adxb-pxthxn/pizza-oven/design/stream-1/README.md

# Stream 1

Long-vault prototypes after Morning and Moondancer. Gas, 15 inch pizza, no cordierite. The chamber is a rolled half-barrel, not a hemisphere. A stainless sky plate slides under the crown: in for pizza and bread, out for a broil. The floor is a free 6 mm normalised mild-steel plate. Jarrah and gidgee are the handles, the peel rest, the door pull, and the ferrules. The body is a 304 liner, ceramic-fibre blanket, an 8 mm air gap, and an aluminium skin.

Cool-down is the open door, sky plate lifted out, steel from its pizza equilibrium down to 60°C. The Tread figure is a 2.8 kg cordierite deck from 400°C through a lower mouth. Heat-up is a 6 kW burner with 35% of the fuel staying in the metal and the hot third of the blanket.

| | Tread | Morning | Moondancer | Stormcloud | Tyraxes | Arrax | Vermithor |
|---|---|---|---|---|---|---|---|
| Ready mass | 13.5 kg | 19.2 kg | 15.8 kg | 34.2 kg | 34.1 kg | 35.4 kg | **38.0 kg** |
| Plan | — | Ø572 × ~260 tall | Ø547 × ~250 tall | 973 × 670 × 410 | 928 × 714 × 410 | 990 × 714 × 410 | **1090 × 714 × 435** |
| Floor | stone | cordierite Ø420 × 15 | cordierite Ø420 × 15 | 450 × 500 × 6 | same plate | 480 × 500 × 6 | **same, 4 mm stops** |
| Mouth | low | 420 × 95 | 420 × 95 | arch shut | arch open | open, 90 mm sill | **open, grate in the arch** |
| Crown | — | apex 165 | apex 165 | r 250, L 680 | L 680 | L 680 | **L 780** |
| Skin | hot | 50°C wood | 55°C aluminium | 55.1°C | 55.1°C | 55.1°C | **55.1°C** |
| Underside | — | 60°C | 60°C | 55°C | 54°C | 54°C | **45°C pizza, 56°C bay** |
| Pizza floor | — | stone ~430°C | stone ~430°C | 309°C, gas 370°C | 301°C, gas 360°C | 301°C | **305°C, gas 360°C** |
| Scorch time | — | — | — | 122 s | 130 s | 130 s | **126 s** |
| Broil | — | — | — | 10.6 kW/m² | 10.6 kW/m² | 10.6 kW/m² | **10.6 kW/m², 240 mm bay** |
| Bread floor | — | — | — | 240°C shut | 240°C shut | 240°C shut | **216°C at gas 230°C** |
| Camber | — | — | — | 0.003 mm | 0.003 mm | 0.003 mm | **0.003 mm** |
| Open cool-down | benchmark | — | — | 42 min, 0.67× | 42 min, 0.66× | 42 min, 0.66× | **42 min, 0.67× Tread** |
| Heat-up | — | — | — | 23 min open | 22 / 14 min | 23 / 15 min | **24 min open, 15 min shut** |
| Carry | one person | tub | tub | two people | two people | two people | **two people, side handles** |
| Broil bay | — | — | — | — | — | plate covers the deck | **240 mm, plate slid back** |

Stormcloud is over the old 20 kg cap because the steel deck is 10.6 kg and the blanket is 75 mm on the arch. The cap was for a cordierite dome. A 6 mm plate is the thin end of the warp limit. The extra mass is the pizza steel and the fibre, not a timber costume.

Tyraxes is the pizza pose of that barrel. The door is parked on the port cheek, 3 mm clear of the skin, so the front view is the mouth. The burner cowl is 48 mm deep instead of 80 mm. Gas at 360°C holds the floor at 301°C, which gives 130 s before the face reaches 230°C. Door-shut heat-up is 14 min.

Arrax widens the plate to 480 mm inside the 500 mm barrel. The side gap is 10 mm against 1.95 mm of growth. Four stainless stops sit 4 mm off the plate, below the deck, so a launch cannot walk the plate onto the sill. The sill is 400 × 90 × 1.2 mm, 1 mm under the deck, 127 mm clear of the cold plate. Turning clearance is 49 mm each side of a 15 inch pizza. The extra kilogram is the wider plate.

Vermax lengthens the barrel to 780 mm so the same plate can slide back and leave a 240 mm bay. Five 4 mm rods sit in that bay, 20 mm below the mouth crown, so the front view shows the grate. Pizza numbers are with the plate slid forward. A 10 kW/m² crown on the bare bay still cambers a 6 mm plate by about 0.02 mm. The extra mass is shell, not deck. Cool-down stays 0.66× the Tread. Shut heat-up is 15 min.

Tessarion is that barrel with the plate forward and the door shut. The door bottom is at 63.4 mm and the sill top is at 60.4 mm, so the shop gap is 3 mm. Ready mass is 37.3 kg, the same as Vermax, because the rails run the full slide in both poses and the grate stays in the bay. The plate clears the rods when it slides forward. The earlier 214°C bread figure treated the mouth as open. Shut, gas at 260°C holds the floor at 240°C.

Sunfyre is the bread gas, 230°C, on this barrel.

Seasmoke is that oven with the handle load taken off the skin. A 2 mm stainless strap on each cheek, 0.4 mm clear of the aluminium, runs from the base wall up past the grip. The posts land on the strap. A 20 mm module is scribed on the sill and not on the cooking steel. A 160 × 120 mm steel tray sits in the broil bay, 44 mm under the grate. Parked, it sits outside the port skin, ahead of the grip. Timber battens on the skin were rejected: the skin is 55°C, and the wood stays on the grips. Ready mass is 38.9 kg. The heat figures are Vermithor's.

Sheepstealer is that oven with the skin cut flat. The barrel blank is the mid-thickness arc, 1050 mm, with 12 mm spring-line tabs and 4.2 mm rivets on a 40 mm pitch. The ends are half-rings, 2 mm clear of the liner, 8 mm clear of the fibre, so the blanket is covered and the liner is not bridged to the skin. Earlier masses counted a solid aluminium end the shop never cut; this one is 38.5 kg. A 4 mm K-type gland sits beside the arch, 0.4 mm clear of the liner and 5 mm clear of the fibre. The line under the base reads "be vigilant. don't die." A kick-stand was refused: a tilt walks the free plate onto the stops. One hinge cannot be the grip, the peel ledge, and the door.

Silverwing is that oven with a door that hinges. The arch stays mouth-sized. Two 2 mm straps reach a 8 mm pin at the port front corner, outboard of the skin, so a wing is not doing the reaching. Parked, the door lies along the port side, 31 mm clear of the skin. Shut, the same solid covers the arch and sits 3 mm above the sill and 103 mm clear of the skin. The post is welded to the base. The pin is a clearance fit. Ready mass is 38.7 kg. The heat figures are unchanged.

Grey Ghost is that hinge with a land. Silverwing's post bit the base wall by 90 mm³, a tack in 1 mm sheet. The post now comes down to the floor and laps 40 × 25 mm inside the front corner. The weld is 2173 mm³. The door numbers are unchanged. Ready mass is 38.7 kg.

Caraxes is that oven with a grip the hand can hook. An 11 mm hollow runs the middle 120 mm of each jarrah bar, where the fingers take the load. The top stays full, with a 3 mm arris so the corner does not dig, and the thumb stays off the skin. The end 8 mm is still a rectangle, so the gidgee ferrules press. Ready mass is 38.7 kg. The build now fails if a shell is open, a part is left invalid, or the steel bbox is not 480 × 500 × 6 mm. The shop sheet is `design/stream-1/caraxes/BUILD.md`.

Vermithor is the same heat without the straps or the tray. The floor blanket is 75 mm everywhere, because a step would tilt the plate. A bare broil bay under a 500°C crown runs near 436°C, and 50 mm of fibre let the underside there reach about 70°C. At 75 mm that underside is 56°C. Pizza floor is 305°C, scorch 126 s, pizza underside 45°C. Ready mass is 38.0 kg. Open cool-down is 0.67× the Tread from the pizza floor, and 0.77× even if the whole plate started at bay temperature. Bread gas 230°C, door shut, holds 216°C. Overall 1090 × 714 × 435 mm. Two people, high side handles.

Blanket is 25 mm ceramic fibre (3 on the arch, 2 under the floor). Skin is 1.0 mm aluminium. Air gap is 8 mm so it stays laminar. The plate is AS/NZS 3678-250, normalised, seasoned, not fastened. Stormcloud keeps 25 mm beside the liner. Arrax keeps 10 mm, with stops at 4 mm. Growth at 320°C is 2.0 mm. No zinc. No paint. No cordierite.

Files: `cad/freecad/stream_physics.py`, `cad/freecad/stream_optimize.py`, `optimizer.json`, `thermal-fea.json`.
