adxb-pxthxn/pizza-oven/design/stream-2/README.md

# Stream 2 — modular

Morning and Moondancer stay the round, short baselines. This stream is a stack in the spirit of a Hot Ash cooker: a fire pit, a floating steel hearth, a brow, and a tunnel. Gas only. The bought burner, valve, regulator, and hose are the same parts as the other ovens. No cordierite, no casting, no cut stone.

The floor is a 4 mm mild plate on three microporous pads. It is not bolted. In-plane growth is 1.7 mm and the side gap is 12 mm, so the plate cannot go into compression. Through-thickness bow at a 300°C soak is 0.002 mm. Self-weight sag on the long span is 0.27 mm. A 300°C steel face meets dough at 275°C. Cordierite at 450°C meets it at 289°C. The deck is run at 300°C on purpose.

The flame rises in the rear gutter, washes the soffit, and leaves by a front flue. The mouth is 0.63 of the front crown. At 550°C and a view factor of 0.65 the radiant flux is 13.8 kW/m². On Vhagar that surface is the plate over the steak, carried on 8 mm rods. The rack is 50 mm under it and travels with the plate. Bread uses the door, the damper, and a rope in the door gap. Wood is jarrah grips and feet, and a gidgee peel rest in front of the sill. The firebox walls are bare and run near 390°C. The handles stand off them. A mild plate rides under the rear overhang and stands on the rim when the hood is off. Jarrah panels stand off the brow. The door has 24 mm of air and a jarrah grip, so the face you hold is 54°C and the grip is 23°C. Dreamfyre hangs that door on a port pintle. Cannibal ties the inner plate to the skin, so the pintle carries the whole door. Quicksilver sets the hinge arms outside the door and welds the lower arm to the pit. Urrax stands the hood grip on a mild pad, so the aluminium is not the lift. Terrax does the same for the brow grip and the door grip. Slide the broiler plate aft for the pizza.

Masses are the analytical solid plus the 1.85 kg burner in the pit. Skin and underside are the CalculiX result, which matched the resistance sum. Costs are ESTIMATE, AUD, Adelaide, October 2026, bottle excluded.

Vermax was a tall empty box over a low soffit. Arrax cut the crown to the soffit. Shrykos folded that step. Morghul splits the fold. Seasmoke seats the brow and lifts the grate. Caraxes raises the roof over the pizza. Meleys puts a bail on the sill. Syrax shuts the damper. Sheepstealer puts a rope in the door gap. Vermithor slides the plate forward over the steak. Silverwing keeps that slide and changes the flats for rods. Vhagar stores a wind-back on the pit. Balerion stands jarrah off the brow. Meraxes puts air in the door and a grip on it. Dreamfyre hangs the door on a pintle. Cannibal ties the inner plate to that skin. Quicksilver sets the arms outside the door. Urrax stands the hood grip on a mild pad. Terrax does the same on the brow and on the door.

| | Tread | Morning | Moondancer | Vermax | Arrax | Shrykos | Morghul | Seasmoke | Caraxes | Meleys | Syrax | Sheepstealer | Vermithor | Silverwing | Vhagar | Balerion | Meraxes | Dreamfyre | Cannibal | Quicksilver | Urrax | Terrax |
|---|---|---|---|---|---|---|---|---|---|---|---|---|---|---|---|---|---|---|---|---|---|---|
| Ready mass | 13.5 kg | 19.2 kg | 15.8 kg | 36.1 kg | 32.2 kg | 30.6 kg | 30.6 kg | 31.0 kg | 32.4 kg | 32.5 kg | 32.6 kg | 32.6 kg | 33.8 kg | 33.0 kg | 33.4 kg | 33.5 kg | 33.6 kg | 34.0 kg | 34.0 kg | 34.0 kg | 34.0 kg | **34.1 kg** |
| Heaviest piece | the oven | the oven | the oven | hood 15.9 | hood 12.8 | hood 11.2 | pit 10.4 | pit 10.5 | pit 10.5 | pit 10.5 | pit 10.5 | pit 10.5 | pit 10.5 | pit 10.5 | pit 10.8 | pit 10.8 | pit 10.8 | pit 10.8 | pit 10.8 kg | pit 11.0 kg | pit 11.0 kg | **pit 11.0 kg** |
| Floor | small steel or stone | cordierite | cordierite | floating 4 mm mild | same plate | same plate | same plate | same plate | same plate | same plate | same plate | same plate | same plate | same plate | same plate | same plate | same plate | same plate | same plate | same plate | same plate | **same plate** |
| Mouth | low | 420 × 95 | 420 × 95 | 424 × 161 | 424 × 185 | 424 × 185 | 424 × 185 | 424 × 185 | 424 × 185 | 424 × 185 | 424 × 185 | 424 × 185 | 424 × 185 | 424 × 185 | 424 × 185 | 424 × 185 | 424 × 185 | 424 × 185 | 424 × 185 | 424 × 185 | 424 × 185 | **424 × 185** |
| Envelope | portable dome | Ø572 × ~250 | Ø547 × ~250 | 655 × 824 × 572 | square step | 45° cowl | split fold | shelf at the fold | 150 mm roof | bail on the sill | damper shut | rope in the gap | plate over the steak | 8 mm rods | wind-back stored | jarrah on the brow | grip on the door | pintle on the door | spacers in the door | arms clear the door | pad under the grip | **pad on the brow** |
| Outer skin | hot | 50°C wood | 55°C aluminium | 54.1°C | 55.0°C | 55.0°C | 55.0°C | 55.0°C | 55.0°C | 55.0°C | 55.0°C | 55.0°C | 55.0°C | 55.0°C | 55.0°C | 55.0°C | 55.0°C | 55.0°C | 55.0°C | 55.0°C | 55.0°C | **55.0°C** |
| Heat-up to a 300°C deck | — | — | — | 13 min | 10 min | 10 min | 10 min | 10 min | 11 min | 11 min | 11 min | 11 min | 11 min | 11 min | 11 min | 11 min | 11 min | 11 min | 11 min | 11 min | 11 min | **11 min** |
| Door shut, 240°C to 180°C | — | — | — | 63 min | 59 min | 60 min | 60 min | 60 min | 61 min | 61 min | 61 min | 61 min | 61 min | 61 min | 61 min | 61 min | 61 min | 61 min | 61 min | 61 min | 61 min | **61 min** |
| Door open, deck to 60°C | — | — | — | 27 min | 27 min | 27 min | 27 min | 27 min | 27 min | 27 min | 27 min | 27 min | 27 min | 27 min | 27 min | 27 min | 27 min | 27 min | 27 min | 27 min | 27 min | **27 min** |
| Fire pit | no | no | no | hood off | grate in the pit | grate in the pit | grate in the pit | grill and a deep fire | same pit | hearth lifts by wood | same pit | same pit | same pit | same pit | wind-back on the rim | same pit | same pit | same pit | same pit | same pit | same pit | **same pit** |

Terrax: pit 11.0 kg, hearth 9.1 kg, brow 5.8 kg, tunnel 8.3 kg. The brow grip, the tunnel grip, and the door grip each stand on a 1.5 mm mild pad. Posts sit 7.5 mm inside the edge and 1.5 mm clear of the skin. Quicksilver's pintle stays. The door face is 53.7°C and the grip is 23°C. Panels 21°C. Jarrah stays 3.4 mm off hot steel. The wind-back stays stored at Y 684. The broiler plate is still at Z 100 over Y 180 to 350, on 8 mm rods. The flux is still 13.8 kW/m². Length 871 mm. Pack cool-down is the deck, 27 min with the door open. SLSQP with the roof held reaches 33.3 kg at the 148 mm bound. The shop stack keeps 150 mm and 22 mm board. The door grip pulls the door. It is not a lift.

CalculiX on Terrax: slab 62.11°C against 62.11°C. Hood wall 54.95°C against 54.95°C. Underside 51.06°C against 51.11°C.

Shop: flat 4 mm plate, welded 0.6–1.0 mm mild flats, 0.6 mm aluminium flats. The sheet module is 20 mm for the pads, the wind-back, and a 100 mm rivet pitch. The mouth and the deck stay off it. University TIG. Makerspace lathe for the grips, ferrules, and feet. The CO2 lasers cut templates, not metal. The sequence is `design/stream-2/terrax/BUILD.md`.
