adxb-pxthxn/pizza-oven/design/stream-1/prompts/arrax.md

Arrax is the next long-vault oven after Tyraxes. Do not use tools. Reply in plain text.

The barrel is unchanged: internal radius 250 mm, so the cavity is 500 mm wide at the deck. The pizza is 381 mm. Tyraxes uses a 450 mm steel, which leaves 34.5 mm each side of the pizza.

Arrax widens the free plate to 480 mm. Side gap to the liner is (500 - 480) / 2 = 10 mm. In-plane growth at 320 C along 480 mm is about 1.9 mm. The plate stays free on the same six buttons.

A launch sill is added, stainless, 400 mm wide, 90 mm deep, 1.2 mm thick. It sits entirely forward of the front skin: 2 mm clear of y_front, top face 1 mm below the deck, so a peel slides up onto the floating plate and the plate can still grow. The jarrah peel rest stays lower, on the front wall, and must not touch the sill.

Confirm the 10 mm gap against the growth, and whether the sill can touch the plate. No file writes.
