adxb-pxthxn/pizza-oven/design/stream-1/prompts/caraxes.md

Caraxes is the next long-vault oven after Grey Ghost. Same heat, same door, same flat skin. Do not use tools. Reply in plain text.

The carry grips are jarrah bars, 140 by 28 by 36 mm, with an 8 mm groove along the lower edge. The oven is 38.7 kg, two people. A grip should give the thumb a land, the forefinger a hollow, and the palm some bulk. The end 8 mm of each bar stays a full rectangle so the gidgee ferrules still press on. In the middle 100 mm, an 11 mm radius hollow runs along the lower inner corner, and an 8 by 4 mm step is cut on the top inner edge for the thumb. The wood stays on the 20 mm standoff. It does not move onto the skin.

Is that a grip that earns the cut, or is the step carving for its own sake? A few sentences. No file writes.
