adxb-pxthxn/pizza-oven/design/stream-1/prompts/seasmoke.md

Seasmoke is the next long-vault oven after Vermithor. Do not use tools. Reply in plain text.

Three changes, and one refusal. The skin stays bare aluminium. Timber battens on that skin were considered and rejected: the skin is about 55 C, and wood stays on the grips, the ferrules, the peel rest, and the door pull.

The module is 20 mm, from a sheet grid that divides the 480 mm floor. It is scribed on the launch sill only, 0.3 mm deep. It is not cut into the cooking steel.

Each cheek gets a 2 mm stainless strap on the outside of the skin, 0.4 mm clear of it, from the spring line up past the grip, with a tab down the base wall. The handle posts land on the strap. They do not land on the 1 mm skin, and they do not bridge the insulation to the hot liner.

A stainless tray, 160 by 120 mm, sits in the broil bay 90 mm above the deck, under the grate rods. It is steel, not cast iron. There is no wood on it. Parked, the same tray would sit outside the port skin, ahead of the grip.

Is the strap the right place for the handle load, and is the tray in the bay a real heat tool rather than a symbol? A few sentences. No file writes.
