adxb-pxthxn/pizza-oven/design/stream-1/prompts/sheepstealer-answer.md

The refusals are right. Tilting a floating 6 mm floor on greased domed buttons dumps its in-plane load into the stops, creating a thermal short and a bind risk when hot, while a four-bar linkage on the cheek just to hit three incompatible coordinates and save 110 grams of jarrah trades reliable passive parts for a binding mechanism in a grease-and-heat zone.

The developed 1.0 mm skin flat and the mouth-frame gland are the exact parts worth making. Cutting the mouth, burner slot, and 4.2 mm rivet pitch in the flat on the mid-thickness arc eliminates post-form trimming and guarantees repeatable assembly, while putting the 4 mm K-type gland in the rigid stainless mouth frame gives an honest, repeatable reading without tearing up the ceramic fibre blanket or resorting to a fake dial. Scribing the deadpan line 0.3 mm into the underside of the base plate keeps the cooking face clean and delivers the hidden note for free in the same laser setup.
