adxb-pxthxn/pizza-oven/design/stream-1/prompts/tessarion.md

Tessarion is the bread pose of the 780 mm barrel. Do not use tools. Reply in plain text.

The launch sill is 1.2 mm thick and its top is 1 mm below the deck. It runs from 92 mm in front of the front skin to 2 mm in front of that skin. The shut door is 13.6 mm thick and sits 2 mm off the front skin, so its Y range overlaps the inner end of the sill.

If the door keeps an 18 mm border below the deck, it cuts the sill. Tessarion starts the door 0.6 mm above the deck instead, so the arch still covers the mouth and the door stays clear of the sill. The sky plate is forward, over the deck. There is no grate in this pose.

Confirm that a door bottom 0.6 mm above the deck clears a sill whose top is 1 mm below the deck. No file writes.
