adxb-pxthxn/pizza-oven/design/stream-1/prompts/tyraxes.md

Tyraxes is the next long-vault pizza oven after Stormcloud. Do not use tools. Reply in plain text.

The chamber stays a rolled half-barrel, internal radius 250 mm, length 680 mm, mouth a half-ellipse 430 mm wide by 158 mm high. Outer skin radius is 334.8 mm. The port grip occupies about x -299 to -254, y 270 to 410, z 288 to 333.

Stormcloud's door is shut on the mouth, so the front view hides the opening. Tyraxes parks that same arched door on the port cheek for the pizza pose:

- Face in the YZ plane, thickness along X, about 13.6 mm (two 0.8 mm skins and 12 mm fibre).
- Entire door at x more negative than -(skin radius + 3 mm), so it misses the skin, the base, and the grip.
- Arch span along Y equals the door width (mouth 430 plus 36 mm of border), starting just behind the front skin.
- Pull on the outer face, 12 mm clear of the door.
- Do not swing the shut door 90 degrees about the front jamb. That sweep cuts the shell.

The burner cowl depth drops from 80 mm to 48 mm. Pizza gas is 360 C. Confirm whether this placement leaves the mouth uncovered in a front view, and give the door x and y extents in millimetres. No file writes.
