adxb-pxthxn/pizza-oven/design/stream-1/prompts/vermax.md

Vermax is the broil pose of the long-vault oven. Do not use tools. Reply in plain text.

The barrel is lengthened from 680 mm to 780 mm. Internal radius stays 250 mm. The sky plate is 480 mm long. In this pose it sits at the rear: its back edge is 20 mm clear of the rear liner, so its front edge is at y = 280 mm. The steel deck starts at y = 40 mm. The open bay in front of the plate is 240 mm long.

Five stainless rods, 4 mm diameter, sit in that bay at 20 mm below the top of the mouth. The mouth rises 158 mm above the deck, so the rods are inside the front opening. They stop 12 mm short of the sky plate.

Confirm the bay length and that the rods are visible through the mouth. Say if 240 mm is enough for a single steak under the crown while the rest of the deck stays under the plate. No file writes.
