adxb-pxthxn/pizza-oven/design/stream-1/prompts/vermithor.md

Vermithor is the long-vault oven with a thicker floor blanket. Do not use tools. Reply in plain text.

A bare broil bay under a 500 C crown equilibrates near 436 C. With 50 mm of ceramic fibre under the steel, the underside there is about 70 C, over the 60 C touch limit. The plate has to stay flat, so the blanket cannot be thicker only under the bay or the buttons would tilt the steel.

75 mm under the whole floor brings that underside to about 56 C. Pizza mode then holds the shielded floor at 305 C, scorch time 126 s, underside 45 C. Added mass is about 0.8 kg. The plate is still free, still 6 mm, camber still under 0.01 mm.

Is a uniform 75 mm blanket the right fix, given the plate cannot sit on a step? A few sentences. No file writes.
