adxb-pxthxn/pizza-oven/design/stream-2/balerion/argon-panel.md

Argon checked the panels. Each jarrah plate sits 8 mm off the brow skin. The washer butts the wood and the post butts the skin. Those faces are the joints. No press, no correction.
