adxb-pxthxn/pizza-oven/design/stream-2/dreamfyre/argon-hinge.md

Argon checked the pintle. Radial gap 0.6 mm. The barrel sits 0.4 mm above the arm and 0.8 mm under the head. The straps meet the barrels on the tangent and do not enter the wall. The leaves share a face with the port skin. The high leaf stays 8 mm clear of the jarrah panel. The door can turn until the skin meets the arm, about 127°. FreeCAD common volume on every other pair is zero.
