adxb-pxthxn/pizza-oven/design/stream-2/meraxes/argon-door.md

Argon checked the door. The grip clears the bail by about 76 mm in Z. The 24 mm air gap is empty. The posts butt the outer skin. FreeCAD common volume on every other pair is zero. The ferrule press is the one overlap.
