adxb-pxthxn/pizza-oven/design/stream-2/quicksilver/argon-swing.md

Argon checked the swing pintle. The low arm shares a face with the pit wall at y=-1 and ends 35.5 mm under the door. The high leaf shares the skin's outer face at x=-270 and starts 1.0 mm above the door. It meets the high barrel on the tangent only. Pin radial clearance is 0.6 mm in all three bores. The collar is 0.4 mm under the lower barrel. The pin ends 0.4 mm inside the top barrel. The leaf clears the jarrah panel by 14.7 mm. No pair shares volume.
