adxb-pxthxn/pizza-oven/design/tailgate/prompts/03-20kg.md

You are the design engineer closing a weight budget on an existing oven. The coordinator will build the CAD from your locked numbers and will reject a total that does not add up. Show every mass as volume times density. Show every temperature with the resistance sum below. Prices are ESTIMATE, AUD, Adelaide, October 2026. Do not invent a workshop machine. Do not design a burner jet, orifice, or injector. No galvanised or zinc-plated part in the hot gas path. No household fibreglass. No GRP near the heat.

## Task

Rework the Angas 430 into two variants. No new oven. Keep the Angas layout: circular dome, the same mouth, the burner in a crescent beside the stone, the crown lifting off a cinch band above the arch so the lintel is not split, the stone removed by lifting the crown (it does not pass the mouth).

Hard target: 20.0 kg maximum each, stone included. The benchmark is the Gozney Tread at 13.5 kg. Tread is a 12 inch single-layer oven, external about 418 × 484 × 320 mm, 12 mm cordierite, one fibre layer, SPCC pressings, shell runs hot, nameplate 3.7 kW. This oven still cooks a 15 inch pizza and keeps a safe outer surface. You will be heavier than 13.5 kg. Say which kilograms buy the larger floor and the cool skin.

Variant A, Wood. An Angas-based wood body with metal accents, brass and jarrah where the hand and the eye expect them. Sized so Makerspace Adelaide can make the wood. Variant B, Optimal. The best Angas-based design under 20 kg, with no aesthetic constraint. B may drop brass and jarrah if a lighter joint and a lighter grip win. B does not become a box, a clamshell pressing, or a castable dome.

Both variants, handles: Tread-style. High on the sides, sitting on the upper edge radius of the dome near the top, for a two-handed carry out of the ute. Not the old low bars that stuck the span out to 1165 mm. Cool enough to grab with a bare hand. Their mass is inside the 20 kg.

Future upgrades, design the interface, do not build the accessory and do not add its mass: a top rack, and a Tread-style stand. Leave bosses, slots, or a bolt pattern on the crown and on the base. Count the mass of those small features. The old 750 mm tripod tubes are not in this model.

## Cooking geometry you keep unless a millimetre is required to close the mass

These are the modelled Angas 430 numbers. Change one only if you show the pizza still turns and the mouth still matches the dome.

- Floor was Ø430 × 20 mm cordierite, density 2100 kg/m³. A 381 mm pizza needs turning clearance. 420 mm is the floor of the requirement. 20 mm is the portable soak. 12 mm dumps its heat mid-pizza. If you thin or shrink the stone, name the cooking cost.
- Chamber inside diameter 470 mm. Stone shifted to one side so a crescent remains for the bought burner.
- Mouth 420 mm wide × 95 mm high. Apex 165 mm above the stone (cylindrical skirt 120 mm, dome rise 45 mm). Mouth/apex = 0.576.
- Skirt stays taller than the mouth so the cinch is a complete ring above the arch.
- Bought certified burner. Allowance, not a solid you invent. The baseline allowance is 1.85 kg. You may use a lower allowance only if you name the class of bought assembly (burner bar, thermocouple, flame-failure valve, no jet) and a mass you can defend. Do not drop it to zero.
- Gas only. Wood fire stays out.
- Plan wider than about 480 mm does not sit on the lowered tailgate (517 mm deep). Do not fire it there: 0.3 m clearance to the ute is not available. Short feet for a camp table. Body height under 460 mm. Width between the Shark wheel arches is 1224 mm.

## Baseline you are cutting, ready mass 37.56 kg

Modelled envelope Ø674.8 mm, body height 340.1 mm. Handles were Ø32 × 220 mm jarrah at 40 mm above the hearth, stood off 35 mm. That placement is replaced.

Wall: 1.2 mm 304 liner, 75 mm AES, 25 mm calcium silicate, 1.2 mm 304 skin.
Crown: 1.2 mm 304, 100 mm AES, 1.2 mm 304.
Floor stack: 1.5 mm base pan, 25 mm AES, 25 mm calcium silicate, 1.2 mm stone pan, 20 mm stone.
Brass cinch 35 × 3 mm. Three jarrah stub feet 65 mm tall.

Mass from solid volumes: steel 18.3 kg (the Ø675 × 1.5 mm base pan alone is about 4.2 kg), AES 6.33 kg, calcium silicate 2.34 kg, cordierite 6.10 kg, brass 2.11 kg, jarrah 0.53 kg, burner allowance 1.85 kg. Sum 37.56 kg.

Skin, same 1D method as below: wall 52.8°C, crown 54.5°C.

## Thermal method

500°C gas, 20°C air, h_in = 25 W/m²K, h_ext = 10 W/m²K.
R = 1/h_in + sum(thickness_m / k) + 1/h_ext
flux = (500 − 20) / R
T_outer = 20 + flux / h_ext
The temperature at an interface is 20 + flux × (sum of resistances from that interface out to ambient).

k: 304 stainless 16; AES blanket 0.08 at density 128 kg/m³; calcium silicate board 0.065 at 250 kg/m³; hardwood 0.16.
A microporous board, if you use one, is a real class: k about 0.022 to 0.030 W/mK and density about 200 to 300 kg/m³. State the pair you use and keep it consistent. An aerogel blanket class is k about 0.020 and density about 180 kg/m³, and it is the expensive line. Do not invent a k below 0.018.
Aluminium, if the outer skin is aluminium, density 2700 kg/m³, and it is not the food-side liner. The liner that sees the flame stays 304. Outer aluminium is only legitimate where the skin temperature you calculate stays far below the point the alloy softens.

Limits: wood inner face at or under 80°C. A bare metal surface a person might lean on at or under 60°C. Handles a bare hand can close on, cooler than the shell. Compute the grip, do not call a stainless bar on a stainless dome cool because the shell is 55°C.

## Where the kilograms are allowed to come out

Thinner gauges, a thinner or smaller stone, lighter insulation, trimmed handles and feet, a shorter cinch section, bosses instead of long legs. Keep a 15 inch pizza and the surface limits above. The 20.0 kg total includes the stone, the burner allowance, the handles, the feet that stay on the oven, and the rack and stand interfaces. It excludes the rack and the stand.

## Makerspace Adelaide, the only machines you may name

- Thunder Nova35 CO2 laser, 900 × 600 mm, and Trotec Q500, 1300 × 900 mm. Wood, acrylic, card. Not a stainless cutter.
- WorkBee CNC router. Wood and plastics, not a metal mill. Bed size unpublished.
- Wood shop: table saw, drop saw, thicknesser, scroll saw, workbenches. No published lathe swings a 600 mm drum. Do not design a bowl-turned body.
- Metal shop: cold cut saw, a welder of unnamed process, a lathe that will take rings, bushes, handles, ferrules, and a badge, not a 500 mm hoop, a mill, hand tools. No press brake, fibre laser, waterjet, English wheel, or spinning lathe is published.
- University workshop, process unnamed beyond this: TIG of stainless, and rolling or braking thin 304. Say "university workshop" next to any part that needs that. Makerspace does the wood, the board trimming, the MDF bucks, the brass and the handle turning.

Variant A wood body: coopered or segmented on the table saw and thicknesser, trued on the WorkBee or by hand. It should read as a turned round body. A lathe pass is for handles, ferrules, and small rings. Species that make sense in Adelaide: blackwood about 640 kg/m³, jarrah about 820. Design for rain, for movement across the diameter, and for a film finish. End grain and the wood-to-metal joint are the design. A sealed air gap between a hot metal skin and wood is a radiation problem, not insulation. Do not rely on vent slots.

## What to return

1. Variant A, first pass. Dimensioned stack, then a part table: name, geometry, volume cm³, density, kg. Sum the column in view of the reader.
2. Variant B, first pass. Same.
3. Self-critique of A only. Three failures in the first pass (arithmetic, a temperature over the limit, pizza clearance, handle heat, a machine the shop does not have, or a crown that no longer lifts). Then the revised locked design.
4. Self-critique of B only. Same shape.
5. Locked parameter block for A and for B. Plain numbers. Every thickness, diameter, height, handle position (height above the hearth, radial standoff, grip length and diameter, material, thermal break), boss thread and pitch circle for the rack, bolt pattern for the stand, and the kg of each solid. Ready mass on its own line, and it is ≤ 20.0.
6. Comparison table with four rows of content: ready mass kg, cost AUD estimate, outer skin temperature °C, build difficulty. Columns: Tread (benchmark, mass 13.5, the rest "not this oven"), Angas 430 baseline, Variant A, Variant B.
7. Two short paragraphs: where the kilograms came out of A, and where they came out of B, relative to 37.56 kg.

If a revised total is over 20.0 kg, it is not locked. Cut again inside the same critique until it closes, and say what you gave up.
