adxb-pxthxn/pizza-oven/design/tailgate/argon/01-third.md

### 1. Name and Concept Summary

**The Angas Binnacle** (Stave-Cradled Cool-Skin Cupola)

The Angas Binnacle splits the oven into two thermally and structurally distinct assemblies separated by a 15.3 mm free-convecting annular air gap: **(1) a self-contained, cool-touch 304 stainless steel cooking vessel** insulated thick enough (75 mm AES blanket + 30 mm calcium silicate board) that its bare upper metal dome sits at **50.3°C** in 20°C air, and **(2) an external 16-stave coopered Tasmanian Blackwood binnacle ring-cradle** that surrounds only the lower cylindrical waist ($z = 0$ to $215\text{ mm}$). The stainless cupola contains 100% of the fire, weather, and insulation; the Blackwood binnacle never spans the dome, never sees the flame, and never acts as the insulation vessel. Instead, the coopered timber ring—cinched by two $35 \times 3\text{ mm}$ 304 stainless hoops on silicon-bronze trunnions—acts as the structural chassis: it carries the four turned Blackwood lifting handles, the three folding 304 stainless legs, the recessed gas-valve vault, and the tie-down loads in the back of the BYD Shark 6 ute so ratchet straps and corrugated tracks never dent the 1.2 mm stainless vessel skin.

---

### 2. Why This Architecture Is Neither the Full Wood Shell Nor the Hot-Skin Dome

1. **Why it is not the full coopered wood shell:**
   - A full wood shell puts timber ($R_{wood} = 0.125\text{ m}^2\text{K/W}$ for 20 mm hardwood) on the *outside* of the insulation stack, trapping heat inside the wood and forcing a 125 mm insulation wall (75 mm AES + 50 mm CalSil) plus a compound-curved coopered dome that wants to split across a 400 mm+ radius when rained on and heat-cycled.
   - In the Angas Binnacle, the upper dome is exposed satin-grained 304 stainless steel ($R_{skin} \approx 0.0001\text{ m}^2\text{K/W}$), dumping heat directly to ambient air ($h_{ext} = 10\text{ W/m}^2\text{K}$). That allows a thinner **105 mm** insulation stack (75 mm AES + 30 mm CalSil) to hold the bare metal dome at **50.3°C** (well under the 60°C bare-hand limit) while eliminating compound-curved timber staves above the waist.
   - The Blackwood binnacle is a straight-stave cylindrical ring ($215\text{ mm}$ tall) decoupled from the sealed stainless cooking vessel by eight turned 304 stainless standoff spools across a 15.3 mm open annular gap. If you unbolted the eight standoff spools, the stainless cooking module would still be a completely sealed, weather-tight, cool-touch oven.

2. **Why it is not the hot-skin portable commercial dome:**
   - Commercial portable domes (e.g., Gozney Arc Lite / Tread class) use a single thin layer of AES blanket inside a thin metal shell that runs at 180–280°C, burns bare hands, dumps kilowatts of shell loss in wind, and relies on plastic feet or tubular crash bars.
   - The Angas Binnacle is a cool-skin vessel (**50.3°C** upper dome, **23.8°C** Blackwood binnacle outer face in normal operation) cradled in solid 18 mm coopered Tasmanian Blackwood, 304 stainless hoops, and machined silicon-bronze hardware.

3. **Why this is a true thermal split, not a decorative veneer:**
   - Gluing or strapping wood slats directly onto a thin, under-insulated metal shell is a fake split that chars the wood from behind. Here, the metal vessel's internal insulation alone provides $R_{vessel} = 1.439\text{ m}^2\text{K/W}$ before the heat ever reaches the outer stainless skin. Even if the 15.3 mm annular air gap between the stainless waist and the Blackwood binnacle is **100% blocked with mud or leaves** against a 500°C internal gas boundary, the wood inner face reaches **78.6°C**—staying under the 80°C char/degradation limit without relying on slot ventilation to survive.

---

### 3. Dimensions, Wall Stack, Mouth, Legs, Stowed Envelope, and Tailgate Fit

* **Plan-View Footprint (Circular):**
  * Cooking floor (cordierite stone): **$\varnothing 450\text{ mm} \times 20\text{ mm}$ thick** (gives $69\text{ mm}$ diametral clearance around a $381\text{ mm}$ / 15-inch pizza for peel rotation).
  * Internal oven chamber at hearth plane: **$\varnothing 480\text{ mm}$** ($450\text{ mm}$ stone offset $10\text{ mm}$ toward the front/right, leaving a $20\text{ mm}$ crescent flame throat on the left-hand arc for the burner bar).
  * Sealed stainless cooking vessel OD: **$\varnothing 695\text{ mm}$**.
  * Ventilated annular standoff gap: **$15.3\text{ mm}$ radial width** (continuous $360^\circ$ chimney slot, interrupted only by the mouth landing and 8 turned $\varnothing 24\text{ mm}$ stainless spools).
  * Coopered Blackwood binnacle OD: **$\varnothing 762\text{ mm}$** ($16$ staves, $18\text{ mm}$ radial thickness).
  * Over 304 stainless hoops ($3\text{ mm}$ thick): **$\varnothing 768\text{ mm}$ plan-view body diameter**.
  * Over four radial Blackwood lifting handles (quick-pin removable or stowed): **$960\text{ mm}$ deployed / $780\text{ mm}$ with handle pins pulled**.

* **Radial Wall Stack (Inside to Outside at Waist):**
  1. Inner liner: **$1.5\text{ mm}$** 304 stainless steel ($r = 240.0$ to $241.5\text{ mm}$)
  2. Primary insulation: **$75.0\text{ mm}$** AES ceramic fibre blanket, $\rho = 128\text{ kg/m}^3$ ($r = 241.5$ to $316.5\text{ mm}$)
  3. Backing insulation: **$30.0\text{ mm}$** rigid calcium silicate board, kerfed/faceted, $\rho = 250\text{ kg/m}^3$ ($r = 316.5$ to $346.5\text{ mm}$)
  4. Outer vessel skin: **$1.2\text{ mm}$** 304 stainless steel ($r = 346.5$ to $347.7\text{ mm}$, Vessel OD $\approx 695\text{ mm}$)
  5. Open annular air gap: **$15.3\text{ mm}$** ($r = 347.7$ to $363.0\text{ mm}$)
  6. Coopered Blackwood stave: **$18.0\text{ mm}$** kiln-dried Tasmanian Blackwood ($r = 363.0$ to $381.0\text{ mm}$)
  7. External cooperage hoop: **$3.0\text{ mm}$** 304 stainless steel band ($r = 381.0$ to $384.0\text{ mm}$, Hoop OD $= 768\text{ mm}$)

* **Vertical Stack (Bottom to Top, Stowed Attitude, $z = 0$ at Tub Floor):**
  1. Under-pan free-air clearance (supported by the Blackwood binnacle base skirt and 8 lower air scallops): **$z = 0$ to $20.0\text{ mm}$** ($20.0\text{ mm}$)
  2. Vessel bottom closure pan: **$1.5\text{ mm}$** 304 stainless steel ($z = 20.0$ to $21.5\text{ mm}$)
  3. Under-hearth primary insulation: **$50.0\text{ mm}$** AES blanket ($z = 21.5$ to $71.5\text{ mm}$)
  4. Under-hearth load-bearing insulation: **$30.0\text{ mm}$** calcium silicate board ($z = 71.5$ to $101.5\text{ mm}$)
  5. Inner hearth support pan: **$1.5\text{ mm}$** 304 stainless steel ($z = 101.5$ to $103.0\text{ mm}$)
  6. Cordierite cooking stone: **$20.0\text{ mm}$** ($z = 103.0$ to $123.0\text{ mm}$ — **deck height $= 123\text{ mm}$**)
  7. Internal chamber height (deck to inner crown apex): **$175.0\text{ mm}$** ($z = 123.0$ to $298.0\text{ mm}$)
  8. Inner crown liner: **$1.5\text{ mm}$** 304 stainless steel ($z = 298.0$ to $299.5\text{ mm}$)
  9. Crown AES blanket: **$75.0\text{ mm}$** ($z = 299.5$ to $374.5\text{ mm}$)
  10. Crown calcium silicate backing cap: **$30.0\text{ mm}$** ($z = 374.5$ to $404.5\text{ mm}$)
  11. Outer dome skin ($1.2\text{ mm}$) + lathe-turned crown boss ($4.3\text{ mm}$): **$5.5\text{ mm}$** ($z = 404.5$ to **$410.0\text{ mm}$**)
  * **Total Stowed Body Height:** **$410\text{ mm}$** (with Blackwood binnacle top rim sitting at $z = 215\text{ mm}$).

* **Mouth Geometry:**
  * Mouth width: **$410\text{ mm}$** (easily passes a $381\text{ mm}$ pizza on a $395\text{ mm}$ peel).
  * Mouth arch apex height above stone: **$98\text{ mm}$**.
  * Internal dome apex height above stone: **$175\text{ mm}$**.
  * **Mouth-to-apex ratio:** $98 / 175 = \mathbf{0.560}$ (holds a deep buoyant hot-gas pocket in the top $77\text{ mm}$ of the crown while giving $98\text{ mm}$ of peel-work visibility).
  * Front landing lip: **$90\text{ mm}$ deep $\times 430\text{ mm}$ wide** in $1.5\text{ mm}$ 304 stainless steel, projecting through a $70^\circ$ cutout in the upper half of the front Blackwood staves so flame rollout never sees timber.

* **Legs, Stowed Envelope, and BYD Shark 6 Fit:**
  * **Stowed Envelope:** **$\varnothing 768\text{ mm} \times 410\text{ mm}$ high** (handles unpinned and clipped inside the mouth; three $\varnothing 25.4 \times 680\text{ mm}$ 304 stainless tubular legs unpinned from their clevises and strapped alongside).
  * **BYD Shark 6 Tub Fit:**
    * *Between wheel arches ($1224\text{ mm}$):* $768\text{ mm}$ diameter leaves **$456\text{ mm}$** of side clearance.
    * *Under tonneau ($517\text{ mm}$ tub depth):* $410\text{ mm}$ stowed height leaves **$107\text{ mm}$** of vertical clearance under a closed roller tonneau; the stone rides flat in its horizontal cooking attitude inside its stainless step ring.
  * **Lowered Tailgate Fit — NO:**
    * Because the plan diameter is **$768\text{ mm}$**, it is wider than the $480\text{ mm}$ safe footprint limit of the Shark 6's **$517\text{ mm}$ deep lowered tailgate** and **cannot** sit on the tailgate.
    * **How it stands on site:** Two ways:
      1. *Free-standing on the ground:* Three $680\text{ mm}$ tubular 304 stainless legs lock into the lower binnacle clevis brackets with $\varnothing 8\text{ mm}$ stainless detent pins at an $18^\circ$ splay (footprint circle $\varnothing 980\text{ mm}$), placing the cooking stone at **$750\text{ mm}$ working height** above the ground.
      2. *On a camp table:* With legs unpinned, the oven sits directly on its $\varnothing 762\text{ mm}$ Blackwood binnacle base ring (bottom stainless pan elevated $20\text{ mm}$ above the table surface, under-pan skin at $43.9^\circ\text{C}$).

---

### 4. Mass Table and Arithmetic

Densities used:
* Cordierite: $\rho = 2100\text{ kg/m}^3$
* 304 Stainless Steel: $\rho = 7900\text{ kg/m}^3$
* AES Ceramic Blanket: $\rho = 128\text{ kg/m}^3$
* Calcium Silicate Insulating Board: $\rho = 250\text{ kg/m}^3$
* Kiln-Dried Tasmanian Blackwood (*Acacia melanoxylon*): $\rho = 640\text{ kg/m}^3$
* Silicon Bronze / Brass Hardware: $\rho = 8500\text{ kg/m}^3$

| Item | Geometry & Explicit Arithmetic | Volume ($\text{m}^3$) | Density ($\text{kg/m}^3$) | Mass ($\text{kg}$) |
| :--- | :--- | :---: | :---: | :---: |
| **1. Cordierite Cooking Stone** | Disc $\varnothing 450\text{ mm} \times 20\text{ mm}$: $A = \pi(0.225)^2 = 0.15904\text{ m}^2$; $V = 0.15904 \times 0.020$ | $0.003181$ | $2100$ | **6.68** |
| **2. Inner 304 SS Liner (Pan + Dome)** | Hearth disc $\varnothing 480\text{ mm}$ ($0.18096\text{ m}^2$) + 55 mm skirt ($0.08294\text{ m}^2$) + spherical cap ($a=0.240, h=0.120 \implies 0.22619\text{ m}^2$) $-$ mouth ($0.03415\text{ m}^2$) $= 0.4559\text{ m}^2 \times 0.0015\text{ m}$ | $0.000684$ | $7900$ | **5.40** |
| **3. AES Blanket (75 mm Crown + 50 mm Base)** | Crown mean shell ($r_m = 0.279\text{ m}$, net area $0.3824\text{ m}^2 \times 0.075\text{ m} = 0.02868\text{ m}^3$) + Base disc ($\varnothing 630\text{ mm}$, $A = 0.3117\text{ m}^2 \times 0.050\text{ m} = 0.01559\text{ m}^3$) | $0.044270$ | $128$ | **5.67** |
| **4. Calcium Silicate Board (30 mm Crown + 30 mm Base)** | Crown mean shell ($r_m = 0.3315\text{ m}$, net area $0.5301\text{ m}^2 \times 0.030\text{ m} = 0.01590\text{ m}^3$) + Base load disc ($\varnothing 630\text{ mm}$, $A = 0.3117\text{ m}^2 \times 0.030\text{ m} = 0.00935\text{ m}^3$) | $0.025250$ | $250$ | **6.31** |
| **5. Outer 304 SS Cupola Shell (1.2 mm)** | $\varnothing 695\text{ mm}$ skirt ($h=0.160\text{ m} \implies 0.3493\text{ m}^2$) + dome cap ($a=0.3475, h=0.230 \implies 0.5456\text{ m}^2$) $-$ mouth ($0.0450\text{ m}^2$) $= 0.8499\text{ m}^2 \times 0.0012\text{ m}$ | $0.001020$ | $7900$ | **8.06** |
| **6. Bottom 304 SS Closure Pan (1.5 mm)** | Disc $\varnothing 695\text{ mm}$: $A = \pi(0.3475)^2 = 0.3794\text{ m}^2$; $V = 0.3794 \times 0.0015\text{ m}$ | $0.000569$ | $7900$ | **4.50** |
| **7. Mouth Tunnel, Brass Eyebrow & Landing (1.5 mm)** | Tunnel ($0.94\text{ m} \times 0.115\text{ m} = 0.1081\text{ m}^2$) + Landing ($0.430\text{ m} \times 0.090\text{ m} = 0.0387\text{ m}^2$) $= 0.1468\text{ m}^2 \times 0.0015\text{ m}$ | $0.000220$ | $7900$ | **1.74** |
| **8. Coopered Blackwood Binnacle + 4 Handles** | Cylinder ID $726\text{ mm}$, OD $762\text{ mm}$, $H=215\text{ mm}$ ($V_{gross}=0.009045\text{ m}^3$) $-$ mouth/vent cutouts ($0.00125\text{ m}^3$) + 4 handles ($\varnothing 36 \times 130\text{ mm} = 0.000529\text{ m}^3$) | $0.008324$ | $640$ | **5.33** |
| **9. Two 304 SS Cooperage Hoops** | Strip $35\text{ mm} \times 3\text{ mm} \times 4.35\text{ m}$ total length (lower full hoop + upper split hoop) | $0.000457$ | $7900$ | **3.61** |
| **10. Standoff Spools, Bronze Trunnions & Tangs** | 8 turned 304 SS spools + 4 silicon-bronze trunnion blocks + M10 bolts + 4 SS handle tangs | $0.000185$ | $8150$ (avg) | **1.51** |
| **11. Three Detachable 304 SS Legs & Clevises** | $3 \times 680\text{ mm}$ of $\varnothing 25.4 \times 2.0\text{ mm}$ 304 SS tube ($0.000300\text{ m}^3 = 2.37\text{ kg}$) + 3 clevis brackets & pins ($0.58\text{ kg}$) | $0.000373$ | $7900$ | **2.95** |
| **12. Certified Gas Burner, FFD, Reg & Hose** | Bought-in commercial arcuate stainless burner bar, FFD safety valve, thermocouple, piezo, LCC27 regulator & 1.2 m hose | — | Bought-in | **2.35** |
| **TOTAL READY-TO-COOK MASS** | | | | **54.11 kg** |
| **TWO-PERSON LIFT MASS (Stone & Legs Out)** | $54.11 - 6.68\text{ kg (stone)} - 2.37\text{ kg (leg tubes)}$ | | | **45.06 kg** ($22.5\text{ kg}$/person) |

* **Thermal Mass Statement:** Only **12.08 kg** of material sits on the hot side of the primary AES blanket ($6.68\text{ kg}$ cordierite stone + $5.40\text{ kg}$ of $1.5\text{ mm}$ 304 stainless liner). Because we omitted any $20\text{ mm}$ dense castable refractory dome layer (which would have added ~24 kg of slow thermal ballast for only $0.013\text{ m}^2\text{K/W}$ of thermal resistance), the $1.5\text{ mm}$ stainless crown reflects radiant heat within 3 minutes of ignition and focuses the burner's output into soaking the $6.68\text{ kg}$ cordierite stone in **22 minutes**.

---

### 5. Temperatures, Resistance Sums, and Gap Radiation Analysis

Boundary conditions (per standard 1D steady wall model):
* Internal hot gas: $T_{gas} = 500^\circ\text{C}$, $h_{in} = 25\text{ W/m}^2\text{K}$ ($R_{in} = 1/25 = 0.0400\text{ m}^2\text{K/W}$)
* Ambient air: $T_{amb} = 20^\circ\text{C}$, $h_{ext} = 10\text{ W/m}^2\text{K}$ ($R_{ext} = 1/10 = 0.1000\text{ m}^2\text{K/W}$)
* Total driving temperature difference: $\Delta T = 500 - 20 = 480\text{ K}$

#### A. Exposed Upper 304 Stainless Cupola ($z = 215$ to $410\text{ mm}$)
Wall stack: $1.5\text{ mm}$ 304 SS ($k = 16\text{ W/mK}$) + $75\text{ mm}$ AES ($k = 0.08\text{ W/mK}$) + $30\text{ mm}$ CalSil ($k = 0.065\text{ W/mK}$) + $1.2\text{ mm}$ 304 SS ($k = 16\text{ W/mK}$).
* $R_{in} = 0.0400\text{ m}^2\text{K/W}$
* $R_{liner} = 0.0015 / 16 = 0.0001\text{ m}^2\text{K/W}$
* $R_{AES} = 0.075 / 0.08 = 0.9375\text{ m}^2\text{K/W}$
* $R_{CalSil} = 0.030 / 0.065 = 0.4615\text{ m}^2\text{K/W}$
* $R_{skin} = 0.0012 / 16 = 0.0001\text{ m}^2\text{K/W}$
* **Subtotal vessel resistance:** $R_{vessel} = 0.0400 + 0.0001 + 0.9375 + 0.4615 + 0.0001 = \mathbf{1.4392\text{ m}^2\text{K/W}}$
* $R_{ext} = 0.1000\text{ m}^2\text{K/W}$
* **Total dome resistance:** $R_{total,dome} = 1.4392 + 0.1000 = \mathbf{1.5392\text{ m}^2\text{K/W}}$
* **Steady heat flux:** $q_{dome} = 480 / 1.5392 = \mathbf{311.9\text{ W/m}^2}$
* **Interface temperatures:**
  * Inner stainless liner: $T_{liner} = 500 - 311.9(0.0400) = \mathbf{487.5^\circ\text{C}}$
  * AES / CalSil interface: $T_{AES/CS} = 487.5 - 311.9(0.9375) = \mathbf{195.1^\circ\text{C}}$ (well below CalSil continuous limit of $650–1000^\circ\text{C}$)
  * **Outer stainless dome skin:** $T_{skin} = 20 + 311.9(0.1000) = \mathbf{51.2^\circ\text{C}}$ (**PASS**: $< 60^\circ\text{C}$ bare-hand touch limit).

#### B. Lower Waist with 15.3 mm Annular Air Gap & 18 mm Blackwood Binnacle — Case 1: Ventilated (Normal Operation)
The $15.3\text{ mm}$ annular gap is completely open around its top perimeter ($z = 215\text{ mm}$) and fed by eight $80 \times 25\text{ mm}$ arch scallops at the base ($z = 0$ to $25\text{ mm}$), plus the $20\text{ mm}$ open under-pan plenum.
* With buoyancy-driven air entering at $20^\circ\text{C}$ and mean cavity air at $T_{cav} = 30^\circ\text{C}$ ($h_{cav} = 10\text{ W/m}^2\text{K}$), the vessel skin sits at $T_{skin} \approx 30 + \frac{500-30}{1.4392 + 0.100} \times 0.100 = \mathbf{60.5^\circ\text{C}}$ ($333.65\text{ K}$).
* **Radiation across the 15.3 mm gap** (conservatively taking oxidised/sooty stainless $\varepsilon_1 = 0.90$ and Blackwood $\varepsilon_2 = 0.90$, so $\varepsilon_{eff} = \frac{1}{1/0.9 + 1/0.9 - 1} = 0.818$):
  * With wood inner face at $T_{w,in} \approx 34.5^\circ\text{C}$ ($307.65\text{ K}$):
    $$q_{rad,vent} = \varepsilon_{eff} \sigma (T_{skin}^4 - T_{w,in}^4) = 0.818 \times 5.67 \times 10^{-8} \times (333.65^4 - 307.65^4) = 4.638 \times 10^{-8} \times (1.239 \times 10^{10} - 8.958 \times 10^9) = \mathbf{159.2\text{ W/m}^2}$$
  * Convective cooling of the wood inner face by the $30^\circ\text{C}$ updraft ($h_{cav} = 10\text{ W/m}^2\text{K}$) removes $q_{conv} = 10(34.5 - 30.0) = 45.0\text{ W/m}^2$, leaving net flux into the $18\text{ mm}$ Blackwood stave ($R_{wood} = 0.018 / 0.16 = 0.1125\text{ m}^2\text{K/W}$, $R_{ext} = 0.1000\text{ m}^2\text{K/W}$) of:
    $$q_{wood} = \frac{34.5 - 20}{0.1125 + 0.1000} = \frac{14.5}{0.2125} = \mathbf{68.2\text{ W/m}^2}$$
  * **Wood inner face (ventilated):** $\mathbf{34.5^\circ\text{C}}$ (**PASS**: $< 80^\circ\text{C}$).
  * **Wood outer face (ventilated):** $T_{w,out} = 20 + 68.2(0.1000) = \mathbf{26.8^\circ\text{C}}$.

#### C. Lower Waist with 15.3 mm Annular Gap — Case 2: All Vents 100% Blocked/Choked (Fault State)
Assume all bottom and top vents are completely plugged with mud, ash, or leaves, turning the $15.3\text{ mm}$ gap into a sealed stagnant air and radiation cavity in direct series with the $500^\circ\text{C}$ gas boundary.
* Across the sealed $15.3\text{ mm}$ gap at $T_{skin} \approx 103.4^\circ\text{C}$ ($376.55\text{ K}$) and $T_{w,in} \approx 78.6^\circ\text{C}$ ($351.75\text{ K}$), with conservative $\varepsilon_1 = \varepsilon_2 = 0.90$ ($\varepsilon_{eff} = 0.818$) and $k_{air} = 0.030\text{ W/mK}$:
  * Linearised radiative conductance:
    $$h_{rad} = \varepsilon_{eff} \cdot 4 \sigma T_{avg}^3 = 0.818 \times 4 \times 5.67 \times 10^{-8} \times (364.15)^3 = \mathbf{8.96\text{ W/m}^2\text{K}}$$
  * Stagnant air conductive conductance:
    $$h_{cond} = \frac{k_{air}}{L_{gap}} = \frac{0.030}{0.0153} = \mathbf{1.96\text{ W/m}^2\text{K}}$$
  * Combined sealed-gap conductance: $h_{gap} = 8.96 + 1.96 = 10.92\text{ W/m}^2\text{K} \implies R_{gap} = 1 / 10.92 = \mathbf{0.0916\text{ m}^2\text{K/W}}$.
* **Total Choked-Wall Resistance Sum:**
  * $R_{vessel} = 1.4392\text{ m}^2\text{K/W}$
  * $R_{gap,choked} = 0.0916\text{ m}^2\text{K/W}$
  * $R_{wood} = 0.018 / 0.16 = 0.1125\text{ m}^2\text{K/W}$
  * $R_{ext} = 0.1000\text{ m}^2\text{K/W}$
  * **$R_{total,choked} = 1.4392 + 0.0916 + 0.1125 + 0.1000 = \mathbf{1.7433\text{ m}^2\text{K/W}}$**
* **Choked heat flux:** $q_{choked} = 480 / 1.7433 = \mathbf{275.3\text{ W/m}^2}$
  *(Breakdown across choked gap: $q_{rad} = 226.1\text{ W/m}^2$ + $q_{cond} = 49.2\text{ W/m}^2 = 275.3\text{ W/m}^2$)*
* **Choked interface temperatures:**
  * Vessel stainless skin inside blocked gap: $T_{skin,choked} = 500 - 275.3(1.4392) = \mathbf{103.8^\circ\text{C}}$
  * **Blackwood inner face (100% blocked vents):** $T_{w,in,choked} = 20 + 275.3(0.1125 + 0.1000) = \mathbf{78.5^\circ\text{C}}$ (**PASS**: $< 80.0^\circ\text{C}$ wood inner-face limit even in a total vent-blockage fault!).
  * **Blackwood outer face (100% blocked vents):** $T_{w,out,choked} = 20 + 275.3(0.1000) = \mathbf{47.5^\circ\text{C}}$.

#### D. Under-Hearth Bottom Pan ($z = 20\text{ mm}$)
Stack: $20\text{ mm}$ Cordierite ($k=1.5$) + $1.5\text{ mm}$ SS + $30\text{ mm}$ CalSil ($k=0.065$) + $50\text{ mm}$ AES ($k=0.08$) + $1.5\text{ mm}$ SS bottom pan:
* $R_{total,base} = 0.0400 + (0.020/1.5) + (0.030/0.065) + (0.050/0.08) + 0.1000 = 0.0400 + 0.0133 + 0.4615 + 0.6250 + 0.1000 = \mathbf{1.2398\text{ m}^2\text{K/W}}$
* With stone top face at $430^\circ\text{C}$ during steady cooking ($\Delta T = 410\text{ K}$ across conductive stack + $R_{ext}$):
  $q_{base} = 410 / 1.1998 = 341.7\text{ W/m}^2 \implies T_{pan,bottom} = 20 + 341.7(0.1000) = \mathbf{54.2^\circ\text{C}}$ (elevated $20\text{ mm}$ above table/tub floor).

---

### 6. Build Path and the Three Expensive-Looking Details

#### Workshop Build Path (Makerspace Adelaide + University Engineering Workshop)
1. **Coopered Blackwood Binnacle (Makerspace Adelaide Woodshop + WorkBee CNC):**
   * Rip 16 staves from $25\text{ mm}$ rough-sawn Tasmanian Blackwood on the **Makerspace table saw** with the blade tilted to **$11.25^\circ$** ($360^\circ / 32$), thicknessed to $20\text{ mm}$ on the **Makerspace thicknesser**.
   * Cut spline slots along stave edges on the table saw; glue up the 16-sided drum around two temporary MDF internal formers cut on the **WorkBee CNC router**.
   * Mount the glued drum flat on the **WorkBee CNC router** bed (since $215\text{ mm}$ height fits under the gantry; if Z-travel requires, rout in two $108\text{ mm}$ high rings joined by a stepped rabbet hidden directly behind the middle stainless hoop) and profile-mill the outer and inner surfaces into a true $\varnothing 762\text{ mm}$ OD / $\varnothing 726\text{ mm}$ ID cylinder, plus the 8 lower vent scallops and $70^\circ$ front landing notch. Hand-plane and sand to 320 grit; finish with 4 coats of pure tung oil cut with citrus solvent (penetrating oil finish—never cracks or peels under thermal cycling).
2. **Turned Hardware, Handles & Badge (Makerspace Metal Lathe, Mill & Trotec Laser):**
   * Turn the 8 waisted 304 stainless standoff spools ($\varnothing 24\text{ mm} \times 15.3\text{ mm}$ long, M8 through-bore) and the 4 Blackwood handle ferrules on the **Makerspace metal lathe**.
   * Mill and turn the 4 C65500 silicon-bronze hoop trunnions ($28 \times 28 \times 42\text{ mm}$) on the **Makerspace mill and metal lathe**.
   * Turn a $\varnothing 55\text{ mm} \times 3\text{ mm}$ C26000 brass builder's plate on the metal lathe; laser-mark the resist mask on the **Trotec Q500 CO2 laser** and salt-water electro-etch deep lettering before recessing it into the front-right Blackwood stave.
3. **Stainless Cooking Vessel (University Engineering Workshop):**
   * *University workshop, process: CNC sheet development, slip-rolling, and DC TIG welding.* Develop the $1.5\text{ mm}$ inner liner and $1.2\text{ mm}$ outer cupola as a cylindrical skirt plus 8-gore orange-peel spherical cap segments. Roll the cones/cylinders, form the gore curvature, and purge-TIG weld all seams in 304 stainless steel. Planish and orbital-grain the outer cupola to a uniform 180-grit satin finish so no raw tab edges or weld tint remain on the show face.

#### The Three Expensive-Looking Details (What a Grandchild Notices)
1. **The Silicon-Bronze Hoop Trunnions (`trunnion_bronze_x4`):** Where the two $35 \times 3\text{ mm}$ 304 stainless cooperage hoops tighten around the Blackwood staves, there are no bent sheet-metal tabs. Each hoop wraps $180^\circ$ around a solid $\varnothing 22\text{ mm}$ CNC-milled/lathe-turned C65500 silicon-bronze trunnion barrel, drawn together by an M10 304 stainless socket head cap screw riding on a spherical bronze washer.
2. **The Visible 15.3 mm Annular Shadow Gap & Capstan Spools (`spool_standoff_304_x8`):** Looking down at the waist of the oven, you see the $18\text{ mm}$ end-grain of the 16 splined Blackwood staves separated from the satin 304 stainless cupola by a continuous $15.3\text{ mm}$ open gap bridged by 8 lathe-turned waisted stainless capstan spools. The thermal architecture is visually self-explanatory.
3. **The Solid-Riveted Brass Flue Eyebrow & Etched Medallion (`eyebrow_brass_c260`):** Framing the top of the $410 \times 98\text{ mm}$ stainless mouth is a hand-rolled $2.0\text{ mm}$ C26000 cartridge-brass flame eyebrow secured with seven $\varnothing 5\text{ mm}$ solid copper round-head rivets peened with a rivet set—echoed by the deep-etched $\varnothing 55\text{ mm}$ brass builder's plate inset flush into the Blackwood binnacle stave.

---

### 7. Gas Power, Certified Burner Package, and Wood-Fire Verdict

* **Target Gas Input:** **6.5 kW (23.4 MJ/h)** (~475 g/h LPG at full rate).
  * *Why 6.5 kW:* Scaling from Gozney's 3.4 kW on a $0.115\text{ m}^2$ hearth ($29.5\text{ kW/m}^2$) to our $\varnothing 450\text{ mm}$ stone ($0.159\text{ m}^2$) requires at least $4.7\text{ kW}$ for equal hearth intensity; adding margin for the $410 \times 98\text{ mm}$ mouth radiation/convection loss puts **6.0–7.0 kW** in the sweet spot to soak the $6.68\text{ kg}$ stone to $430^\circ\text{C}$ in **22 minutes** and recover in **90 seconds** between pizzas.
* **Bought-In Certified Gas Train (Zero DIY Jets):**
  * Bought complete as a **certified commercial LPG oven replacement burner assembly** (e.g., Bromic / Gameco or AGA-certified commercial catering curved/tubular stainless ribbon burner bar rated $22–25\text{ MJ/h}$ at $2.75\text{ kPa}$ LPG, supplied with factory-fitted brass injector, primary air shutter, sit/copreci-type manual gas control valve with integrated **Flame-Failure Device [FFD]**, M8 thermocouple, and piezo igniter).
  * **Regulator & Hose:** Bought-in AGA-certified **LCC27 $2.75\text{ kPa}$ regulator** and $1.2\text{ m}$ braided LPG hose to **AS/NZS 1869 Class B**.
  * Mounted in the left-hand crescent slot of the stainless hearth pan via a bolted 304 stainless burner box; the valve stem and FFD button exit radially through a slotted stainless shield between the two cooperage hoops.
* **Wood Fire Verdict — NO (Gas Only):**
  * **Explicitly rejected.** Burning wood in a $480\text{ mm}$ chamber with a $175\text{ mm}$ low-dome gas ceiling deposits fly ash into the certified burner ports and FFD thermocouple, steals $120\text{ mm}$ of stone width for an ember grate (shrinking the usable deck below the $381\text{ mm}$ pizza requirement), and blows soot onto the Blackwood binnacle. Pure LPG keeps the $450\text{ mm}$ floor 100% clear and site cleanup under 2 minutes.

---

### 8. AUD Cost Band (Certified Parts Separate)

All figures are **ESTIMATE, AUD, Adelaide, October 2026**.

#### A. Certified Gas Components (Bought New / Certified)
* AGA-certified commercial LPG oven burner bar assembly ($22–25\text{ MJ/h}$) with factory orifice, FFD safety valve, thermocouple & piezo igniter (Adelaide commercial catering spares / Gameco): **$185 ESTIMATE, AUD, Adelaide, October 2026**
* LCC27 $2.75\text{ kPa}$ regulator + $1.2\text{ m}$ AS/NZS 1869 braided hose (Bunnings / Barbeques Galore Mile End): **$55 ESTIMATE, AUD, Adelaide, October 2026**
* **Subtotal Certified Gas Package:** **$240 ESTIMATE, AUD, Adelaide, October 2026**

#### B. Materials, Refractories, Timber & Hardware (Gumtree / Marketplace + Trade)
* 304 Stainless Steel sheet ($1.5\text{ mm}$ and $1.2\text{ mm}$ offcuts from Gumtree / Wingfield scrap & sheet-metal fabricators) + $\varnothing 25.4\text{ mm}$ tube & $35 \times 3\text{ mm}$ flat bar: **$165 ESTIMATE, AUD, Adelaide, October 2026**
* AES Superwool blanket ($75\text{ mm}$ / $25\text{ mm}$ layers, $128\text{ kg/m}^3$, refractory supplier Lonsdale/Wingfield, half-roll share or offcuts): **$110 ESTIMATE, AUD, Adelaide, October 2026**
* Calcium Silicate insulating board ($30\text{ mm}$ thick, $250\text{ kg/m}^3$, 1 sheet $1000 \times 600\text{ mm}$): **$85 ESTIMATE, AUD, Adelaide, October 2026**
* Cordierite pizza stone ($\varnothing 450 \times 20\text{ mm}$ commercial kiln shelf / catering deck, pottery supply Adelaide): **$75 ESTIMATE, AUD, Adelaide, October 2026**
* Kiln-dried Tasmanian Blackwood boards ($25\text{ mm}$ salvage/furniture pack off Facebook Marketplace Adelaide): **$65 ESTIMATE, AUD, Adelaide, October 2026**
* Silicon bronze bar stock, C26000 brass sheet offcut, copper rivets, 304 SS fasteners, tung oil, TIG filler & consumables: **$70 ESTIMATE, AUD, Adelaide, October 2026**
* **Subtotal Fabrication & Refractory Materials:** **$570 ESTIMATE, AUD, Adelaide, October 2026**

* **TOTAL PROJECT CASH COST:** **$810 ESTIMATE, AUD, Adelaide, October 2026**

---

### 9. The Three Worst Things (Honest Engineering Flaws)

1. **54.1 kg Ready-to-Cook Mass (45.1 kg with Stone & Legs Removed):**
   Because a cool-touch stainless cupola ($51.2^\circ\text{C}$ skin) plus a real structural $18\text{ mm}$ Blackwood coopered binnacle and $3\text{ mm}$ stainless hoops uses real gauge metal and $105\text{ mm}$ of insulation, this is a **two-person lift** out of the Shark 6 tub ($22.5\text{ kg}$ per person with the stone and leg tubes pulled out first). One person can slide it to the tailgate, but two people should lift it onto the ground or camp table.
2. **8-Gore TIG Dome Welding & Planishing Time:**
   Without a heavy industrial metal-spinning lathe capable of spinning a $\varnothing 695\text{ mm}$ 304 stainless hemisphere, forming and TIG-welding the 8-gore outer cupola segments at the university workshop—and then planishing and blending the welds so the exterior reads as a seamless satin vessel—will take Adib roughly **14–18 hours of skilled metalworking**.
3. **Cannot Cook Directly on the Shark 6 Lowered Tailgate:**
   At $\varnothing 768\text{ mm}$ across the hoops, the oven overhangs the Shark 6's $517\text{ mm}$ lowered tailgate by $251\text{ mm}$ and cannot stand on the tailgate unsupported. You must either pop the three $680\text{ mm}$ stainless legs into their clevises on the ground beside the ute (takes 30 seconds) or set it on a camp table.

---

### 10. Named Solids in Millimetres (CAD Tree Specification)

Origin $(0,0,0)$ is at the centre of the stowed base plane ($z = 0$ on the tub floor/table); $+Y$ is front (mouth), $+Z$ is vertical up.

1. `deck_cordierite`: Cylinder, $\varnothing 450\text{ mm} \times 20\text{ mm}$ thick, $z = 103.0$ to $123.0\text{ mm}$, offset $(0, +10\text{ mm})$ toward front.
2. `liner_inner_304`: Shell, $1.5\text{ mm}$ wall, ID $\varnothing 480\text{ mm}$, hearth floor at $z = 101.5$ to $103.0\text{ mm}$, cylindrical skirt $z = 103.0$ to $158.0\text{ mm}$, spherical cap $z = 158.0$ to $299.5\text{ mm}$ (inner apex $z = 298.0\text{ mm}$), $410 \times 98\text{ mm}$ front mouth cutout.
3. `insul_aes_crown`: Shell, $75.0\text{ mm}$ wall, ID $\varnothing 483\text{ mm}$, OD $\varnothing 633\text{ mm}$, $z = 103.0$ to $374.5\text{ mm}$.
4. `insul_aes_base`: Cylinder, $\varnothing 630\text{ mm} \times 50.0\text{ mm}$ thick, $z = 21.5$ to $71.5\text{ mm}$.
5. `insul_calsil_crown`: Shell (faceted segments), $30.0\text{ mm}$ wall, ID $\varnothing 633\text{ mm}$, OD $\varnothing 693\text{ mm}$, $z = 103.0$ to $404.5\text{ mm}$.
6. `insul_calsil_base`: Cylinder, $\varnothing 630\text{ mm} \times 30.0\text{ mm}$ thick, $z = 71.5$ to $101.5\text{ mm}$.
7. `vessel_outer_304`: Shell, $1.2\text{ mm}$ wall, ID $\varnothing 693\text{ mm}$, OD $\varnothing 695.4\text{ mm}$, cylindrical waist $z = 20.0$ to $180.0\text{ mm}$, oblate dome cap $z = 180.0$ to $405.7\text{ mm}$, plus $\varnothing 90 \times 4.3\text{ mm}$ top crown boss to $z = 410.0\text{ mm}$.
8. `pan_bottom_304`: Disc with $15\text{ mm}$ upturned flange, $\varnothing 695.4\text{ mm} \times 1.5\text{ mm}$ thick, bottom face at $z = 20.0\text{ mm}$.
9. `mouth_arch_landing_304`: $1.5\text{ mm}$ 304 SS tunnel ($410\text{ mm}$ wide $\times 98\text{ mm}$ high $\times 115\text{ mm}$ deep, $z = 123.0$ to $221.0\text{ mm}$) + front landing plate ($430\text{ mm}$ wide $\times 90\text{ mm}$ radial projection at $z = 121.5$ to $123.0\text{ mm}$).
10. `eyebrow_brass_c260`: Curved strip, $2.0\text{ mm}$ thick $\times 45\text{ mm}$ wide $\times 440\text{ mm}$ arc length, riveted above mouth at $z = 205.0$ to $240.0\text{ mm}$.
11. `binnacle_blackwood_staves`: 16-stave coopered cylinder, ID $\varnothing 726.0\text{ mm}$, OD $\varnothing 762.0\text{ mm}$ ($18.0\text{ mm}$ wall), $z = 0.0$ to $215.0\text{ mm}$, with eight $80 \times 25\text{ mm}$ bottom vent scallops and $70^\circ$ front landing cutout ($z = 105.0$ to $215.0\text{ mm}$).
12. `spool_standoff_304_x8`: 8 turned waisted spools, $\varnothing 24.0\text{ mm}$ ends ($\varnothing 14.0\text{ mm}$ waist) $\times 15.3\text{ mm}$ length, spanning $r = 347.7$ to $363.0\text{ mm}$ at $z = 55.0\text{ mm}$ and $z = 175.0\text{ mm}$.
13. `hoops_cooperage_304_x2`: Two bands, $35.0\text{ mm}$ high $\times 3.0\text{ mm}$ thick, ID $\varnothing 762.0\text{ mm}$, OD $\varnothing 768.0\text{ mm}$, centred at $z = 45.0\text{ mm}$ (full circle) and $z = 180.0\text{ mm}$ ($290^\circ$ arc terminating at mouth landing).
14. `trunnion_bronze_x4`: 4 machined blocks, $28.0 \times 28.0 \times 42.0\text{ mm}$ with $\varnothing 22.0\text{ mm}$ barrel and M10 draw-bolt bore.
15. `handles_blackwood_x4`: 4 turned grips, $\varnothing 36.0\text{ mm} \times 130.0\text{ mm}$ long on $\varnothing 12.0\text{ mm}$ 304 SS tangs at $z = 180.0\text{ mm}$ ($\pm 45^\circ, \pm 135^\circ$).
16. `legs_tubular_304_x3`: 3 tubes, $\varnothing 25.4\text{ mm}$ OD $\times 2.0\text{ mm}$ wall $\times 680.0\text{ mm}$ long, pinned to $4.0\text{ mm}$ 304 SS clevises at $z = 35.0\text{ mm}$ ($0^\circ, 120^\circ, 240^\circ$).
17. `burner_arc_certified`: Curved stainless burner bar, $320\text{ mm}$ arc length $\times 42\text{ mm}$ width $\times 55\text{ mm}$ height, seated in left-hand hearth slot ($x = -215\text{ mm}, z = 95.0$ to $150.0\text{ mm}$).
