adxb-pxthxn/pizza-oven/design/tailgate/argon/01-wood.md

### 1. Name and Concept

**THE COOPER’S DOME (Project *Cask-430*)**

*Cask-430* is a circular, gas-fired portable Neapolitan pizza oven whose outer body is a 24-stave dry-coopered barrel frustum of 16 mm quarter-sawn Tasmanian Blackwood (*Acacia melanoxylon*), bound by two Belleville-sprung 304 stainless steel tension hoops with machined C36000 brass trunnions, and capped by a satin-brushed 1.2 mm 304 stainless steel dome crown that sheds rain and mouth spill heat over the top of the staves. Inside that timber-and-brass furniture shell sits an industrial furnace core: a TIG-welded 1.5 mm 304 stainless steel inner dome liner, a 430 mm × 20 mm cordierite deck, 75 mm of Morgan Superwool Plus AES blanket, and 50 mm of kerf-slotted calcium silicate board that holds the wood inner face at 69.3°C during a 500°C soak. Too wide at 765 mm to balance on the BYD Shark 6’s 517 mm tailgate, it stands beside the ute on three quick-release bayonet tripod legs that place the hearth at 860 mm off the ground—freeing the lowered tailgate to act as the pizza prep bench—and packs down to a 420 mm stowed height that slides under the Shark 6 tonneau cover with 97 mm to spare.

---

### 2. Dimensioned Description

#### Plan & Elevation Envelope
*   **Outer body plan diameter:** **765 mm** at the lower belly ($R_{out} = 382.5\text{ mm}$), tapering along a barrel curve to **560 mm** diameter where the wood staves tuck beneath the stainless dome crown drip skirt.
*   **Plan width across side handles:** **855 mm** (two pairs of 45 mm stand-off handles; clears the 1224 mm width between the BYD Shark 6 wheel arches with 369 mm of margin).
*   **Body height (stowed, legs detached):** **420 mm** from the bottom rubber-isolated skid ring to the top of the machined brass crown boss (clears the 460 mm target by 40 mm and the 517 mm Shark 6 tub depth by 97 mm).
*   **Cooking floor:** **430 mm diameter × 20 mm thick** cordierite circular stone. Accommodates a 15-inch (381 mm) pizza with 49 mm of diametral clearance for peel rotation.
*   **Chamber inside diameter:** **480 mm** circular plan ($R_{in} = 240\text{ mm}$). The 430 mm stone is offset 20 mm forward toward the mouth so its front edge meets the stainless landing lip, leaving a 70 mm crescent slot along the rear-left arc for the gas burner port and flame roll baffle.
*   **Chamber apex height above floor:** **165 mm** (55 mm vertical cylindrical wall transitioning into a 110 mm rise oblate dome).
*   **Mouth width and height:** **400 mm wide × 95 mm high** (stadium arch with 65 mm vertical jambs curving into a 95 mm crown, framed by a 145 mm deep TIG-welded 2.0 mm 304 stainless tunnel and upper flame-spill eyebrow).
*   **Mouth-to-apex ratio:** $95\text{ mm} / 165\text{ mm} = \mathbf{0.576}$ (matches the 0.57 ratio of the Gozney Arc Lite to trap radiant dome heat while clearing a 381 mm peel).

#### Wall Stack (Gas Outward at Equator, $R = 240.0\text{ mm}$ to $382.5\text{ mm}$)
1.  **Inner liner:** $1.5\text{ mm}$ 304 stainless steel ($R = 240.0 \rightarrow 241.5\text{ mm}$).
2.  **Primary insulation:** $75.0\text{ mm}$ AES refractory blanket ($\rho = 128\text{ kg/m}^3$, $k = 0.08\text{ W/mK}$), installed as two lapped $38\text{ mm}$ layers compressed to $75\text{ mm}$ ($R = 241.5 \rightarrow 316.5\text{ mm}$).
3.  **Secondary rigid insulation:** $50.0\text{ mm}$ calcium silicate insulating board ($\rho = 250\text{ kg/m}^3$, $k = 0.065\text{ W/mK}$), CNC-kerfed polygon staves bonded with refractory mortar and wrapped externally in $0.08\text{ mm}$ aluminium foil vapour barrier tape ($R = 316.5 \rightarrow 366.5\text{ mm}$).
4.  **Outer timber shell:** $16.0\text{ mm}$ quarter-sawn Tasmanian Blackwood coopered staves ($\rho = 640\text{ kg/m}^3$, $k = 0.16\text{ W/mK}$) bound by two $30\text{ mm} \times 2.0\text{ mm}$ 304 stainless tension hoops ($R = 366.5 \rightarrow 382.5\text{ mm}$).

#### Vertical Stack (Ground Upward, Stowed Attitude, $Z = 0$ to $420\text{ mm}$)
1.  **Base skid ring & bayonet sockets:** $15.0\text{ mm}$ ($Z = 0 \rightarrow 15.0\text{ mm}$).
2.  **Base structural pan:** $1.5\text{ mm}$ 304 stainless steel with $25\text{ mm}$ upturned chime rim ($Z = 15.0 \rightarrow 16.5\text{ mm}$).
3.  **Under-hearth insulation:** $25.0\text{ mm}$ AES blanket + $50.0\text{ mm}$ load-bearing calcium silicate disc ($Z = 16.5 \rightarrow 91.5\text{ mm}$).
4.  **Cordierite cooking stone:** $20.0\text{ mm}$ ($Z = 91.5 \rightarrow 111.5\text{ mm}$; hearth top at $Z = 111.5\text{ mm}$).
5.  **Internal oven cavity:** $165.0\text{ mm}$ ($Z = 111.5 \rightarrow 276.5\text{ mm}$).
6.  **Inner dome crown liner:** $1.5\text{ mm}$ 304 stainless steel ($Z = 276.5 \rightarrow 278.0\text{ mm}$).
7.  **Top dome insulation:** $75.0\text{ mm}$ AES blanket + $50.0\text{ mm}$ segmented calcium silicate cap ($Z = 278.0 \rightarrow 403.0\text{ mm}$).
8.  **Outer dome crown & brass boss:** $1.2\text{ mm}$ 304 stainless steel dome cap ($560\text{ mm}$ chord diameter, $115\text{ mm}$ rise from the upper stave chime at $Z = 305\text{ mm}$) plus a $15.8\text{ mm}$ machined brass top trim boss ($Z = 403.0 \rightarrow 420.0\text{ mm}$).

#### Leg, Handle & Tailgate Geometry
*   **Why it does not sit on the tailgate:** The BYD Shark 6 lowered tailgate provides a $517\text{ mm}$ deep horizontal deck. The oven’s $680\text{ mm}$ base pan and $765\text{ mm}$ belly would overhang the tailgate edge by $163\text{–}248\text{ mm}$.
*   **Tripod Stand:** Three removable legs of $32\text{ mm} \times 2.0\text{ mm}$ 304 stainless tube ($780\text{ mm}$ long, splayed outward at $12^\circ$ into a $920\text{ mm}$ ground circle) lock into welded stainless bayonet sockets underneath the base pan with spring-ball hitch pins. Each leg carries a turned Tasmanian Blackwood grip sleeve and an M12 threaded rubber levelling foot.
*   **Operating height & workflow:** On its tripod, the stone floor sits at **860 mm** above ground. The oven stands on the ground $1.2\text{ m}$ behind or beside the open ute; the Shark 6’s $1370\text{ mm} \times 517\text{ mm}$ lowered tailgate becomes a waist-high dough-stretching and topping bench illuminated by the tub light and served by the 230 V tub outlet.
*   **Handles:** Four $4.0\text{ mm}$ 304 stainless brackets bolted to the upper and lower tension hoops at $45^\circ / 135^\circ / 225^\circ / 315^\circ$, carrying two $32\text{ mm}$ diameter $\times 180\text{ mm}$ long turned Tasmanian Blackwood bar handles on the left and right flanks ($45\text{ mm}$ radial stand-off from the staves).
*   **Stowed Envelope in Tub:** **855 mm wide × 785 mm front-to-back (including rear burner guard) × 420 mm tall**. Straps down flat on the rubber tub mat against the front bulkhead using four of the Shark 6’s six tie-down points; the three $780\text{ mm}$ legs stow in a canvas roll alongside one wheel arch.

---

### 3. Mass Table and Rejected Alternative

#### Rejected Alternative & The Kilograms It Cost
Before arriving at the hybrid 16 mm Tasmanian Blackwood coopered drum + 1.2 mm 304 stainless crown, we evaluated the naive "all-wood dome" version: a full hemisphere-over-cylinder outer shell of **20 mm Jarrah** ($\rho = 840\text{ kg/m}^3$, $A_{net} = 0.964\text{ m}^2$, $V = 19.28\text{ L}$), backed by the original Case C **20 mm dense castable refractory dome** ($\rho = 2200\text{ kg/m}^3$, $A = 0.564\text{ m}^2$, $V = 11.28\text{ L}$) and a **30 mm cordierite floor** ($V = 4.36\text{ L}$).
*   20 mm Full Jarrah Outer Shell: $19.28\text{ L} \times 0.840\text{ kg/L} = \mathbf{16.20\text{ kg}}$ (vs. $6.18\text{ kg}$ Blackwood staves + $2.73\text{ kg}$ 1.2 mm SS crown = $8.91\text{ kg}$ $\rightarrow$ **saves 7.29 kg**, eliminates compound-curved stave waste, and removes flat upper wood grain from rain and rising $180^\circ\text{C}$ mouth spill gas).
*   20 mm Castable Refractory Inner Dome: $11.28\text{ L} \times 2.20\text{ kg/L} = \mathbf{24.82\text{ kg}}$ (replaced by the $1.5\text{ mm}$ 304 SS inner dome liner at $3.35\text{ kg}$ $\rightarrow$ **saves 21.47 kg** and cuts preheat time in half while changing wood inner-face temperature by less than $1^\circ\text{C}$).
*   30 mm vs. 20 mm Cordierite Stone: $9.15\text{ kg}$ vs. $6.10\text{ kg}$ $\rightarrow$ **saves 3.05 kg**.
*   **Total rejected mass penalty:** **31.81 kg saved** by rejecting the 20 mm Jarrah full dome, castable liner, and 30 mm stone.

#### Final Mass Table

| Part | Material | Volume Formula & Value (Litres) | Density ($\text{kg/m}^3$) | Mass (kg) |
| :--- | :--- | :--- | :--- | :--- |
| **1. Cooking Floor** | Cordierite stone ($D=430\text{ mm}, t=20\text{ mm}$) | $V = \pi \times 0.215^2 \times 0.020 = 0.002904\text{ m}^3 = \mathbf{2.904\text{ L}}$ | 2100 | **6.10** |
| **2. Inner Chamber Liner, Mouth Tunnel & Hearth Pan** | 304 Stainless Steel ($t=1.5\text{ mm}$) | Wall ($0.0829\text{ m}^2$) + Dome ($0.2190\text{ m}^2$) $-$ Mouth ($0.0350\text{ m}^2$) + Tunnel ($0.0950\text{ m}^2$) + Pan ($0.1810\text{ m}^2$) = $0.5429\text{ m}^2 \times 1.5\text{ mm} = \mathbf{0.814\text{ L}}$ | 7900 | **6.43** |
| **3. Primary Insulation (75 mm Wall/Dome + 25 mm Base)** | Morgan Superwool Plus AES Blanket | Shell ($0.4086\text{ m}^2 \times 75\text{ mm} = 30.65\text{ L}$) + Base disk ($\pi \times 0.260^2 \times 25\text{ mm} = 5.31\text{ L}$) = **35.96 L** | 128 | **4.60** |
| **4. Secondary Insulation (50 mm Wall/Dome + 50 mm Base)** | Calcium Silicate Board | Shell ($0.6257\text{ m}^2 \times 50\text{ mm} = 31.29\text{ L}$) + Base disk ($\pi \times 0.260^2 \times 50\text{ mm} = 10.62\text{ L}$) = **41.91 L** | 250 | **10.48** |
| **5. Coopered Timber Body (24 Staves)** | Tasmanian Blackwood ($t=16\text{ mm}$ dry) | $(\pi \times 0.680\text{ m} \times 0.310\text{ m} - 0.058\text{ m}^2\text{ mouth}) \times 0.016\text{ m} = 0.604\text{ m}^2 \times 16\text{ mm} = \mathbf{9.66\text{ L}}$ | 640 | **6.18** |
| **6. Upper Dome Crown (1.2 mm) & Base Chime Pan (1.5 mm)** | 304 Stainless Steel | Crown ($\pi(0.280^2+0.115^2)\times 1.2\text{ mm} = 0.345\text{ L}$) + Base ($0.4166\text{ m}^2 \times 1.5\text{ mm} = 0.625\text{ L}$) = **0.970 L** | 7900 | **7.66** |
| **7. Tension Hoops, Mouth Bezel, Brass Trunnions & Handles** | 304 SS ($0.468\text{ L}$), C36000 Brass ($0.110\text{ L}$), Blackwood grips ($0.320\text{ L}$) | Hoops ($0.238\text{ L SS}$) + Mouth bezel ($0.170\text{ L SS}$) + Handle brackets ($0.060\text{ L SS}$) + Brass hardware ($0.110\text{ L}$) + Wood grips ($0.320\text{ L}$) = **0.898 L** | 7900 / 8500 / 640 | **4.84** |
| **8. Certified Gas Burner, FFD, Valve & Burner Box** | 304 SS / Brass commercial assembly | Equivalent displaced metal volume = **0.310 L** (weighed assembly) | 7900 (equiv) | **2.45** |
| **9. Removable Tripod Legs (×3, Stowed Separately)** | 304 SS Tube ($32\times 2\text{ mm}, L=780\text{ mm}$) + Blackwood sleeves | Tube ($3 \times 0.780\text{ m} \times 188.5\text{ mm}^2 = 0.441\text{ L SS}$) + Sleeves/feet ($0.65\text{ L}$ wood/rubber) = **1.091 L** | 7900 / 640 | **3.90** |
| **TOTAL (Complete System on Legs)** | | | | **52.64 kg** |
| **LIFT MASS A (Body Only — Stone & Legs Removed)** | | $52.64 - 6.10\text{ (stone)} - 3.90\text{ (legs)}$ | | **42.64 kg** |
| **LIFT MASS B (Body with Stone Installed, Legs Off)** | | $52.64 - 3.90\text{ (legs)}$ | | **48.74 kg** |

#### One-Person Carry Verdict
**No—this is a two-person lift into and out of the ute tub, and pretending otherwise would injure someone’s back.** Even with the $6.10\text{ kg}$ stone and $3.90\text{ kg}$ leg bundle carried separately in canvas totes, the insulated drum weighs **42.64 kg** and is **765 mm** in diameter. A single strong person can slide it across the Shark 6 tub mat onto the tailgate and pivot it onto its tripod legs in an emergency, but lifting $42.6\text{ kg}$ across a $765\text{ mm}$ span exceeds safe solo ergonomic limits ($\sim 25\text{ kg}$). With two people holding the two $180\text{ mm}$ side bar handles, each person lifts **21.3 kg** with a straight back.

---

### 4. Heat-Up and Thermal Calculations

#### Burner Specification & Time to 400°C Floor
*   **Burner:** Bought certified commercial twin-tube curved LPG oven burner rated at **6.8 kW** ($24.5\text{ MJ/h}$, $\approx 490\text{ g/h}$ propane at $2.75\text{ kPa}$ via an LCC27 regulator and AS/NZS 1869 Class A hose).
*   **Why 6.8 kW:** Gozney’s Arc Lite uses $3.4\text{ kW}$ for a $0.115\text{ m}^2$ floor; our $430\text{ mm}$ circular floor ($0.145\text{ m}^2$) and $480\text{ mm}$ inner dome have $1.6\times$ the surface area and a $400 \times 95\text{ mm}$ mouth.
*   **Thermal mass to heat during preheat:**
    1.  **Cordierite floor ($6.10\text{ kg}$, $c_p = 1050\text{ J/kgK}$) from $20^\circ\text{C}$ to $400^\circ\text{C}$ ($\Delta T = 380\text{ K}$):**
        $$Q_{\text{stone}} = 6.10 \times 1050 \times 380 = 2.434\text{ MJ}$$
    2.  **Active 1.5 mm 304 SS inner dome & hearth liner ($4.80\text{ kg}$, $c_p = 500\text{ J/kgK}$) from $20^\circ\text{C}$ to $480^\circ\text{C}$ ($\Delta T = 460\text{ K}$):**
        $$Q_{\text{liner}} = 4.80 \times 500 \times 460 = 1.104\text{ MJ}$$
    3.  **Inner 25 mm hot-face layer of AES blanket ($1.30\text{ kg}$, $c_p = 1050\text{ J/kgK}$) to mean $\Delta T = 250\text{ K}$:**
        $$Q_{\text{AES}} = 1.30 \times 1050 \times 250 = 0.341\text{ MJ}$$
    *   **Total heat absorbed for a soaked 400°C floor:**
        $$Q_{\text{total}} = 2.434 + 1.104 + 0.341 = \mathbf{3.879\text{ MJ}}$$
*   **Heat-up time:** With an open $400 \times 95\text{ mm}$ mouth, flue spill and radiation losses consume $\sim 68\%$ of gross burner input, leaving a net heat transfer efficiency to the chamber of $\eta \approx 32\%$ ($P_{\text{net}} = 6.8\text{ kW} \times 0.32 = 2.18\text{ kW}$):
    $$t_{\text{open}} = \frac{3,879,000\text{ J}}{2180\text{ W}} = 1779\text{ s} \approx \mathbf{29.7\text{ minutes}}$$
    With the removable half-height stainless preheat baffle hooked across the lower mouth (blocking radiant floor loss while leaving the top $45\text{ mm}$ arch open for secondary air and exhaust, $\eta \approx 41\%$, $P_{\text{net}} = 2.79\text{ kW}$):
    $$t_{\text{baffle}} = \frac{3,879,000\text{ J}}{2790\text{ W}} = 1390\text{ s} \approx \mathbf{23.2\text{ minutes}}$$

#### 1D Steady-State Wall & Touch Temperatures
Using the benchmark boundary conditions ($T_{\text{gas}} = 500^\circ\text{C}$, $T_{\text{air}} = 20^\circ\text{C}$, $\Delta T = 480\text{ K}$, $h_{\text{in}} = 25\text{ W/m}^2\text{K}$, $h_{\text{ext}} = 10\text{ W/m}^2\text{K}$):
*   $R_{\text{in}} = 1 / 25 = 0.0400\text{ m}^2\text{K/W}$
*   $R_{\text{SS liner}} = 0.0015 / 16.0 = 0.0001\text{ m}^2\text{K/W}$
*   $R_{\text{AES (75 mm)}} = 0.075 / 0.080 = 0.9375\text{ m}^2\text{K/W}$
*   $R_{\text{CalSil (50 mm)}} = 0.050 / 0.065 = 0.7692\text{ m}^2\text{K/W}$
*   $R_{\text{Blackwood (16 mm)}} = 0.016 / 0.160 = 0.1000\text{ m}^2\text{K/W}$
*   $R_{\text{ext}} = 1 / 10 = 0.1000\text{ m}^2\text{K/W}$
*   **Total thermal resistance:**
    $$R_{\text{total}} = 0.0400 + 0.0001 + 0.9375 + 0.7692 + 0.1000 + 0.1000 = \mathbf{1.9468\text{ m}^2\text{K/W}}$$
*   **Steady wall heat flux:**
    $$q = \frac{480\text{ K}}{1.9468\text{ m}^2\text{K/W}} = \mathbf{246.56\text{ W/m}^2}$$
*   **Wood inner face temperature** (at the CalSil / Blackwood interface):
    $$T_{\text{wood,in}} = T_{\text{air}} + q \times (R_{\text{ext}} + R_{\text{Blackwood}}) = 20 + 246.56 \times (0.1000 + 0.1000) = \mathbf{69.3^\circ\text{C}}$$
    *(Note: Reducing the stave thickness from 20 mm to 16 mm lowers the wood inner face temperature from $74.8^\circ\text{C}$ to $69.3^\circ\text{C}$ because timber is a poorer insulator than AES/CalSil; thinner wood lets heat escape to ambient air faster rather than banking up at the wood inner boundary. This gives a $10.7^\circ\text{C}$ safety margin below the $80^\circ\text{C}$ limit.)*
*   **Wood outer face temperature:**
    $$T_{\text{wood,out}} = T_{\text{air}} + q \times R_{\text{ext}} = 20 + 246.56 \times 0.1000 = \mathbf{44.7^\circ\text{C}}$$
*   **Upper 304 SS dome crown temperature:** Away from the mouth plume ($R_{\text{tot,crown}} = 1.8468\text{ m}^2\text{K/W}$, $q = 259.9\text{ W/m}^2$), the crown sits at **$46.0^\circ\text{C}$**; directly above the mouth eyebrow where $450^\circ\text{C}$ exhaust spills out, the stainless lip reaches **$95\text{–}115^\circ\text{C}$**, which is why the entire mouth tunnel, eyebrow, and upper crown are 304 stainless steel with zero timber in the spill path.
*   **Handle temperature:** The turned Blackwood handles sit on $45\text{ mm}$ stainless stand-offs bolted to the $45^\circ\text{C}$ hoops; convective cooling along the brackets holds the wooden grips at **$26\text{–}30^\circ\text{C}$** (ambient-warm to a bare hand).

---

### 5. How It Is Made — Part by Part

| Component | Process & Operations | Facility & Named Machine |
| :--- | :--- | :--- |
| **1. Cooperage Jigs & Assembly Rings** | Cut two circular MDF assembly cradles ($D=765\text{ mm}$ and $D=560\text{ mm}$ in halves) with 24 indexing notches; laser-engrave stave numbering and angle gauges. | **Makerspace Adelaide:** Trotec Q500 CO2 Laser ($1300 \times 900\text{ mm}$ bed) & WorkBee CNC Router. |
| **2. 24 Tasmanian Blackwood Staves** | Dress rough-sawn $25\text{ mm}$ quarter-sawn Blackwood boards to $19\text{ mm}$; rip $7.5^\circ$ bevelled stave edges and cut $4\text{ mm} \times 8\text{ mm}$ stopped spline grooves on the table saw using a 3D-printed featherboard jig; machine the convex barrel outer curve and concave inner curve on each stave on the CNC router; hand-plane and sand to $16.0\text{ mm}$ finished thickness. | **Makerspace Adelaide:** Woodworking shop (Thicknesser, Table Saw, Drop Saw, Carbatec hand tools), Bambu Lab P1S (3D-printed saw jigs), WorkBee CNC Router. |
| **3. Calcium Silicate Core Segments** | Cut $50\text{ mm}$ calcium silicate slabs into a $520\text{ mm}$ base disk and 18 bevel-edged stave/crown segments with relief kerfs so they form a tight polygonal shell around the AES blanket. | **Makerspace Adelaide:** Woodworking shop bandsaw/table saw with dust extraction & WorkBee CNC Router. |
| **4. Cordierite Cooking Floor** | Purchase a standard $450 \times 450 \times 20\text{ mm}$ commercial cordierite kiln shelf; scribe a $430\text{ mm}$ circle, wet-score with a diamond blade, and dress the perimeter bevel smooth. | **Bought** blank + **Makerspace Adelaide** wet diamond hand tool / belt sander. |
| **5. Inner 1.5 mm 304 SS Liner & Mouth Tunnel** | Guillotine-shear, slip-roll the $480\text{ mm}$ cylinder and $400 \times 95\text{ mm}$ mouth tunnel, press-brake and wheel the 8-gore oblate dome cap, and purge-TIG weld all seams. | **University Workshop:** Process: Guillotine shearing, slip rolling, press braking, and TIG welding of $1.5\text{ mm}$ 304 stainless steel. |
| **6. Outer 1.2 mm 304 SS Dome Crown & 1.5 mm Base Chime Pan** | Cut and form the $560\text{ mm}$ shallow dome cap (6 TIG-welded gores dressed flush and orbital-sanded to a continuous #4 satin grain, with a $15\text{ mm}$ rolled drip skirt) and the $680\text{ mm}$ base pan with its $25\text{ mm}$ upturned chime rim and three welded leg bayonet sockets. | **University Workshop:** Process: Sheet rolling, gore forming, TIG welding, and weld planishing of $1.2\text{–}1.5\text{ mm}$ 304 stainless steel. |
| **7. Stainless Tension Hoops & Mouth Surround** | Roll two $30\text{ mm} \times 2.0\text{ mm}$ 304 stainless flat-bar hoops to match the $6.5^\circ$ stave cone angle; roll and TIG-weld the $2.0\text{ mm}$ 304 stainless flanged mouth bezel and upper flame-spill eyebrow that bridges the inner tunnel to the outer wood opening. | **University Workshop:** Process: Section rolling and TIG welding of $2.0\text{ mm}$ 304 stainless steel. |
| **8. Brass Trunnions, Crown Boss, Leg Spigots & Badge** | Turn four $\varnothing 28\text{ mm} \times 45\text{ mm}$ C36000 brass hoop tension trunnions, the $\varnothing 85\text{ mm}$ top crown trim boss, and three stainless leg bayonet spigots on the metal lathe; cross-drill and slot the trunnions on the vertical mill; laser-mask and acid-etch the brass maker's badge. | **Makerspace Adelaide:** Metalworking shop (Metal Lathe, Mill, Cold Cut Saw) + Thunder Nova35 CO2 Laser (resist mask engraving). |
| **9. Turned Handles & Leg Sleeves** | Turn two $\varnothing 32\text{ mm} \times 180\text{ mm}$ Blackwood bar handles and three $\varnothing 44\text{ mm} \times 220\text{ mm}$ bored Blackwood leg sleeves between centres. | **Makerspace Adelaide:** Metalworking/Woodworking small lathe & drill press. |
| **10. Certified Gas Burner Module** | Purchase a complete certified $6.8\text{ kW}$ LPG commercial oven burner with factory injector, venturi, thermocouple FFD, piezo igniter, LCC27 $2.75\text{ kPa}$ regulator, and AS/NZS 1869 hose. Bolt into the rear-left 304 SS burner bay—**zero modification to jet, injector, or valve**. | **Bought** (certified commercial catering assembly). |
| **11. Canvas Transport Cover & Stone Tote** | Sew a fitted ripstop canvas cover and a double-layered canvas stone carry sling with $50\text{ mm}$ webbing handles. | **Makerspace Adelaide:** Sewing machines and overlockers. |

---

### 6. Weather, Vibration, Pack-Down, and Cleaning

*   **Weather (Rain on a Tailgate):**
    *   **Zero exposed top end-grain:** The upper ends of all 24 Blackwood staves terminate at $Z = 305\text{ mm}$, tucked $12\text{ mm}$ inside the overhanging rolled drip skirt of the $1.2\text{ mm}$ 304 stainless dome crown and sealed against driving rain by a $6\text{ mm}$ high-temp silicone O-ring cord.
    *   **Drained bottom chime:** The lower stave ends sit on a $6\text{ mm}$ closed-cell silicone sponge cord inside the $25\text{ mm}$ stainless base chime rim. Six $\varnothing 8\text{ mm}$ weep slots punched at the bottom of the stainless chime let any rainwater running down the staves drain immediately rather than pooling against the end-grain.
    *   **Moisture barrier:** The $50\text{ mm}$ calcium silicate core is wrapped in overlapped $0.08\text{ mm}$ aluminium foil tape behind the staves, so neither winter humidity nor damp coastal air can wick into the insulation.
*   **Vibration & Sudden Stops (BYD Shark 6 Corrugations):**
    *   **Stone retention:** The $6.10\text{ kg}$ cordierite stone sits inside a $12\text{ mm}$ deep recessed ring welded to the $1.5\text{ mm}$ stainless hearth pan, cushioned underneath by the $50\text{ mm}$ calcium silicate load disk and radially by a $6\text{ mm}$ braided ceramic fibre rope gasket. For severe outback corrugations, the stone lifts straight out through the $400\text{ mm}$ mouth in 5 seconds and rides vertically in its padded canvas tote strapped against the tub wall.
    *   **Insulation retention:** The rigid $50\text{ mm}$ calcium silicate polygon dome locks the $75\text{ mm}$ AES blanket mechanically against the inner stainless liner so the blanket cannot slump or settle under vertical G-loads.
    *   **Emergency braking restraint:** Four ratchet straps clip from the oven’s four $4.0\text{ mm}$ stainless hoop brackets to the Shark 6’s factory tie-down rings, holding the $42.6\text{ kg}$ drum against a $10g$ forward stop without stressing the wood staves.
*   **Pack-Down Routine:**
    *   Shut off the LCC27 bottle valve. Because the outer wood shell runs at $44.7^\circ\text{C}$ and the handles sit at $28^\circ\text{C}$, the exterior can be handled immediately after dinner.
    *   Pull the $430\text{ mm}$ stone out with leather Welding gloves into its canvas heat-proof sleeve so the oven cools in under 25 minutes.
    *   Pull the three spring-ball hitch pins, slide out the three stainless tripod legs, and lift the oven into the Shark 6 tub using the two side bar handles.
*   **On-Site Cleaning (Gas-Only Mode; No Wood Soot):**
    *   We intentionally omit wood-burning hardware: burning timber in a $480\text{ mm}$ chamber leaves ash in the gas burner ports and tars the blonde/golden Blackwood exterior above the mouth.
    *   To clean after cooking, turn the $6.8\text{ kW}$ burner to full for 10 minutes with the preheat baffle on (pyrolysing spilled cheese and semolina on the cordierite deck to white ash at $480^\circ\text{C}$), brush the ash forward out the stainless mouth chute with a brass bristle brush, and wipe the stainless dome crown and oiled Blackwood staves with a damp microfibre cloth.

---

### 7. Wood Movement Detail

*   **Species & Cut:** **24 staves** of $16\text{ mm}$ thick **quarter-sawn Tasmanian Blackwood** (*Acacia melanoxylon*, dry density $640\text{ kg/m}^3$, radial shrinkage $1.8\%$, tangential shrinkage $4.2\%$). Quarter-sawing puts the radial plane across the $89\text{ mm}$ max stave width.
*   **Calculated Circumferential Movement:** Across a $\pm 4\%$ wood equilibrium moisture content (EMC) swing between a wet Adelaide Hills winter camp ($14\%$ EMC) and a dry $40^\circ\text{C}$ summer day plus $69.3^\circ\text{C}$ inner-face heating ($6\%$ EMC), quarter-sawn Blackwood moves $\approx 0.14\%$ per $1\%$ MC change ($\pm 0.56\%$ total). Around the $2140\text{ mm}$ mean perimeter, the 24 staves will collectively expand and contract by **$\pm 12.0\text{ mm}$** ($\pm 0.50\text{ mm}$ per stave).
*   **Why Glue Is Forbidden & How the Spline Groove Works:** Gluing 24 staves into a rigid ring around an incompressible calcium silicate core guarantees a catastrophic split on the first dry cook. Instead, the staves are **dry-coopered**:
    *   Each stave edge is ripped at a $7.5^\circ$ dihedral angle and carries a $4.0\text{ mm} \times 8.0\text{ mm}$ stopped groove along its length (stopping $25\text{ mm}$ short of both ends so the spline is invisible).
    *   Twenty-four loose $3.8\text{ mm} \times 14.0\text{ mm}$ quarter-sawn Blackwood splines lubricated with dry PTFE/beeswax bridge the joints. Each stave is free to shrink or swell across its width while the splines lock radial alignment and block line-of-sight gaps.
*   **Belleville-Sprung Tension Hoops:**
    *   Each $30\text{ mm} \times 2.0\text{ mm}$ 304 stainless hoop is split into two half-bands joined on the left and right flanks by machined C36000 brass trunnion blocks and M8 $\times 75\text{ mm}$ A2-70 stainless socket cap draw-bolts.
    *   Each draw-bolt passes through a stack of **8 stainless Belleville disc springs** (DIN 2093, $18\text{ mm}$ OD $\times 8.2\text{ mm}$ ID $\times 1.0\text{ mm}$ thick, arranged in series-parallel for $6.5\text{ mm}$ working deflection per side = **$13.0\text{ mm}$ total circumferential take-up per hoop**).
    *   As the timber swells in winter rain or shrinks during a long cook, the hoops breathe radially with the staves under a constant $\sim 2.0\text{ kN}$ clamping preload—no crushed wood fibres when wet, no loose rattling staves when bone-dry.
*   **Mouth Arch Isolation:** Where the stave circle is interrupted by the $400\text{ mm}$ mouth, the two flanking king-staves are captured inside a $15\text{ mm}$ deep U-channel return on the $2.0\text{ mm}$ 304 stainless mouth surround, packed with ceramic fibre tape so the staves can slide $\pm 3\text{ mm}$ tangentially inside the stainless trim without opening a gap.
*   **Finish:** **Zero film-forming varnish, epoxy, or polyurethane.** End grain is hot-soaked in $1:1$ pure tung oil and D-limonene citrus solvent; stave faces receive four hand-rubbed coats of polymerised tung oil blended with $15\%$ carnauba and beeswax. It cannot peel, craze, or blister, and recoats in 5 minutes with an oily rag.

---

### 8. Cost Band (ESTIMATE, AUD, Adelaide, October 2026)

#### Part A: Certified Gas Components (Bought New — Never Homemade or Modified)

| Certified Gas Item | Specification | Price (ESTIMATE, AUD, Adelaide, Oct 2026) |
| :--- | :--- | :--- |
| Commercial LPG Oven Burner Assembly | $6.8\text{ kW}$ ($24.5\text{ MJ/h}$) twin-tube stainless burner with factory brass injector, pilot, thermocouple FFD valve, and piezo igniter (e.g., Bromic / Goldstein replacement catering module) | **$245** |
| LCC27 Regulator & Hose Assembly | Certified $2.75\text{ kPa}$, $2\text{ kg/h}$ LCC27 right-angle regulator with $1.2\text{ m}$ braided stainless/elastomer hose to AS/NZS 1869 Class A | **$65** |
| Brass Test Point & Bulkhead Elbow | Certified $1/4"\text{ BSP} \times 3/8"\text{ SAE}$ brass flare bulkhead fitting with pressure test point | **$28** |
| **Subtotal — Certified Gas Hardware** | | **$338** |

#### Part B: Oven Structure, Insulation & Timber (Second-Hand / Salvage vs. All-New Retail)

| Subsystem | Smart Adelaide Build (Gumtree / Marketplace + Makerspace + Uni Shop) | All-New Retail Materials Build |
| :--- | :--- | :--- |
| **Tasmanian Blackwood Timber** ($\sim 0.022\text{ m}^3$ rough-sawn $25\text{ mm}$ quarter-sawn boards) | **$85** *(Reclaimed Blackwood dining tabletop / kilned boards via Gumtree Adelaide)* | **$210** *(Select dressed kiln-dried FAS Blackwood from Otto Timber, Magill)* |
| **304 Stainless Sheet, Tube & Bar** ($1.2\text{ mm}$, $1.5\text{ mm}$, $2.0\text{ mm}$ sheet; $30\times 2$ flat; $32\times 2$ tube) | **$140** *(Offcut sheets & tube from local stainless fabricator scrap bin in Wingfield/Regency Park)* | **$390** *(Cut-to-size retail from Midway Metals / Edcon Steel Adelaide)* |
| **75 mm AES Blanket** (Morgan Superwool Plus, $128\text{ kg/m}^3$, $38\text{ mm}$ roll $\times 3.5\text{ m}^2$) | **$115** *(Half-carton surplus kiln blanket from Adelaide pottery/foundry supplier)* | **$195** *(Full retail cut length from refractory supplier, Pooraka)* |
| **50 mm Calcium Silicate Board** ($250\text{ kg/m}^3$, two $1000 \times 600 \times 50\text{ mm}$ panels + mortar) | **$130** *(Industrial boiler insulation offcut panels)* | **$240** *(Two new boards + sodium silicate adhesive)* |
| **Cordierite Cooking Stone** ($450 \times 450 \times 20\text{ mm}$ kiln shelf cut to $\varnothing 430\text{ mm}$) | **$55** *(Commercial potter’s kiln shelf from Adelaide ceramic supply)* | **$95** *(Retail pizza/kiln cordierite plate)* |
| **C36000 Brass Bar, Belleville Springs, A2-70 Fasteners, Silicone Cord & Tung Oil** | **$95** *(Scrap brass rod + bolt shop Belleville discs & pure tung oil)* | **$165** *(All new retail hardware & finishes)* |
| **Makerspace Adelaide Access & Consumables** (TIG filler, argon contribution, laser time, canvas) | **$80** *(Monthly membership + laser minutes & heavy canvas remnant)* | **$140** *(Membership + new ripstop canvas & welding consumables)* |
| **Subtotal — Structure & Body** | **$700** | **$1,435** |
| **TOTAL PROJECT COST (Including $338 Certified Gas)** | **$1,038 (ESTIMATE, AUD, Adelaide, Oct 2026)** | **$1,773 (ESTIMATE, AUD, Adelaide, Oct 2026)** |

---

### 9. The Three Worst Things About This Concept

1.  **It is still 42.6 kg without the stone and legs—a mandatory two-person lift into the ute.** Even after stripping out the castable dome, thinning the Blackwood staves to 16 mm, and replacing the upper wood hemisphere with a 1.2 mm stainless crown (saving 31.8 kg over the naive design), the physics of wrapping a 125 mm thick insulation wall around a 480 mm chamber drives the outer diameter to 765 mm. The 50 mm calcium silicate shell alone weighs 10.48 kg because the radius is so large. You cannot carry this oven solo without risking a disc injury.
2.  **The 765 mm footprint is too wide for the BYD Shark 6 tailgate, forcing you to carry and set up a tripod.** Because the Shark 6 tailgate is only 517 mm deep, you cannot simply slide the oven onto the tailgate and light it. Every cook requires pulling three 780 mm stainless legs from their roll, pinning them into the bottom bayonet sockets, and flipping a 42.6 kg drum onto its feet before sliding the 6.10 kg stone inside.
3.  **184 coopered surfaces have to be machined and fitted dry, and the wood near the mouth will darken faster than the rear.** Making 24 barrel-curved, bevel-edged, spline-grooved staves close tightly around a tapered drum requires disciplined setup on the table saw and WorkBee CNC router. Furthermore, even with the 1.2 mm stainless upper crown and 2.0 mm stainless mouth eyebrow deflecting the exhaust plume, radiant heat and steam during pizza launches will age and amber the two Blackwood king-staves flanking the mouth faster than the staves at the back of the oven.

---

### 10. One-Screen CAD Parts List (Named Solids, Millimetres)

```text
ASSEMBLY: CASK_430_OVEN_ASM (Origin: Ground plane Z=0 at oven vertical centreline; Stowed Z_max = 420 mm)
│
├── 01_CORE_HOT_ASM
│   ├── HEARTH_STONE_CORDIERITE       Cylinder: OD 430, t 20, Z = 91.5..111.5, offset Y = -20 (toward mouth)
│   ├── INNER_LINER_CYL_304SS         Shell: ID 480, t 1.5, H 55, Z = 111.5..166.5, crescent burner slot at rear-left
│   ├── INNER_LINER_DOME_304SS        Oblate Shell (8-gore): Base ID 480, Rise 110, t 1.5, Z = 166.5..278.0
│   ├── INNER_HEARTH_PAN_304SS        Disk: OD 483, t 1.5, Z = 90.0..91.5, with 12 mm stone retaining ring
│   ├── MOUTH_TUNNEL_304SS            Stadium Arch Shell: W_in 400, H_in 95, Depth 145, t 1.5, Y = -240..-382.5
│   └── PREHEAT_BAFFLE_304SS          Removable Plate: W 410, H 50, t 1.5, hooks into mouth jamb slots
│
├── 02_INSULATION_STACK_ASM
│   ├── AES_BASE_PAD_25MM             Disk: OD 520, t 25, Z = 16.5..41.5
│   ├── CALSIL_BASE_DISK_50MM         Disk: OD 520, t 50, Z = 41.5..91.5
│   ├── AES_WALL_DOME_75MM            Shell (2x38mm lapped): R_in 241.5..R_out 316.5, Crown Z = 278.0..353.0
│   └── CALSIL_STAVE_CORE_50MM        18x Kerfed Polygon Segments: R_in 316.5..R_out 366.5, Crown Z = 353.0..403.0
│
├── 03_COOPERED_SHELL_ASM
│   ├── WOOD_STAVE_STD (x20)          Barrel Stave (Blackwood): L_arc 310, W_bot 99.5, W_top 73.3, t 16.0, bevel 7.5 deg
│   ├── WOOD_STAVE_MOUTH_KING (x2)    Notched Jamb Stave (Blackwood): L_arc 310, t 16.0, profiled for mouth bezel
│   ├── WOOD_STAVE_ABOVE_MOUTH (x2)   Short Header Stave (Blackwood): L_arc 95, Z = 215..305 above mouth arch
│   ├── WOOD_SPLINE_LOOSE (x24)       Flat Strip (Blackwood): L 260 (or 65 above mouth), W 14.0, t 3.8
│   ├── BASE_CHIME_PAN_304SS          Pan: OD 680, t 1.5, Z = 15.0..16.5, Rim H 25 (Z = 15..40), 6x Ø8 weep slots
│   ├── TOP_DOME_CROWN_304SS          Spherical Cap: Chord OD 560, Rise 115 (Z = 305..420), t 1.2, 15 mm drip skirt
│   └── SILICONE_SEAL_CORD (x2)       Torus: Ø6.0 cross-section, L 2140 (bottom chime) & L 1760 (top crown skirt)
│
├── 04_HARDWARE_ACCENTS_ASM
│   ├── HOOP_LOWER_HALF_304SS (x2)    Conical Band: ID 732, W 30, t 2.0, Z = 55..85
│   ├── HOOP_UPPER_HALF_304SS (x2)    Conical Band: ID 580, W 30, t 2.0, Z = 265..295
│   ├── TRUNNION_BLOCK_BRASS (x8)     Turned/Milled Block (C36000): Ø28 x 45, M8 bore, riveted to hoop ends
│   ├── BELLEVILLE_BOLT_STACK (x4)    M8x75 A2-70 Cap Screw + 8x DIN 2093 (18x8.2x1.0) Stainless Disc Springs
│   ├── MOUTH_BEZEL_EYEBROW_304SS     Flanged Arch Frame: W_out 440, H_out 135, t 2.0, 35 mm upper flame eyebrow
│   ├── CROWN_BOSS_BRASS              Turned Medallion (C36000): OD 85, H 15.8, Z = 404.2..420.0
│   ├── HANDLE_BRACKET_304SS (x4)     Bent Strap: W 30, t 4.0, Stand-off 45, bolted to hoop trunnion mounts
│   ├── HANDLE_BAR_BLACKWOOD (x2)     Turned Cylinder: OD 32, ID 10.5, L 180, spanning left & right bracket pairs
│   └── MAKERS_BADGE_BRASS            Curved Plate (C36000): 70 x 35 x 2.0, M4 brass screws at X = +375
│
└── 05_BURNER_AND_STAND_ASM
    ├── BURNER_BAY_BOX_304SS          Enclosure: 260 x 140 x 85, t 1.5, bolted under rear-left quadrant
    ├── CERTIFIED_BURNER_6P8KW        Bought Commercial Module: 6.8 kW twin-tube + FFD + piezo + LCC27 hose
    ├── LEG_BAYONET_SOCKET_304SS (x3) Tube Stub: OD 38, ID 32.4, L 65, angled 12 deg outward at 120 deg intervals
    └── TRIPOD_LEG_ASM (x3)           Tube: OD 32, t 2.0, L 780 + Blackwood Sleeve (OD 44, L 220) + M12 Rubber Foot
```
