adxb-pxthxn/pizza-oven/design/tailgate/prompts/01-third.md

Propose ONE concept that is architecturally different from both of these, which other people are designing in parallel:

- A full coopered wood shell wrapped around 75 mm AES and 50 mm calcium silicate.
- A minimum-mass hot-skinned metal dome in the manner of a portable commercial oven, thin insulation, shell too hot to hold, cool handles.

Your concept must still meet every hard requirement in the system instructions: circular dome, 381 mm pizza with turning room, certified gas, Shark 6 tub and tailgate, heirloom finish, makerspace and university workshop, low cash cost.

A hybrid is allowed if the split is thermal, not decorative. Example of a real split: a cool-touch metal cooking module sized only as thick as the skin temperature requires, and a wood element that never becomes the insulation vessel. Example of a fake split: wood veneer glued over the same hot shell. Reject the fake one if that is where you were headed, and say so.

Return the same ten sections asked of a single developed concept:

1. Name and one paragraph.
2. Why this architecture is not the wood shell and not the hot-skin dome.
3. Dimensions, stack, mouth, legs, stowed envelope, tailgate yes or no.
4. Mass table with the arithmetic.
5. Temperatures, with the resistance sum. If there is a gap between metal and wood, calculate the radiation across it and say whether the gap is ventilated, and what happens when the vents are blocked.
6. Build path and the three expensive-looking details.
7. Gas power and a yes/no on wood fire.
8. AUD cost band. Certified parts separate.
9. The three worst things.
10. Named solids in millimetres.

One concept only.
