adxb-pxthxn/pizza-oven/design/tailgate/prompts/02-critique.md

You have three concepts from earlier passes. Critique them as if you will have to build the winner. Then lock the one design that should be modelled.

## Concept A — Cooper's Dome, Cask-430 (the wood body Adib asked for)

24 dry-coopered 16 mm quarter-sawn blackwood staves, frustum from Ø765 at the belly to Ø560 under a 1.2 mm 304 crown. Floor Ø430 × 20. Chamber Ø480, apex 165, mouth 400 × 95, ratio 0.576. Stack 1.5 liner + 75 AES + 50 calcium silicate + 16 wood. Wood inner face 69.3°C, outer 44.7°C, your arithmetic, and it matches the resistance network. Mass you quoted: 52.6 kg complete, 42.6 kg with stone and legs off. Two-person lift. Does not sit on the 517 mm tailgate. Tripod. Gas 6.8 kW. No wood fire. Smart-build cost about $1,040 AUD including $338 certified gas. Straight-stave alternative was not this one; this one is a tapered barrel.

## Concept B — Angas 430 (your unconstrained optimum)

Double-skin 304, no wood shell. Brass 35 × 3 mm cinch band, jarrah handles only. Plan Ø625, body height 315, stowed 380 with the valve box. Floor Ø430 × 20, chamber Ø470, apex 165, mouth 395 × 90, ratio 0.545. Wall 1.2 + 50 AES + 25 calcium silicate + 1.2, skin 61.8°C. Crown 1.2 + 75 AES + 1.2, skin 64.5°C. Mass 25.76 kg stone out, 31.86 kg stone in. One-person lift without the stone. Does not sit on the tailgate; you also argue it should not, because a flame on the tailgate has no 300 mm clearance to the ute. Camp-table feet or a 750 mm tripod. Gas 5.8 kW. No wood fire. Cost band $490–805 AUD. You discarded the wood shell at about 50 kg and Ø763, and a castable dome at 54 kg.

## Concept C — Angas Binnacle (hybrid)

Cool 304 cupola (75 AES + 30 calcium silicate, skin about 51°C) standing in an 18 mm blackwood ring with a 15 mm air gap. You calculated the choked gap (vents blocked) at 78.5°C on the wood inner face. Plan Ø768, stowed height 410. Floor Ø450. Mass 54 kg ready, 45 kg with stone and leg tubes out. Heavier than the full wood shell because it pays for a steel vessel and a wood vessel. Two-person. Not on the tailgate.

## A false sentence in Concept B

You wrote that the Ø430 × 20 stone lifts out through the 395 × 90 mouth by tilting 22°, and that the mouth diagonal is 403 mm. Check it. A disk of diameter D tilted so its projected width equals the mouth width W has projected height D·sin(acos(W/D)), and the 20 mm thickness adds more. For D=430, W=395, that tilt is 23.3° and the projected height is about 170 mm against a 90 mm mouth. The stone does not come out through that mouth. The brass cinch band, which lets the crown lift off, is the real access. Say so, and do not repeat the diagonal trick.

## What the coordinator will model

The three concepts agree on one thing: a thermally serious 15 inch circular oven does not sit on a 517 mm tailgate, and a wood shell that stays under 80°C is a two-person lift near 45 kg. Concept B is the only one-person oven. The wood in B is the handles, not the body. That is the hybrid that survives the requirements: jarrah where a hand closes on it, brass where the eye looks for a joint, stainless everywhere the heat is.

Attack this before you bless it:

1. Mouth 395 mm for a 381 mm pizza is 7 mm per side. Arc Lite gives a 305 mm pizza about 10 mm per side through a mouth as wide as the chamber. Is 420 mm wide and 95 mm high the right mouth on a 470 mm chamber, ratio 95/165 = 0.576, or does widening the mouth cost a flame roll you can quantify?
2. Floor radial clearance around a 381 mm pizza on a 430 mm stone is 24.5 mm. Arc Lite is tighter. Keep 430, or spend the kilograms to go to 450?
3. Skin at 62–65°C. A bare hand on bare stainless at that temperature is a short touch, not a lean. Are the jarrah handles and the feet the only surfaces you are willing to call touch-safe? If the crown should be under 55°C, what thickness of AES does that take and what does it weigh?
4. Is a removable crown, lifted off the cinch band, acceptable on a corrugated road, or does the band walk? How do you lock it for the drive and still open it in the dark?
5. Any part of Concept A or C that B should steal without giving back the 20 kg.

## Return

1. A comparison table. Rows: A, B, C. Columns: plan diameter, stowed height, mass stone-out, mass ready, one-person lift, sits on Shark tailgate, heat-up you believe, shell temperature a hand meets, durability on a dirt road, safety (gas, touch, ute clearance), heirloom, build difficulty on the published makerspace list plus a university TIG shop, AUD band. One sentence under the table: the recommendation, including the hybrid and what it refuses to be.
2. The locked dimensions for the design to model, in millimetres, as a list of named numbers a CAD file can copy. Include the mouth, the floor, the chamber, the apex, every insulation thickness, the cinch joint, the handles, the legs, and the stowed envelope. If you change B, show the mass delta.
3. The five things the model must not get wrong (stone access, expansion joint, gas parts that are bought, wood movement on the handles only, the tailgate).
4. Open questions that are Adib's, not yours. At most eight. Each one changes a real dimension or a real purchase.

No new concept. No pep. Do the mouth and the stone again with arithmetic.
