adxb-pxthxn/pizza-oven/design/shop/bench-lathe/bench-spindle-light.html

Fig 1Bench spindleClick or press 1–4turn · 398 rpm · mild Ø20

Whatever the shaft is doing: blank, drill, disc, or cutterJarrah at the handwheel, the feet, and the safety keyStarted on the bench, not cast. Two 600 mm rails, two pillow blocks, one shaft. The ProForm motor is geared 2:1, so a 4900 rpm class motor is 2450 at the shaft. The open belt is about 575 mm at 168 mm centres. Turn, drill, sand on the outboard disc, or take a 0.3 mm mill cut. The rails are the limit, not the motor. Footprint 730 by 340 mm.
