adxb-pxthxn/pizza-oven/design/stream-1/prompts/sunfyre.md

Sunfyre is a bread setpoint, not a new shape. Do not use tools. Reply in plain text.

The Tessarion barrel is unchanged. With the door open, gas at 260 C holds the steel at 214 C. With the door shut, the mouth leak is about 3 percent of the open arch. The same 260 C gas then holds the steel at 240 C.

A sweep with the door shut:
- gas 220 C, floor 201 C
- gas 230 C, floor 211 C, plate 223 C
- gas 240 C, floor 220 C

The pizza setpoint stays gas 360 C, floor 301 C, door open. Is 211 C a sound deck for a hearth loaf in this oven, and is 240 C too hot for that bake? Answer in a few sentences. No file writes.
