adxb-pxthxn/pizza-oven/design/stream-1/arrax/front.png

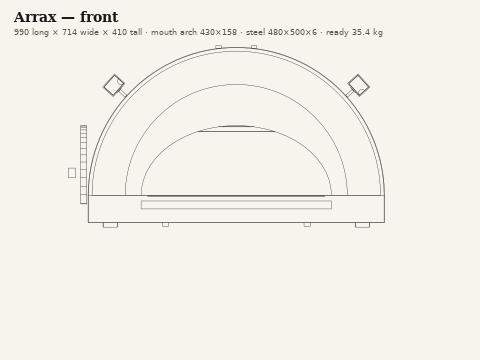
design/stream-1/arrax/front.png
