adxb-pxthxn/pizza-oven/design/stream-1/arrax/section.png

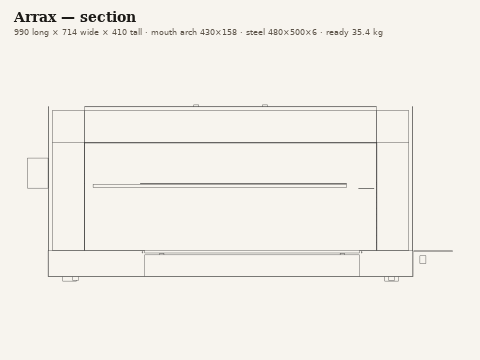
design/stream-1/arrax/section.png
