adxb-pxthxn/pizza-oven/design/stream-1/arrax/side.png

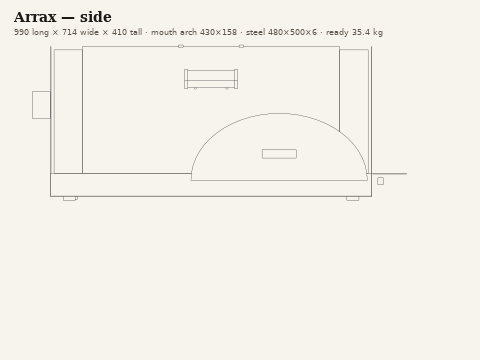
design/stream-1/arrax/side.png
