adxb-pxthxn/pizza-oven/design/stream-1/arrax/top.png

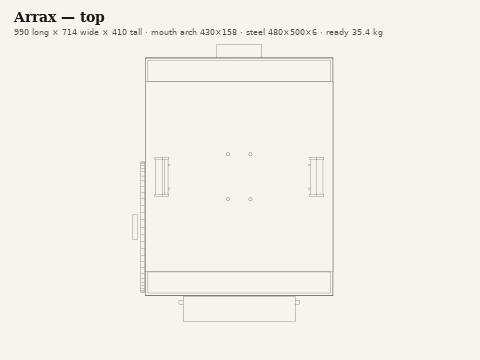
design/stream-1/arrax/top.png
