adxb-pxthxn/pizza-oven/design/stream-1/caraxes/front.png

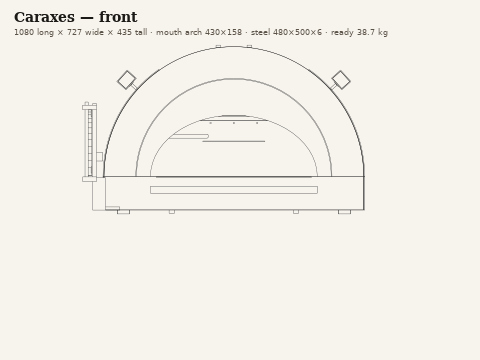
design/stream-1/caraxes/front.png
