adxb-pxthxn/pizza-oven/design/stream-1/caraxes/section.png

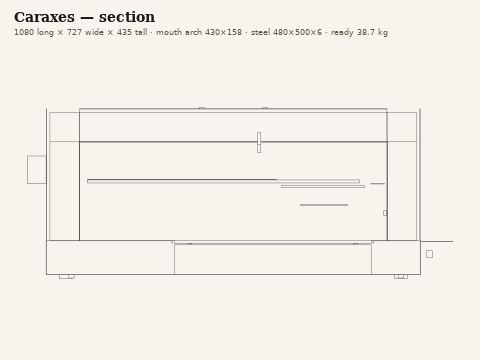
design/stream-1/caraxes/section.png
