adxb-pxthxn/pizza-oven/design/stream-1/caraxes/side.png

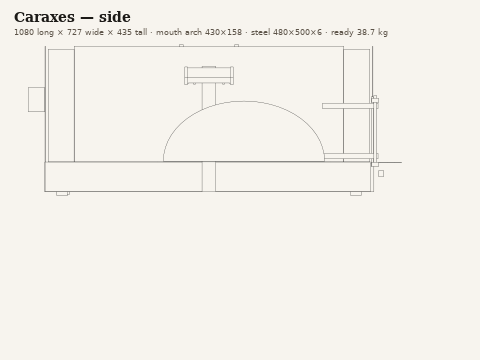
design/stream-1/caraxes/side.png
