adxb-pxthxn/pizza-oven/design/stream-1/caraxes/top.png

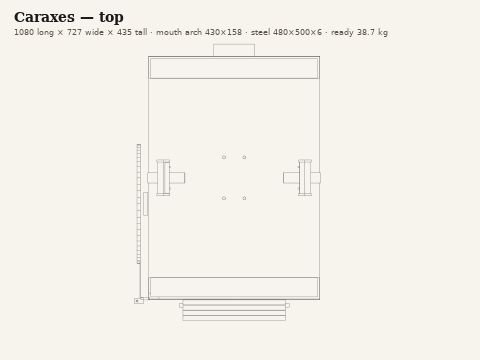
design/stream-1/caraxes/top.png
