adxb-pxthxn/pizza-oven/design/stream-1/sheepstealer/section.png

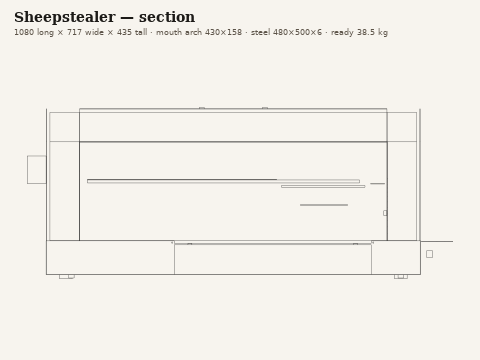
design/stream-1/sheepstealer/section.png
