adxb-pxthxn/pizza-oven/design/stream-1/sheepstealer/side.png

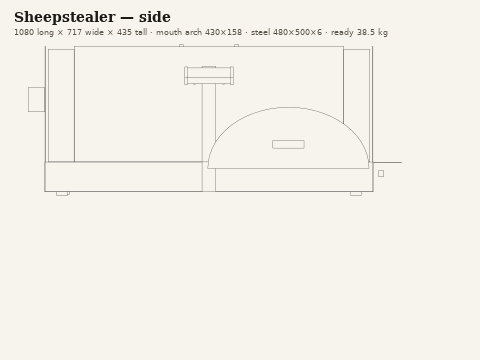
design/stream-1/sheepstealer/side.png
