adxb-pxthxn/pizza-oven/design/stream-1/stormcloud/front.png

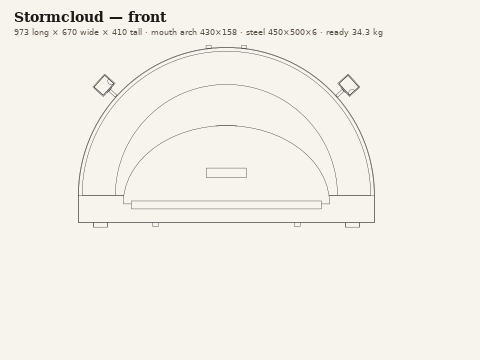
design/stream-1/stormcloud/front.png
