adxb-pxthxn/pizza-oven/design/stream-1/stormcloud/section.png

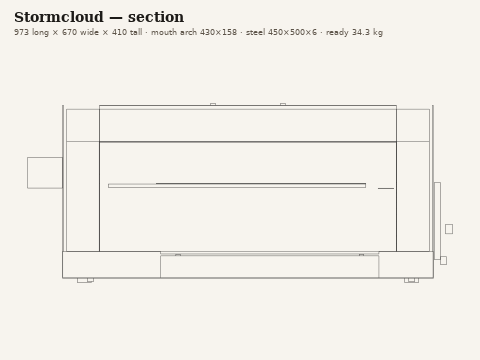
design/stream-1/stormcloud/section.png
