adxb-pxthxn/pizza-oven/design/stream-1/stormcloud/side.png

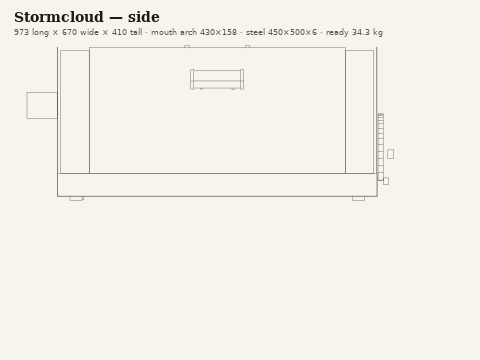
design/stream-1/stormcloud/side.png
