adxb-pxthxn/pizza-oven/design/stream-1/stormcloud/top.png

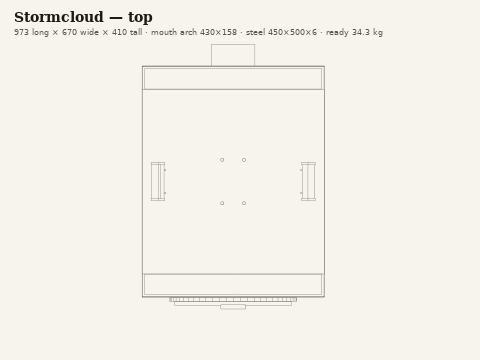
design/stream-1/stormcloud/top.png
