adxb-pxthxn/pizza-oven/design/stream-1/tessarion/front.png

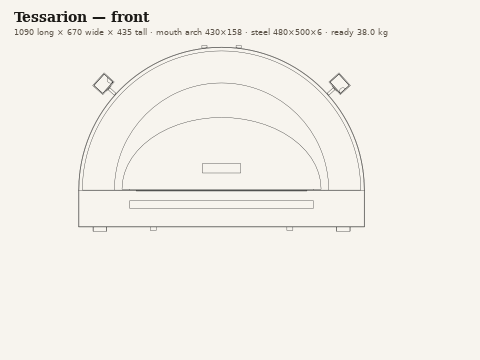
design/stream-1/tessarion/front.png
