adxb-pxthxn/pizza-oven/design/stream-1/tessarion/section.png

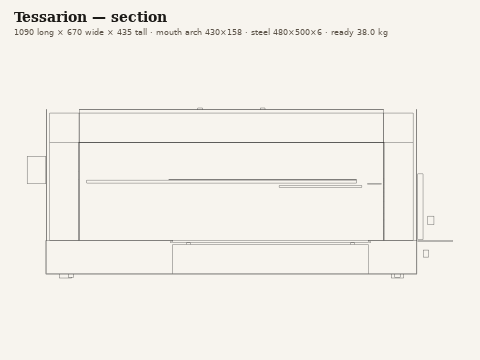
design/stream-1/tessarion/section.png
