adxb-pxthxn/pizza-oven/design/stream-1/tyraxes/section.png

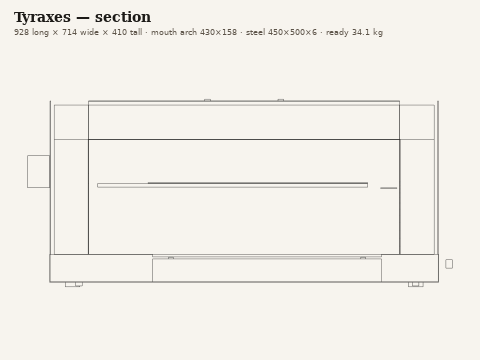
design/stream-1/tyraxes/section.png
