adxb-pxthxn/pizza-oven/design/stream-1/vermax/front.png

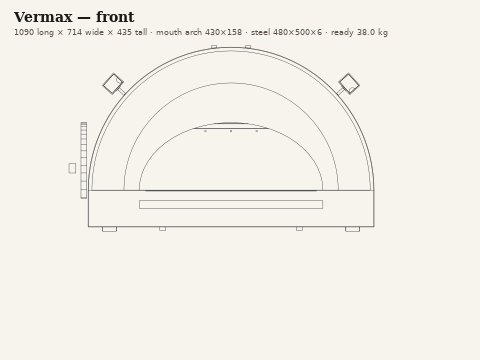
design/stream-1/vermax/front.png
