adxb-pxthxn/pizza-oven/design/stream-1/vermax/side.png

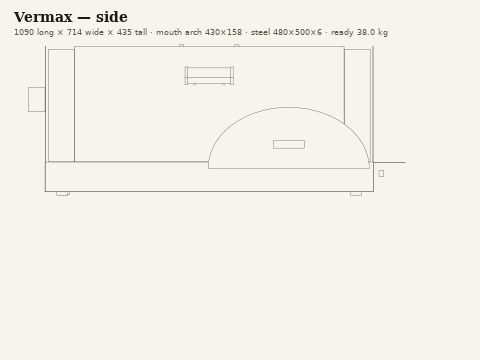
design/stream-1/vermax/side.png
