adxb-pxthxn/pizza-oven/design/stream-2/balerion/front.png

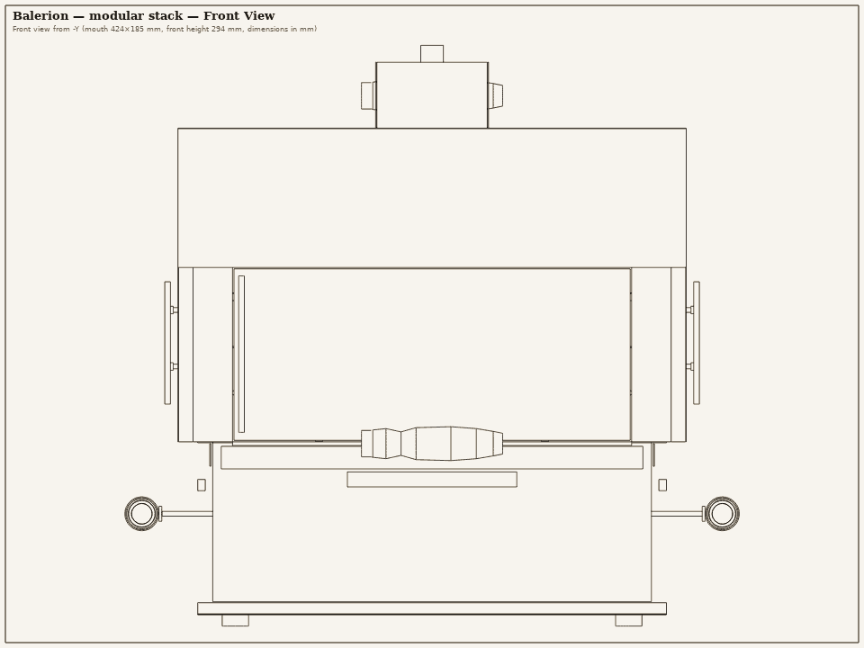
design/stream-2/balerion/front.png
