adxb-pxthxn/pizza-oven/design/stream-2/balerion/section.png

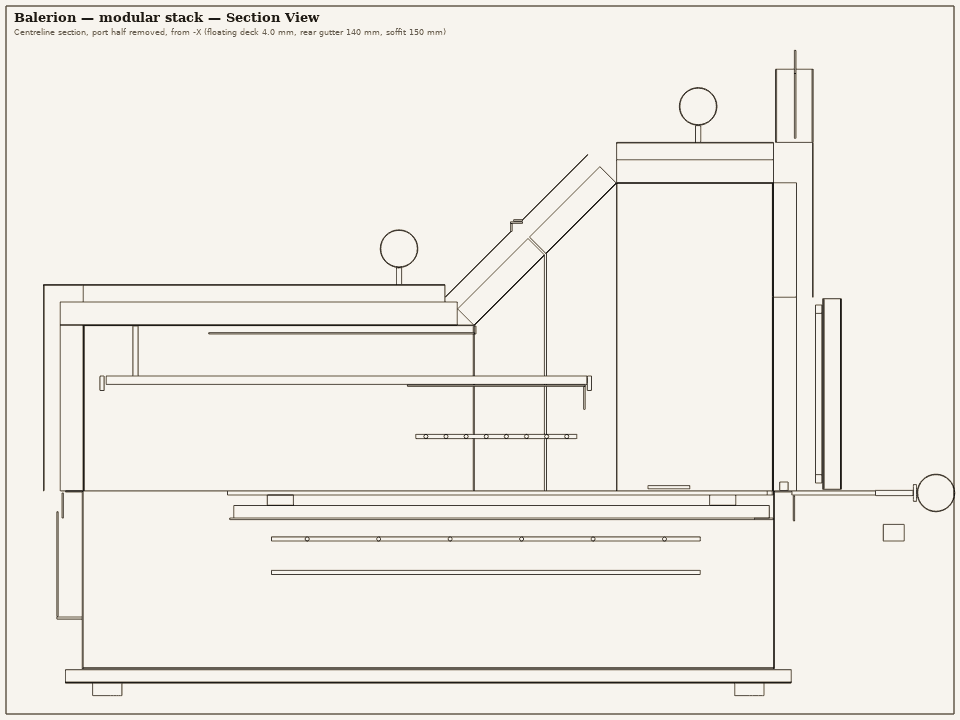
design/stream-2/balerion/section.png
