adxb-pxthxn/pizza-oven/design/stream-2/balerion/side.png

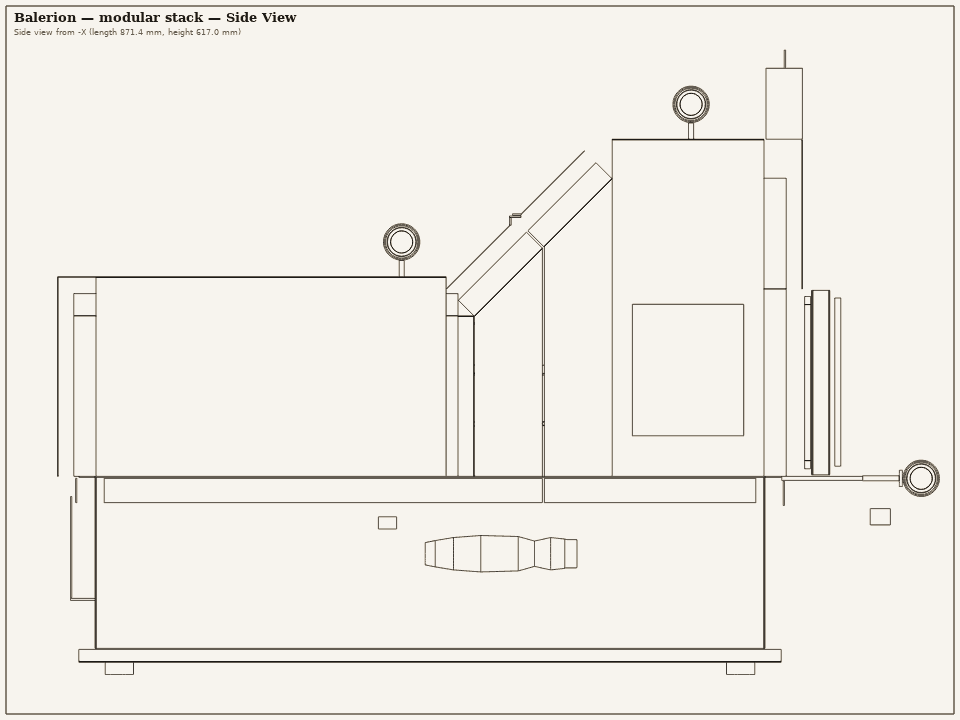
design/stream-2/balerion/side.png
