adxb-pxthxn/pizza-oven/design/stream-2/balerion/top.png

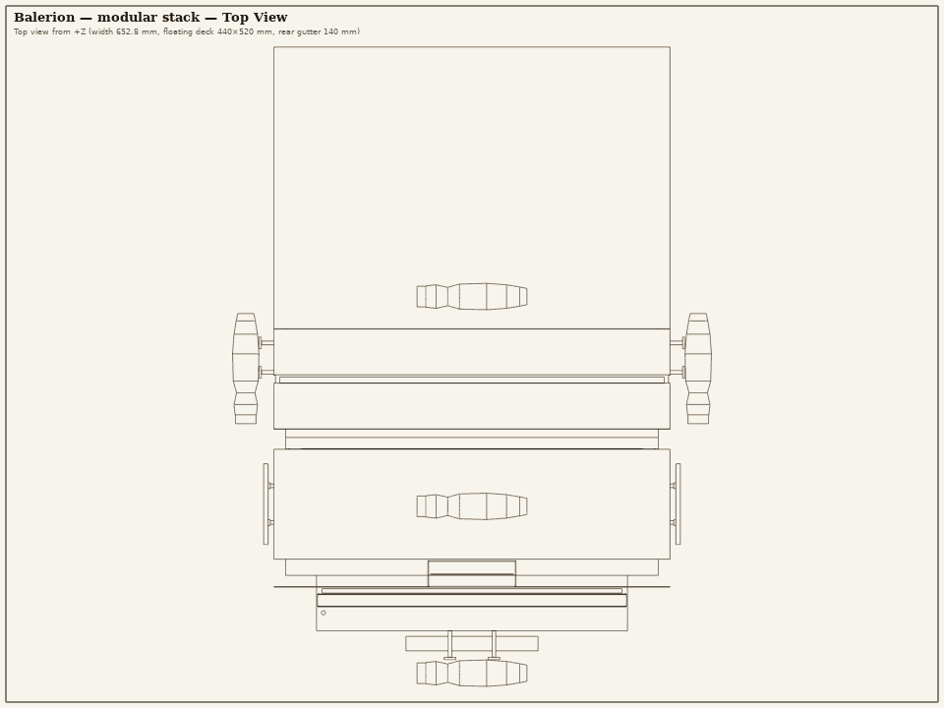
design/stream-2/balerion/top.png
