adxb-pxthxn/pizza-oven/design/stream-2/meleys/front.png

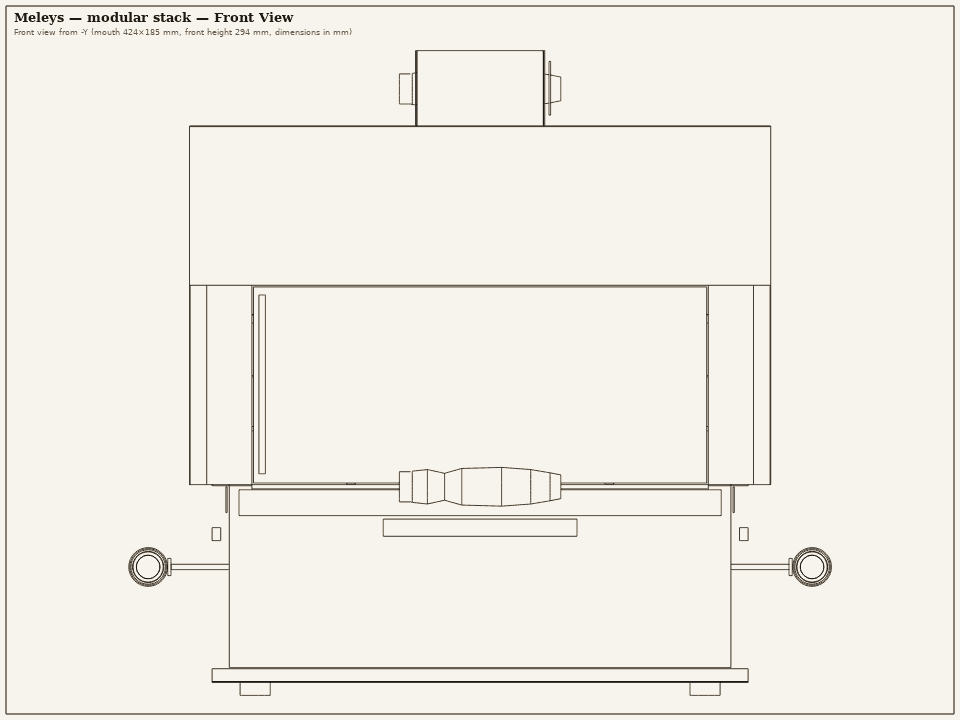
design/stream-2/meleys/front.png
