adxb-pxthxn/pizza-oven/design/stream-2/meleys/section.png

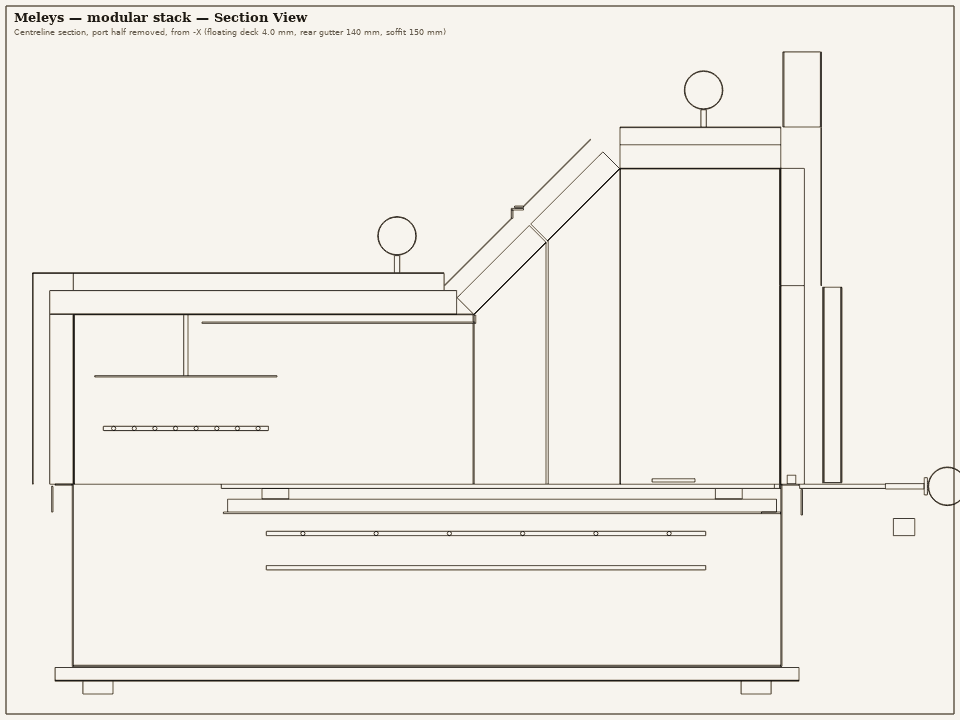
design/stream-2/meleys/section.png
