adxb-pxthxn/pizza-oven/design/stream-2/meleys/side.png

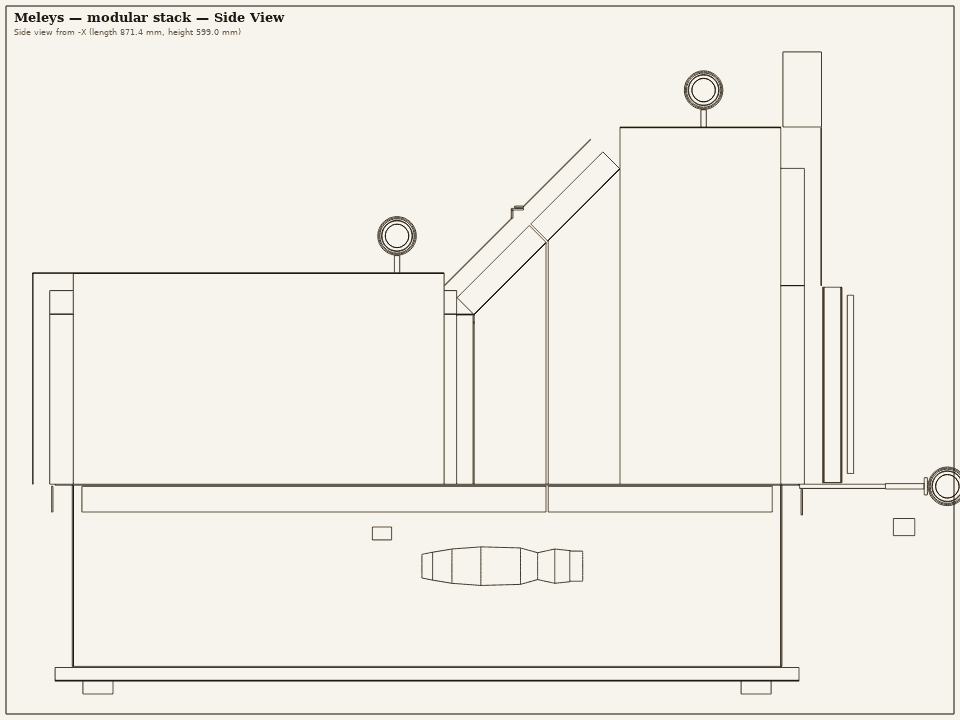
design/stream-2/meleys/side.png
