adxb-pxthxn/pizza-oven/design/stream-2/meraxes/front.png

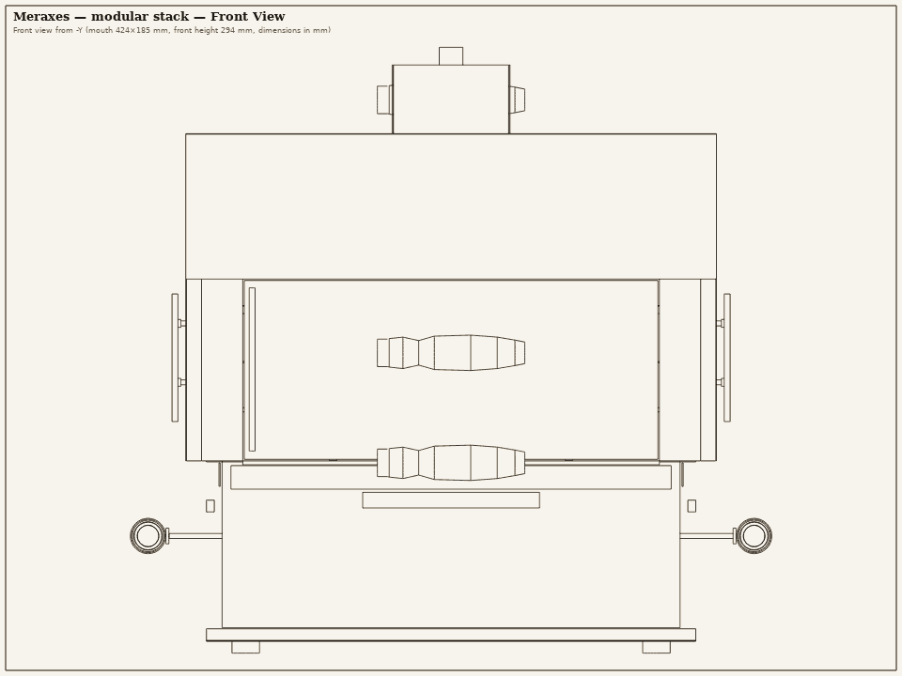
design/stream-2/meraxes/front.png
