adxb-pxthxn/pizza-oven/design/stream-2/morghul/top.png

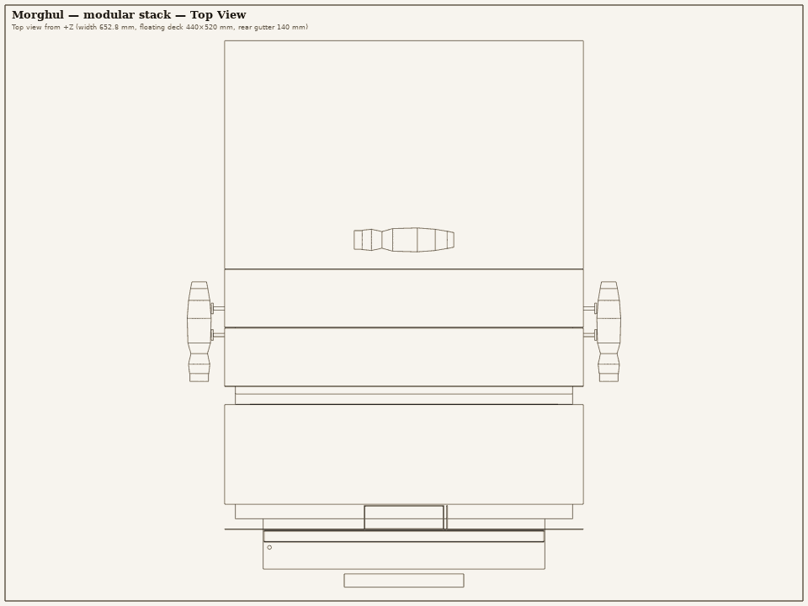
design/stream-2/morghul/top.png
