adxb-pxthxn/pizza-oven/design/stream-2/seasmoke/side.png

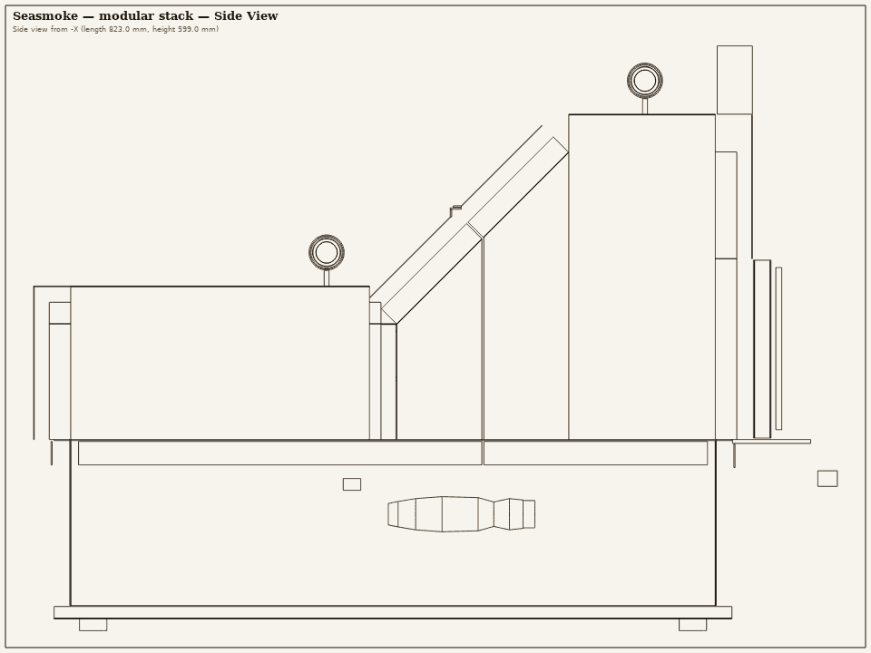
design/stream-2/seasmoke/side.png
