adxb-pxthxn/pizza-oven/design/stream-2/sheepstealer/front.png

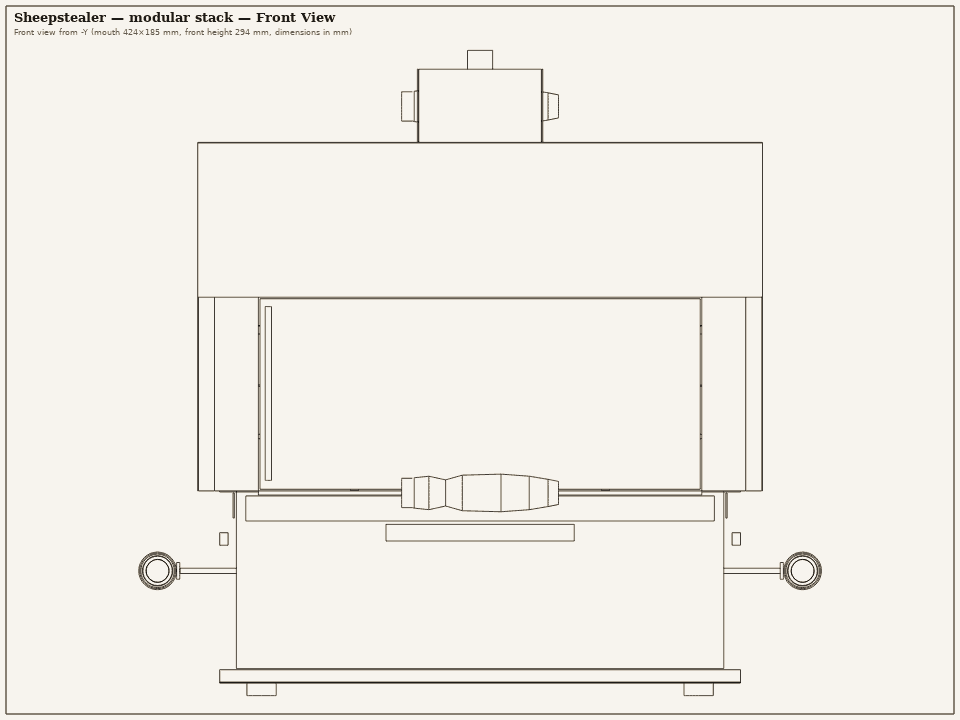
design/stream-2/sheepstealer/front.png
