adxb-pxthxn/pizza-oven/design/stream-2/sheepstealer/top.png

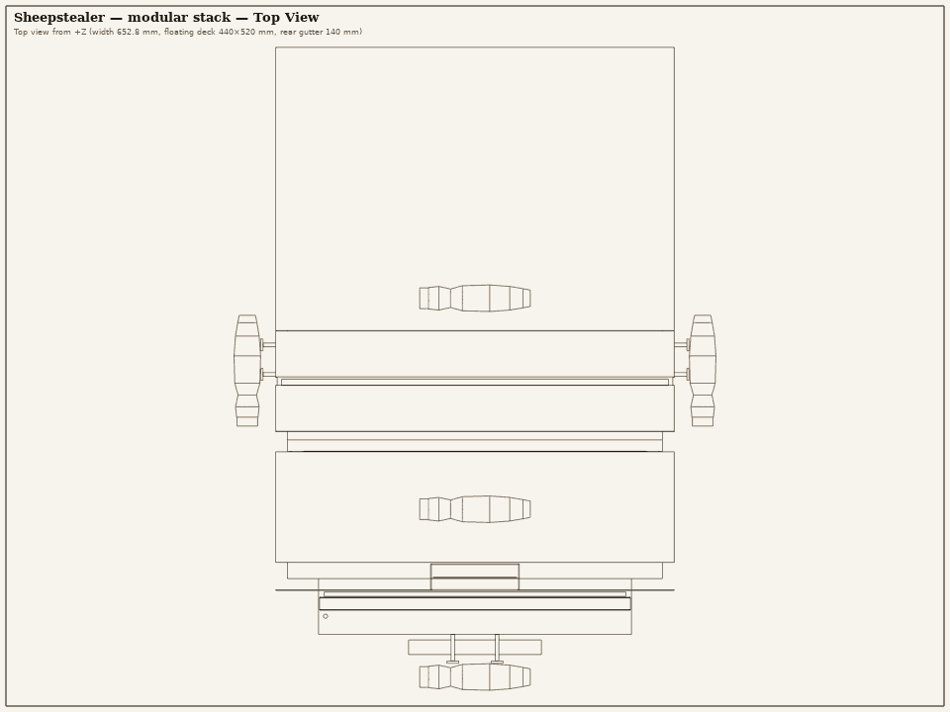
design/stream-2/sheepstealer/top.png
