adxb-pxthxn/pizza-oven/design/stream-2/vermax/section.png

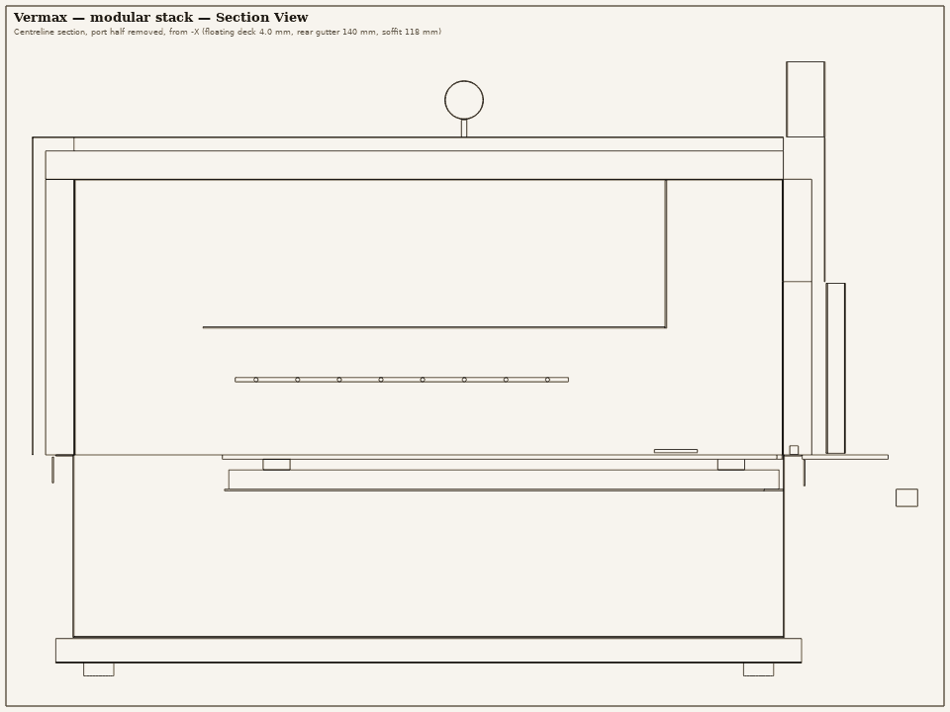
design/stream-2/vermax/section.png
