adxb-pxthxn/pizza-oven/design/stream-2/vermax/side.png

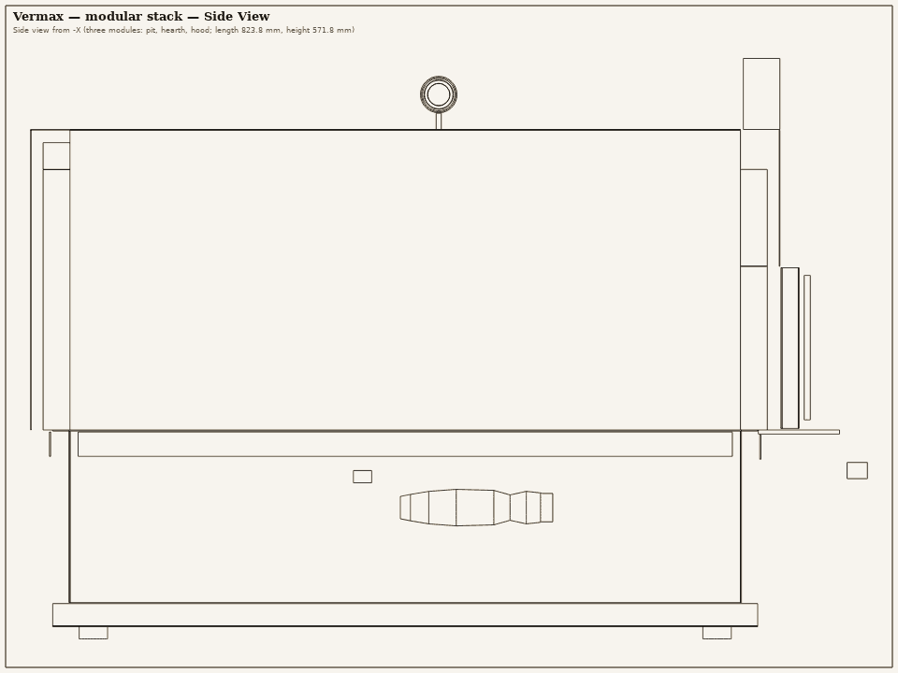
design/stream-2/vermax/side.png
