adxb-pxthxn/pizza-oven/design/tailgate/concepts/angas-430-cutaway.png

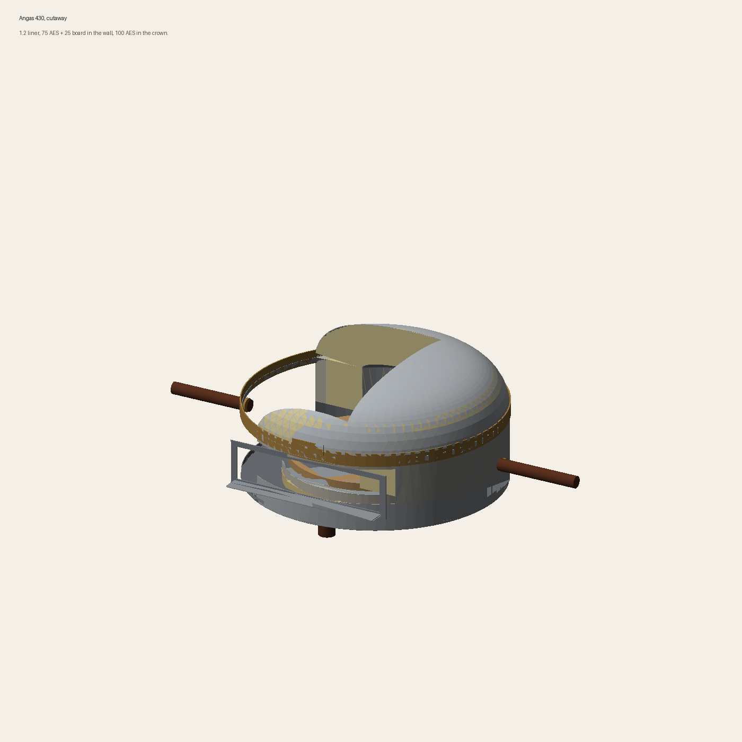
design/tailgate/concepts/angas-430-cutaway.png
