adxb-pxthxn/pizza-oven/design/tailgate/concepts/angas-430-exploded.png

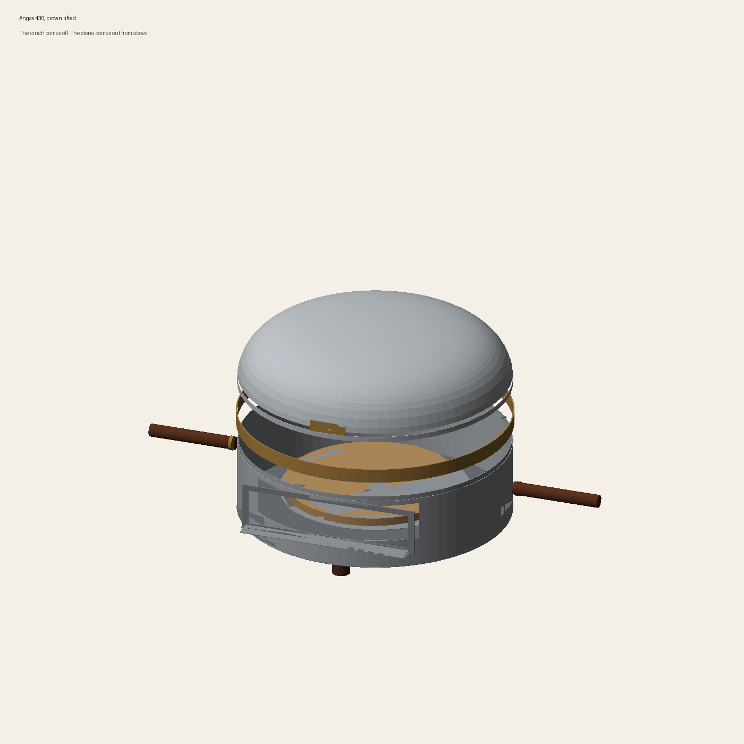
design/tailgate/concepts/angas-430-exploded.png
