adxb-pxthxn/pizza-oven/design/tailgate/concepts/angas-binnacle.png

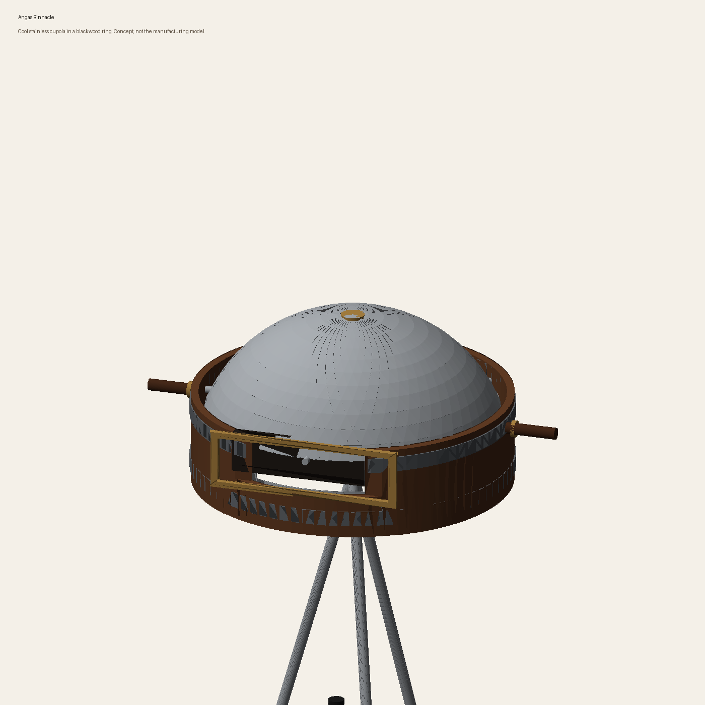
design/tailgate/concepts/angas-binnacle.png
