adxb-pxthxn/pizza-oven/design/tailgate/concepts/cask-430.png

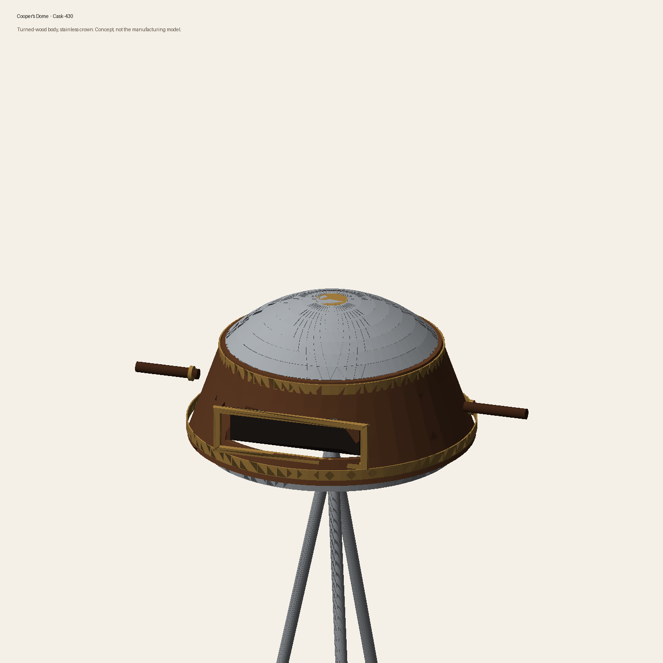
design/tailgate/concepts/cask-430.png
