adxb-pxthxn/pizza-oven/design/tailgate/drawings/ga-arrangement.png

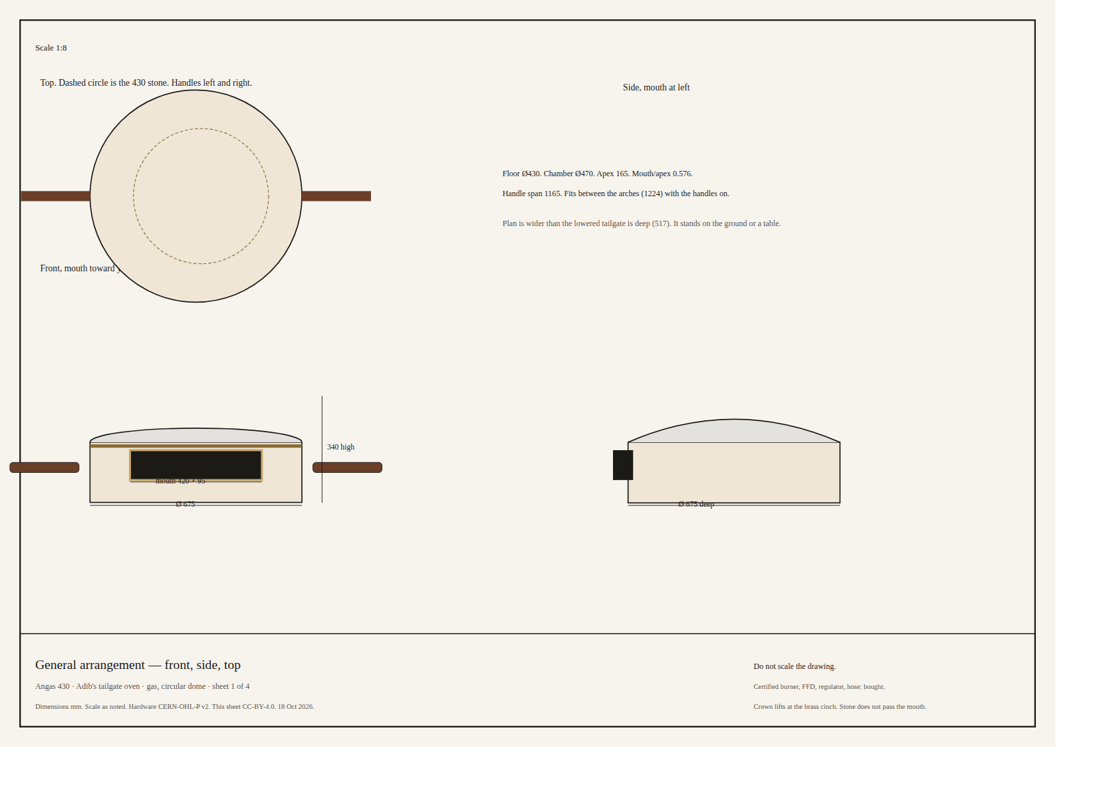
design/tailgate/drawings/ga-arrangement.png
