adxb-pxthxn/pizza-oven/design/tailgate/drawings/ga-exploded.png

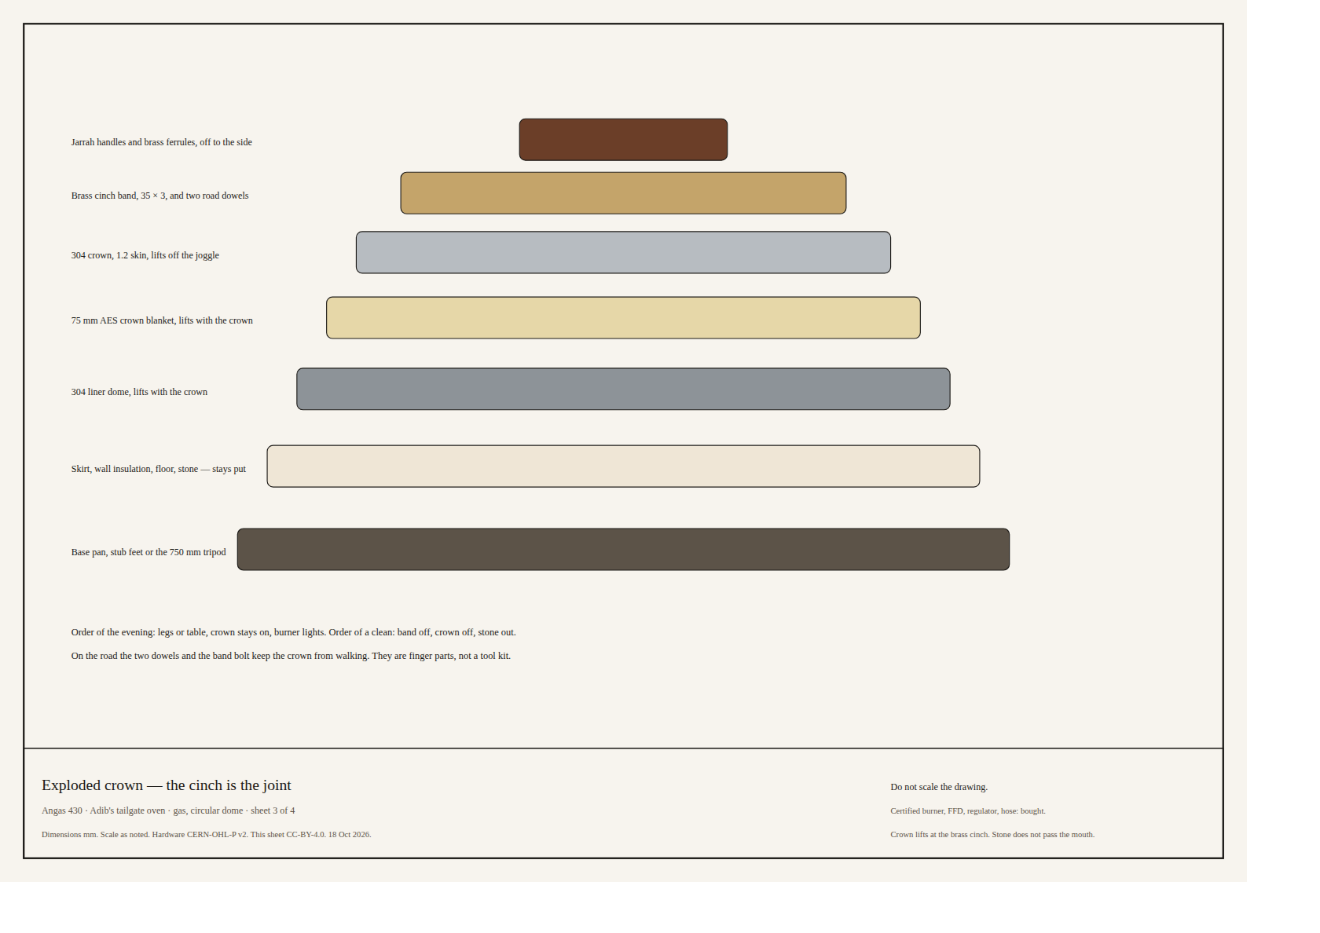
design/tailgate/drawings/ga-exploded.png
