adxb-pxthxn/pizza-oven/design/tailgate/drawings/ga-section.png

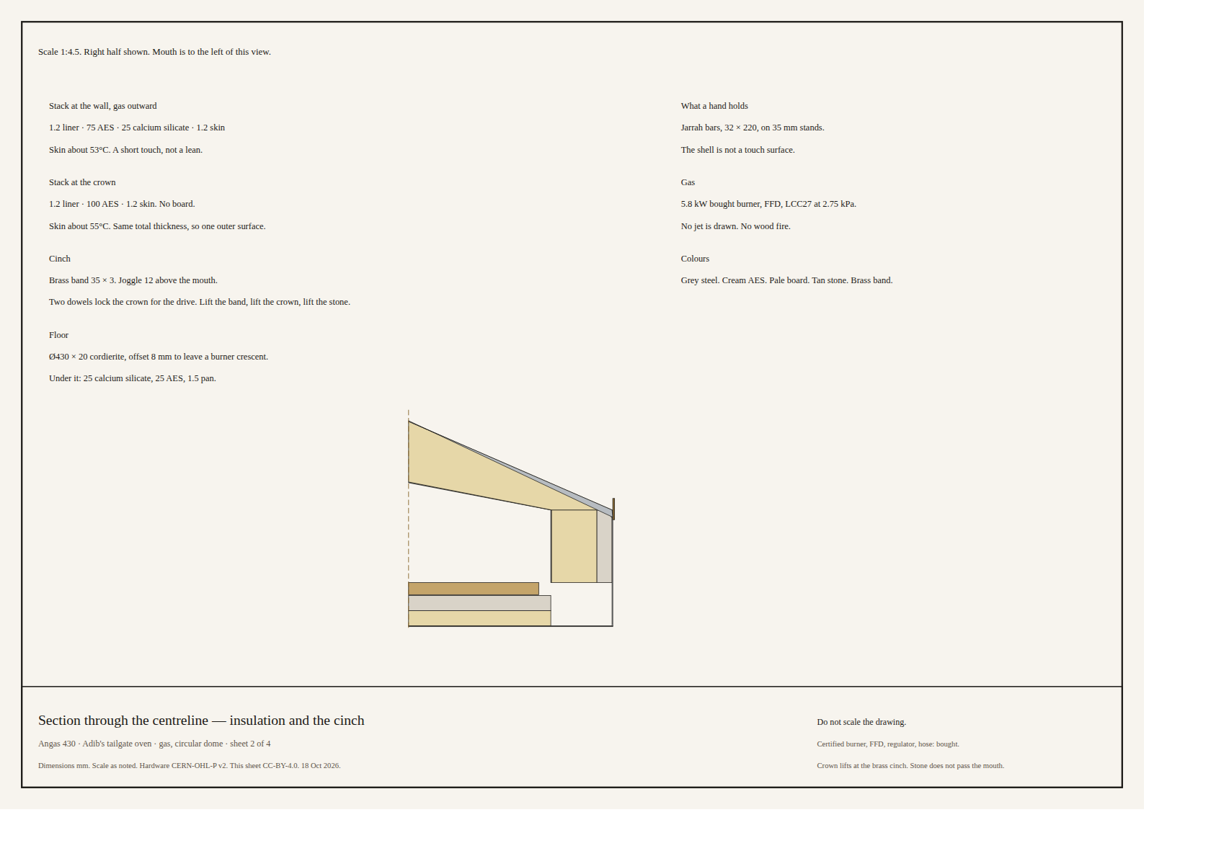
design/tailgate/drawings/ga-section.png
