adxb-pxthxn/pizza-oven/design/tailgate/drawings/ga-stowed.png

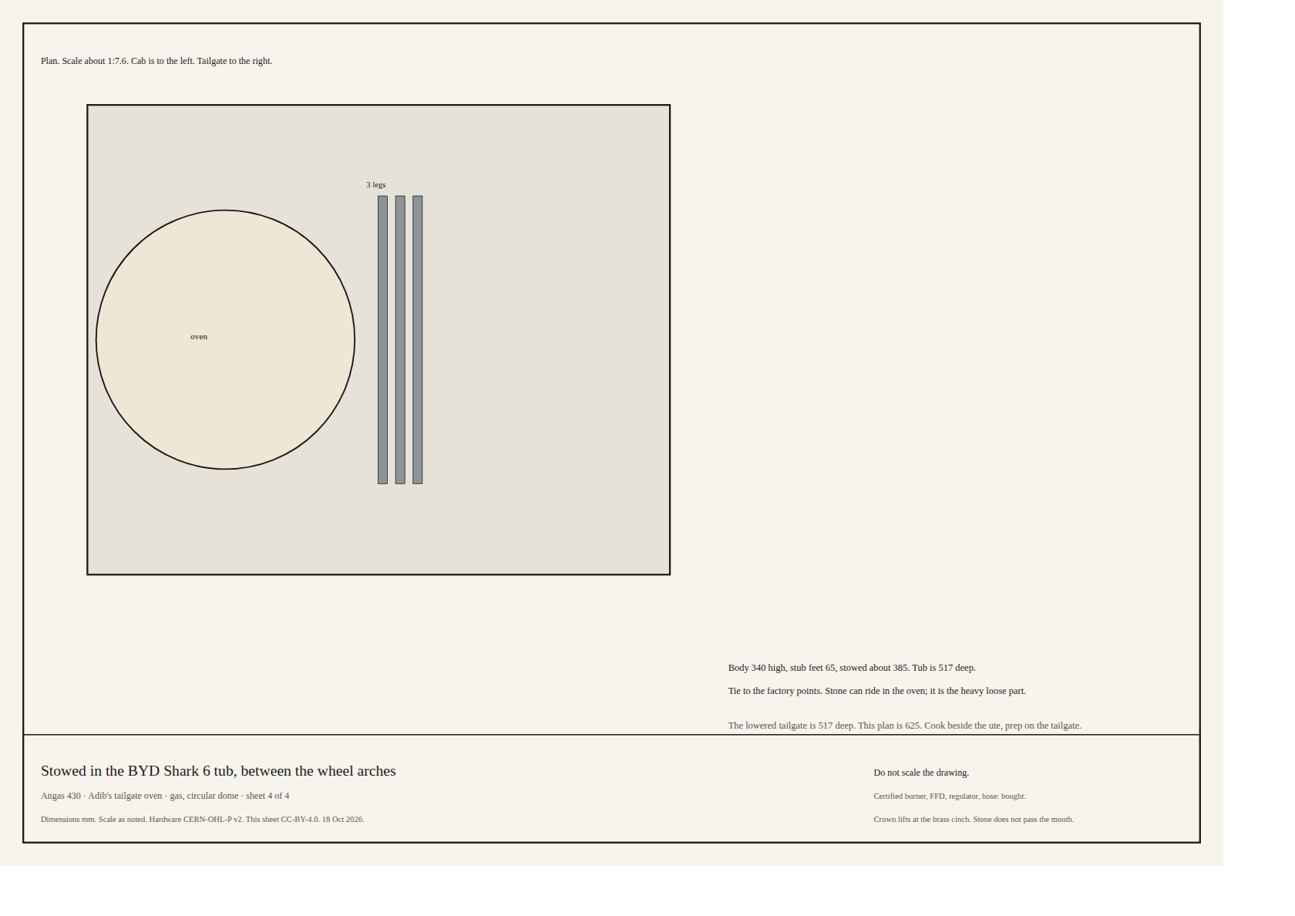
design/tailgate/drawings/ga-stowed.png
