adxb-pxthxn/pizza-oven/design/variants/moondancer/front.png

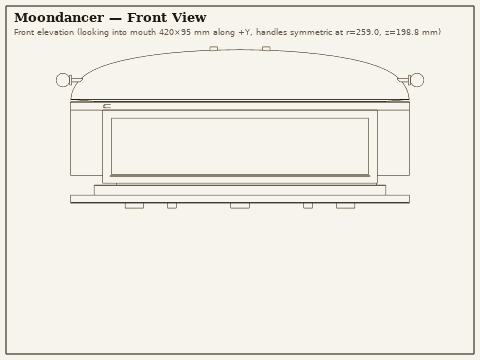
design/variants/moondancer/front.png
