adxb-pxthxn/pizza-oven/design/variants/moondancer/section.png

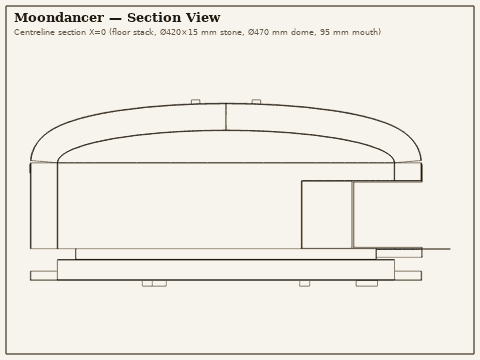
design/variants/moondancer/section.png
