adxb-pxthxn/pizza-oven/design/variants/moondancer/side.png

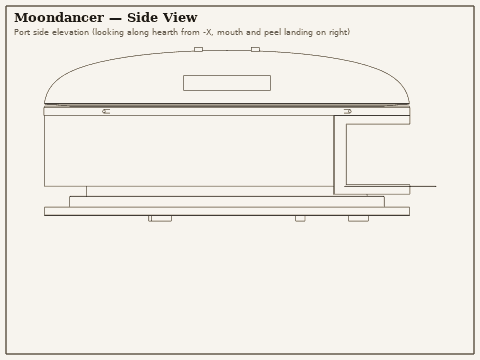
design/variants/moondancer/side.png
