adxb-pxthxn/pizza-oven/design/variants/moondancer/top.png

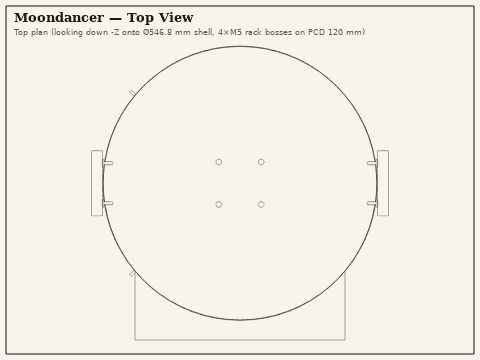
design/variants/moondancer/top.png
