adxb-pxthxn/pizza-oven/design/variants/morning/front.png

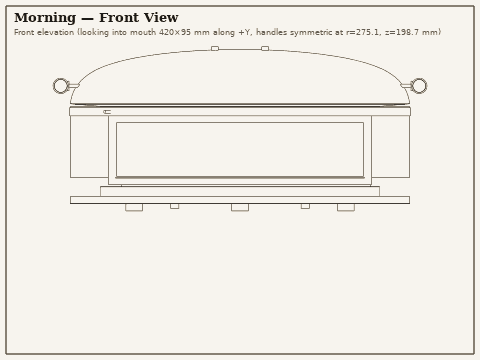
design/variants/morning/front.png
