adxb-pxthxn/pizza-oven/design/variants/morning/section.png

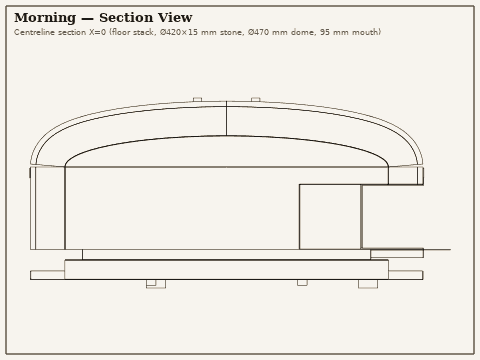
design/variants/morning/section.png
