adxb-pxthxn/pizza-oven/design/variants/morning/side.png

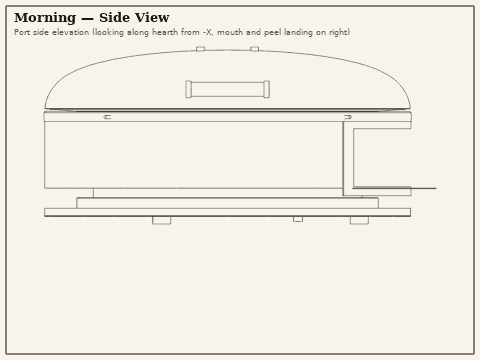
design/variants/morning/side.png
