adxb-pxthxn/pizza-oven/bom/bom.csv

Part Number | Component Name | Material / Spec | Qty | Category | Vendor / Standard Reference | Estimated Unit Cost (USD) | Currency | Sourcing Notes
TG-100 | Certified oven burner assembly | Bought 5.5–6.5 kW LPG burner with factory injector, thermocouple, piezo, flame-failure valve | 1 | Gas / Certified | AS/NZS gas appliance spare or commercial salamander pull | 95 | AUD | ESTIMATE AUD Adelaide Oct 2026. The column header says USD because the BOM schema requires that name. These figures are Australian dollars. Do not convert. Bought certified. Do not drill a jet. Do not delete the flame-failure valve.
TG-101 | LCC27 regulator | 2.75 kPa LPG regulator | 1 | Gas / Certified | LCC27 | 40 | AUD | ESTIMATE AUD. Bought new. Not fabricated.
TG-102 | Appliance hose | AS/NZS 1869 hose | 1 | Gas / Certified | AS/NZS 1869 | 25 | AUD | ESTIMATE AUD. Bought new. Class is whatever the certified assembly calls for. Do not invent a class.
TG-110 | Cooking floor | Cordierite kiln shelf trimmed to Ø430 × 20 mm | 1 | Refractory | Pottery supply or second-hand kiln shelf | 45 | AUD | ESTIMATE AUD. Trim on the WorkBee with a diamond wheel and an MDF jig. Does not pass the mouth. Enters from above when the crown is off.
TG-120 | AES blanket | Alkaline earth silicate blanket 25 mm layers | 1 | Insulation | Trade offcut or industrial insulation supplier | 110 | AUD | ESTIMATE AUD. Crown uses 100 mm. Wall uses 75 mm. Floor uses 25 mm. Knife from MDF templates. Trotec or Thunder laser cuts the templates only, not the blanket.
TG-121 | Calcium silicate board | 25 mm insulating board | 1 | Insulation | Industrial insulation offcut | 40 | AUD | ESTIMATE AUD. Wall backing and the floor disc. Bevel the wall staves on the table saw. Trim the disc on the WorkBee.
TG-200 | 304 stainless sheet | 1.2 mm skin and liner, 1.5 mm base pan and peel landing | 1 | Metal | Sheet drop or metal merchant | 110 | AUD | ESTIMATE AUD. Covers every fabricated steel sheet part below. University workshop: slip roll and TIG. Makerspace does not publish a roll, a brake, or a fibre laser.
TG-201 | Tripod tubes | 304 tube Ø25.4 × 1.6 × 750 mm | 3 | Metal | Metal merchant | 8 | AUD | ESTIMATE AUD about 8 each | 24 for the set of three. Cold saw at the makerspace. Optional if the camp table is the usual stand.
TG-210 | Brass cinch and ferrules | C26000 flat 35 × 3 mm and round bar for ferrules | 1 | Metal | Metal merchant | 45 | AUD | ESTIMATE AUD. Band rolled at the university shop. Ferrules and the badge on the makerspace metal lathe. Two Ø5 dowels are the road lock.
TG-220 | Jarrah handles and stub feet | Quarter-sawn jarrah, handles Ø32 × 220, three feet 65 mm | 1 | Timber | Second-hand or the shed | 15 | AUD | ESTIMATE AUD. Blanks on the table saw and thicknesser. Turn on the metal lathe. Tung oil. Wood is only at the hands and the feet.
TG-230 | Stainless fasteners | A2 or A4 machine screws | 1 | Hardware | Fastener merchant | 20 | AUD | ESTIMATE AUD. No zinc and no galvanised hardware in the hot path.
TG-300 | Shop consumables | Argon share, 308L filler, abrasive, MDF bucks | 1 | Consumable | Makerspace and university shop | 40 | AUD | ESTIMATE AUD.
TG-401 | Base pan | 304 × 1.5 mm disc | 1 | Fabricated | University workshop | 0 | AUD | Material in TG-200. The pan is the heavy steel part | about 4.2 kg in the model.
TG-402 | Inner liner skirt and dome | 304 × 1.2 mm | 1 | Fabricated | University workshop slip roll and TIG | 0 | AUD | Material in TG-200. Mouth tunnel slips. Do not weld the liner hard to the outer crown.
TG-403 | Outer skirt | 304 × 1.2 mm cylinder | 1 | Fabricated | University workshop slip roll and TIG | 0 | AUD | Material in TG-200.
TG-404 | Outer crown | 304 × 1.2 mm dome | 1 | Fabricated | University workshop gore roll or dish and TIG | 0 | AUD | Material in TG-200. Lifts off the joggle with the blanket.
TG-405 | Mouth frame and peel landing | 304 frame and 420 × 45 mm sill | 1 | Fabricated | University workshop | 0 | AUD | Material in TG-200. Landing mass in the model is 0.22 kg.
TG-406 | Cinch band | Brass 35 × 3 mm | 1 | Fabricated | University roll and makerspace lathe for the bolt ears | 0 | AUD | Material in TG-210.
TG-407 | Handles | Jarrah with brass ferrules | 2 | Fabricated | Makerspace metal lathe | 0 | AUD | Material in TG-220 and TG-210. Leave the timber free to move. Do not clamp it solid between metal faces.
TG-408 | Stub feet | Jarrah | 3 | Fabricated | Makerspace metal lathe | 0 | AUD | Material in TG-220. Camp-table stance.
TG-409 | Badge | Brass plate | 1 | Fabricated | Makerspace metal lathe and a laser etch mask | 0 | AUD | Material in TG-210. The CO2 lasers engrave a mask or a thin plate. They do not cut the stainless.
MR-100 | Morning microporous board | k 0.030 W/mK, 250 kg/m3, wall and crown 42.3 mm, floor 27.7 mm | 1 | Insulation | Industrial microporous panel | 180 | AUD | ESTIMATE AUD Adelaide Oct 2026. Morning only. Replaces the Angas AES and calcium silicate. Templates on the CO2 laser, trim on the WorkBee.
MR-110 | Morning cooking floor | Cordierite Ø420 × 15 mm | 1 | Refractory | Pottery supply or second-hand kiln shelf | 40 | AUD | ESTIMATE AUD. 15 mm is the thin end of a soak. Does not pass the mouth. Crown off to load it.
MR-200 | Morning liner and base | 304, liner and pan 0.6 mm, base 0.8 mm | 1 | Metal | Sheet drop | 90 | AUD | ESTIMATE AUD. University workshop TIG. Makerspace has no roll.
MR-210 | Morning wood shell | Blackwood segmented stave 8 mm | 1 | Timber | Adelaide hardwood blank | 80 | AUD | ESTIMATE AUD. Table saw, thicknesser, WorkBee. Not a bowl turning. Outer face 50°C, inner face 65°C.
MR-220 | Morning brass cinch | C26000 14 × 1.2 mm plus ferrules | 1 | Metal | Metal merchant | 35 | AUD | ESTIMATE AUD. Ferrules on the makerspace lathe. Band closed at the university shop.
MR-230 | Morning handles and feet | Jarrah grips Ø22 × 130, three 12 mm feet, PTFE washers | 1 | Timber | Offcut | 15 | AUD | ESTIMATE AUD. High on the dome shoulder. Grip under 30°C in the mesh.
MR-240 | Morning rack and stand bosses | 4× M5 on PCD 120, 4× M6 on a 220 mm square | 1 | Metal | 304 bar | 0 | AUD | Mass is in the oven. The rack and the stand are not built.
MD-100 | Moondancer microporous board | k 0.030 W/mK, 250 kg/m3, wall and crown 37.0 mm, floor 27.7 mm | 1 | Insulation | Industrial microporous panel | 160 | AUD | ESTIMATE AUD. Moondancer only.
MD-110 | Moondancer cooking floor | Cordierite Ø420 × 15 mm | 1 | Refractory | Pottery supply or second-hand kiln shelf | 40 | AUD | ESTIMATE AUD. Same stone as Morning.
MD-200 | Moondancer liner | 304 liner and stone pan 0.6 mm | 1 | Metal | Sheet drop | 60 | AUD | ESTIMATE AUD. University workshop TIG. Food-side metal stays stainless.
MD-210 | Moondancer shell | Aluminium skin 0.8 mm and base 0.9 mm | 1 | Metal | Sheet drop | 40 | AUD | ESTIMATE AUD. Skin 55°C, so the alloy is nowhere near soft. Not the food-side liner.
MD-220 | Moondancer cinch | 304 band 12 × 0.8 mm | 1 | Metal | Sheet drop | 0 | AUD | Material in MD-200. Crown lifts here.
MD-230 | Moondancer handles | Jarrah grips on stainless posts and PTFE | 1 | Timber | Offcut | 15 | AUD | ESTIMATE AUD. Same placement as Morning. No brass ferrules.
MD-240 | Moondancer rack and stand bosses | 4× M5 on PCD 120, 4× M6 on a 220 mm square | 1 | Metal | 304 bar | 0 | AUD | Interfaces only. Accessory mass is not included.
ST-100 | Stormcloud ceramic fibre | 25 mm blanket, 3 layers on the arch, 2 under the floor | 1 | Insulation | Kiln offcut or Gumtree | 40 | AUD | ESTIMATE AUD Adelaide Oct 2026. k 0.075. Not microporous. Templates on the CO2 laser, knife on the bench.
ST-110 | Stormcloud pizza steel | AS/NZS 3678-250 normalised 450 × 500 × 6 mm | 1 | Metal | Plate offcut or merchant | 55 | AUD | ESTIMATE AUD. Free on six domed buttons. 25 mm side gap. Seasoned. No zinc, no paint, no cordierite.
ST-120 | Stormcloud liner and hot stainless | 304 × 0.8 mm liner, 1.2 mm sky plate, door tray, burner box, hood | 1 | Metal | Sheet drop | 90 | AUD | ESTIMATE AUD. University slip roll and TIG. Single curvature. Food-side chamber metal is 304.
ST-130 | Stormcloud aluminium skin | 1.0 mm skin and base, 8 mm air gap | 1 | Metal | Sheet drop | 45 | AUD | ESTIMATE AUD. Cladding | not the food surface. Air gap is the thermal break. Skin about 55 C at a 500 C broil.
ST-140 | Stormcloud jarrah | Grips, peel rest, door pull | 1 | Timber | Marketplace hardwood offcut | 20 | AUD | ESTIMATE AUD. Cool zone only. Stood off on stainless posts and PTFE. Makerspace lathe or spindle.
ST-150 | Stormcloud gidgee ferrules | Four turned rings | 1 | Timber | Offcut | 8 | AUD | ESTIMATE AUD. Press fit on the grip ends. The only press fit.
ST-160 | Stormcloud fasteners and feet | A2 screws, PTFE washers, four rubber feet | 1 | Hardware | Fastener merchant | 18 | AUD | ESTIMATE AUD. No galvanised hardware in the hot path.
ST-170 | Stormcloud interfaces | 4× M5 rack bosses, 4× M6 stand bosses, removable broil rack | 1 | Metal | 304 bar and wire | 0 | AUD | Boss mass is in the oven. The rack and the stand are not | except the broil rack wires.
ST-180 | Arrax floor and launch | 480 × 500 × 6 plate, 400 × 90 × 1.2 sill, four stops at a 4 mm gap | 1 | Metal | Plate offcut | 15 | AUD | ESTIMATE AUD extra over ST-110. Stops stay below the deck. Sill does not touch the plate.
ST-190 | Vermithor floor blanket | Third 25 mm ceramic-fibre layer under the whole steel | 1 | Insulation | Same offcut as ST-100 | 12 | AUD | ESTIMATE AUD. 75 mm total. A step would tilt the plate. Bay underside about 56 C.
ST-200 | Sheepstealer skin blank | 1.0 mm aluminium half-barrel development, two half-ring ends, 4 mm K-type gland | 1 | Metal | Laser-cut sheet drop | 8 | AUD | ESTIMATE AUD. Arc 1050 mm at mid thickness. Rivets at 40 mm. Fascia stops 2 mm clear of the liner. Gland does not pierce the fibre.
ST-210 | Silverwing door hinge | 8 mm pin, two 2 mm straps, post lapped 40 × 25 mm onto the floor | 1 | Metal | 304 bar and sheet | 6 | AUD | ESTIMATE AUD. Clearance fit. Grey Ghost weld is 2173 mm3. Door stays mouth-sized.
VX-100 | Vermax microporous board | k 0.030 W/mK, 250 kg/m3. Hood 26.4 mm, hearth 18 mm, belly 22 mm, door 16 mm | 1 | Insulation | Industrial microporous panel or kiln offcut | 190 | AUD | ESTIMATE AUD Adelaide Oct 2026. Vermax only. Templates on the CO2 laser. Trim on the WorkBee. Second-hand ceramic fibre needs about 80 mm to match this skin temperature and is heavier.
VX-110 | Vermax cooking floor | Mild steel plate 440 × 520 × 4 mm, normalised, uncoated | 1 | Metal | Plate offcut | 55 | AUD | ESTIMATE AUD. Floating on three pads. Not bolted. No cordierite. Season with oil. Do not galvanise.
VX-120 | Vermax pit and liner | Mild steel. Pit 1.0 mm, liner 0.6 mm, soffit 1.2 mm | 1 | Metal | Sheet drop | 80 | AUD | ESTIMATE AUD. University workshop TIG or a brake. Firebox walls are bare and hot. No zinc.
VX-130 | Vermax skin and belly | Aluminium 0.6 mm skin, 0.8 mm belly tray | 1 | Metal | Sheet drop | 40 | AUD | ESTIMATE AUD. Cladding on the steel frame with a 12.4 mm air gap. Not a food surface. Skin 54°C.
VX-140 | Vermax grips feet and peel rest | Jarrah grips and four feet. Gidgee peel rest 180 × 20 × 16 | 1 | Timber | Second-hand hardwood | 30 | AUD | ESTIMATE AUD. Wood is only here. Stainless ferrules are a 0.15 mm radial press. Posts stand off the firebox wall.
VX-150 | Vermax door flue rack and latches | Mild door inner, stainless rack, mild flue and two latches | 1 | Metal | Sheet and rod offcut | 25 | AUD | ESTIMATE AUD. Door insulation is in VX-100. Hinge pin is a slip fit.
VX-160 | Vermax burner | Same bought burner as TG-100 | 1 | Gas / Certified | See TG-100 | 0 | AUD | Not a second burner. Counted in the pit module at 1.85 kg. Do not drill a jet.
AX-100 | Arrax microporous board | k 0.030 W/mK, 250 kg/m3. Hood 22 mm, hearth 12 mm, belly 12 mm, door 16 mm | 1 | Insulation | Industrial microporous panel or kiln offcut | 150 | AUD | ESTIMATE AUD Adelaide Oct 2026. Arrax only. Air gap 16 mm carries the rest of the wall resistance.
AX-110 | Arrax cooking floor | Mild steel plate 440 × 520 × 4 mm, normalised, uncoated | 1 | Metal | Plate offcut | 55 | AUD | ESTIMATE AUD. Same floating plate as Vermax. No cordierite.
AX-120 | Arrax pit liner and grate | Mild pit 1.0 mm and liner 0.6 mm. Stainless grate under the hearth | 1 | Metal | Sheet and rod offcut | 85 | AUD | ESTIMATE AUD. Lift the hearth off and the grate is the fire pit. No zinc.
AX-130 | Arrax skin | Aluminium 0.6 mm over a 16 mm air gap | 1 | Metal | Sheet drop | 35 | AUD | ESTIMATE AUD. Brow over the launch | low body over the soffit. Skin 55°C.
AX-140 | Arrax wood | Jarrah grips and feet. Gidgee peel rest | 1 | Timber | Second-hand hardwood | 30 | AUD | ESTIMATE AUD. Wood stays in the cool zone. Ferrules are the only press fits.
SX-100 | Shrykos cowl | Same sheet as Arrax. The step is one 45° brake fold, not a square corner | 1 | Metal | Sheet drop | 0 | AUD | ESTIMATE AUD. Material is in the Arrax rows. University folder or press brake. Insulation is cut to the same angle.
MG-100 | Morghul joint | 2 mm gap at the fold. 4× M6 stainless bolts and nuts, not drawn | 1 | Fastener | Workshop bin | 4 | AUD | ESTIMATE AUD. Brow and tunnel are separate solids. Clearance holes | not a press fit.
SS-100 | Seasmoke seat and grill | 1.5 mm mild foot and shelf at the fold. Upper stainless grate rails. Jarrah brow grip | 1 | Metal | Sheet and rod offcut | 8 | AUD | ESTIMATE AUD. 0.6 mm clearance | not a press. Liner gap stays 2 mm. Etch inside the brow: 300 is the deck. 550 is the ceiling.
CX-100 | Caraxes broiler plate | Mild plate 1.2 mm at Z 100, behind the pizza. Two stainless posts. Rack 50 mm under the plate | 1 | Metal | Sheet and rod offcut | 12 | AUD | ESTIMATE AUD. Roof soffit stays at 150 mm. The plate is the steak ceiling. No cordierite.
ML-100 | Meleys hearth bail | Jarrah grip, two stainless posts 36 mm, PTFE washers, ferrule press 0.15 mm radial | 1 | Timber | Second-hand jarrah | 12 | AUD | ESTIMATE AUD. Cool zone | in front of the sill. The hearth lifts by this | not by the hot rail.
SR-100 | Syrax flue damper | Mild plate across the flue bore, tang out the top | 1 | Metal | Sheet offcut | 4 | AUD | ESTIMATE AUD. Bread pose. Clear of the flue walls. Lift the tang to park it.
SH-100 | Sheepstealer door rope | Ceramic fibre rope, four strips 8 mm by 6 mm, uncompressed in the door gap | 1 | Seal | Workshop bin | 6 | AUD | ESTIMATE AUD. 0.8 mm off the door | 2.2 mm short of the skin. Not a press. Mouth stays open inside the frame.
VM-100 | Vermithor broiler slide | Mild plate at Z 100, two stainless rails 10 by 16 mm, rear posts, front and rear stops, tang | 1 | Metal | Sheet and flat offcut | 18 | AUD | ESTIMATE AUD. Steak pose Y 180 to 350. Pizza park Y 468 to 638. 0.6 mm under the rails | not a press. Rack travels with the plate.
SW-100 | Silverwing broiler rods | Same plate and stops. Rails are 8 mm stainless rod. Posts butt the rods | 1 | Metal | Rod offcut | 8 | AUD | ESTIMATE AUD. Replaces VM-100 rails. 0.6 mm under the rods. The butt is not a press.
VH-100 | Vhagar wind-back | Mild plate 360 by 100 by 1.2 mm, two shelves on the rear pit wall | 1 | Metal | Sheet offcut | 6 | AUD | ESTIMATE AUD. Stored under the rear overhang | 0.6 mm above the shelves. Stand it on the rim when the hood is off.
BA-100 | Balerion brow panels | Two jarrah panels 110 by 130 by 6 mm, stood off the brow skin on stainless posts and PTFE washers | 1 | Timber | Second-hand jarrah | 14 | AUD | ESTIMATE AUD. 8 mm air. Washer butts the wood | post butts the skin. Not a press. Panel face 21°C on a 55°C skin.
MX-100 | Meraxes door | 24 mm air gap in the door, jarrah grip, two stainless posts, PTFE washers, ferrule press 0.15 mm radial | 1 | Assembly | Second-hand jarrah | 16 | AUD | ESTIMATE AUD. Door face 53.7°C. Grip 23°C at 18 mm. Without the air the face is near 90°C.
DF-100 | Dreamfyre pintle | Stainless pin 7.2 mm, two barrels, mild leaves and arms, straps and ears. Bolted to the port aluminium skin | 1 | Metal | Second-hand mild and stainless | 12 | AUD | ESTIMATE AUD. 0.6 mm radial clearance. Barrel 0.4 mm above the arm and 0.8 mm under the head. Not a weld to the aluminium. Door stops on the arms at about 127°.
CN-100 | Cannibal door ties | Four stainless spacers, 5 mm diameter, 40 mm long, in the door border | 1 | Metal | Rod offcut | 4 | AUD | ESTIMATE AUD. Each end butts a sheet. The board steps in 8 mm. Corner clearance 3.2 mm. Not a press.
QS-100 | Quicksilver pintle | Mild arm welded to the pit wall, stainless pin and collar, brow barrel above the door | 1 | Metal | Second-hand mild and stainless | 14 | AUD | ESTIMATE AUD. Arms sit outside the door. Pin radial clearance 0.6 mm. The brow lifts off the pin. The leaf bolts to the aluminium.
UR-100 | Urrax hood pads | Two mild pads, 100 by 20 by 1.5 mm, one each side of the tunnel skin | 1 | Metal | Second-hand mild | 6 | AUD | ESTIMATE AUD. Posts stand on the outer pad. Closest edge 7.5 mm. The skin is between the pads. Not a press.
TR-100 | Terrax brow pads | Two mild pads, 100 by 20 by 1.5 mm, one each side of the brow skin | 1 | Metal | Second-hand mild | 6 | AUD | ESTIMATE AUD. Same pad as the tunnel grip. Posts clear the skin by 1.5 mm. Not a press.
TR-110 | Terrax door pads | Two mild pads, 100 by 20 by 1.5 mm, one each side of the door skin | 1 | Metal | Second-hand mild | 6 | AUD | ESTIMATE AUD. The door grip stands on the outer pad. Inner pad sits in the door air gap. Rivet the stack. Not a press.
SN-100 | Bench spindle rails | 40×40×3 mild SHS, 600 mm | 2 | Metal | Metal merchant | 12 | AUD | ESTIMATE AUD Oct 2026. Cold cut saw. Two rails. No galvanised.
SN-110 | Bench spindle bridge and sleepers | 6 mm mild plate | 1 | Metal | Sheet offcut | 8 | AUD | ESTIMATE AUD. Bolt the pillow blocks to the bridge. Do not bore a housing.
SN-120 | Pillow block | UCP204 20 mm bore | 2 | Bearing | Bearing merchant | 18 | AUD | ESTIMATE AUD. Catalogue centre height 33.3 mm. Not a measured housing.
SN-130 | Spindle shaft | Bright mild Ø20 × 280 mm | 1 | Metal | Metal merchant | 8 | AUD | ESTIMATE AUD. Turn the seats and the chuck nose on the makerspace lathe.
SN-140 | Spindle and motor pulleys | 6 mm mild, Ø100 and Ø50 | 1 | Metal | Sheet offcut | 6 | AUD | ESTIMATE AUD. 2:1. Shaft ceiling 2450 rpm with the class motor. Bore to the shafts.
SN-150 | Sanding disc | 6 mm mild Ø120 | 1 | Metal | Sheet offcut | 4 | AUD | ESTIMATE AUD. Outboard of the Ø100 pulley. Pin or bolt. Jarrah and aluminium. Not a 2×72 belt.
SN-160 | Jarrah handwheel and feet | Jarrah offcut | 1 | Timber | Second-hand jarrah | 12 | AUD | ESTIMATE AUD. Wood at the hand and the feet. Not bonded to steel.
SN-170 | Aluminium guard | 1.0 mm aluminium sheet | 1 | Metal | Sheet offcut | 6 | AUD | ESTIMATE AUD. Lifts off. Engrave 2450 only after the pulleys are fitted. Do not weld it to the mild.
SN-180 | Bed fasteners | M10 plain or stainless, one Torx family | 1 | Hardware | Fastener merchant | 14 | AUD | ESTIMATE AUD. No zinc. No galvanised.
SN-190 | Drill chuck | 13 mm | 1 | Tooling | Shop chuck or tool merchant | 22 | AUD | ESTIMATE AUD. Day-one nose. Pins and the Ø8.4 drill. A Ø22 grip stays on the makerspace lathe.
SN-200 | Open belt | Pitch about 575 mm at 168 mm centres | 1 | Belt | Bearing or belting merchant | 12 | AUD | ESTIMATE AUD. Optional on day one. A longer belt means the motor slides back. The disc sands without it.
SN-210 | Donor motor and controller | ProForm Pro 2000 treadmill drive | 1 | Donor | Already in the room | 0 | AUD | Not a purchase. Consumer Reports m204502 is the donor listing. Keep the original controller and safety key. Mains check by someone who already does that work.
SN-220 | Separate motor fan | Small fan on the motor mount | 1 | Electrical | Electronics bin | 15 | AUD | ESTIMATE AUD. The integral fan dies at low speed. Use it under about 500 rpm.
