adxb-pxthxn/pizza-oven/design/stream-1/arrax/arrax.step

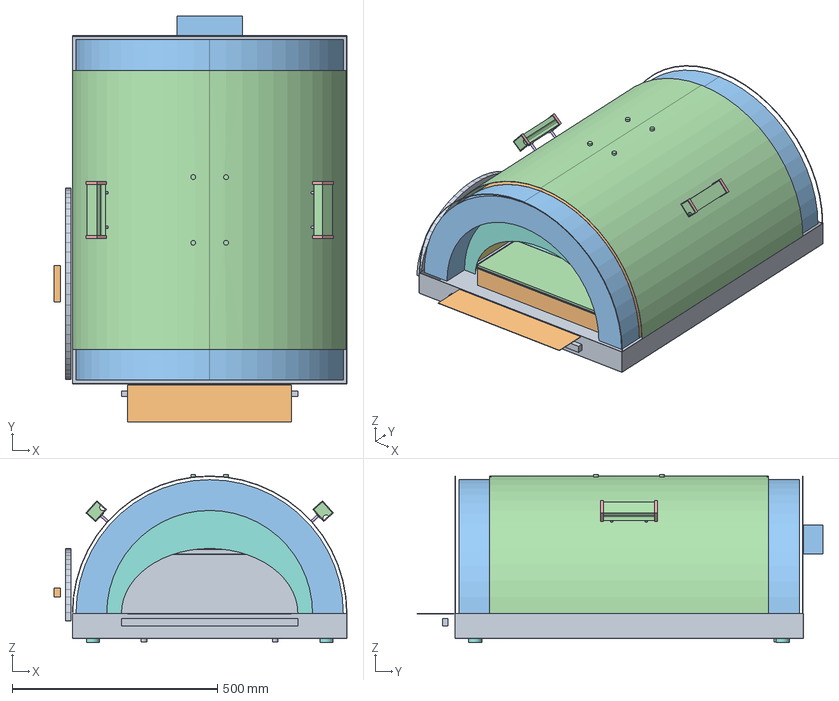
[picture p52: CAD file, 2026-10-18]
design/stream-1/arrax/arrax.step
714.2 x 989.6 x 410.1 mm
