adxb-pxthxn/pizza-oven/design/stream-1/caraxes/caraxes.step

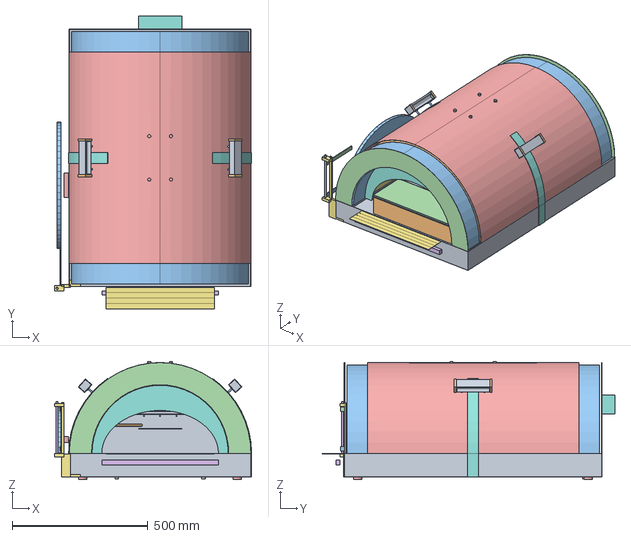
[picture p53: CAD file, 2026-10-18]
design/stream-1/caraxes/caraxes.step
726.8 x 1079.6 x 435.1 mm
