adxb-pxthxn/pizza-oven/design/stream-1/sheepstealer/sheepstealer.step

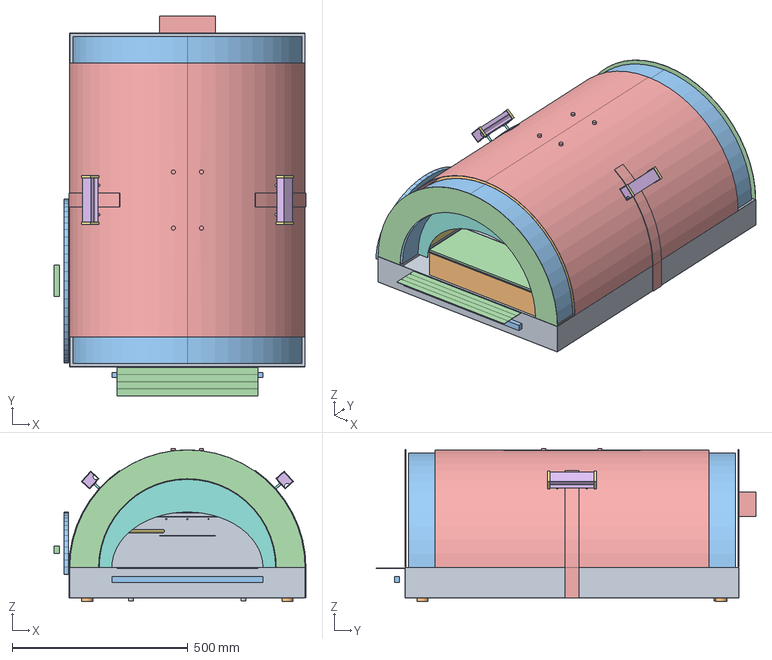
[picture p54: CAD file, 2026-10-18]
design/stream-1/sheepstealer/sheepstealer.step
716.6 x 1079.6 x 435.1 mm
