adxb-pxthxn/pizza-oven/design/stream-1/stormcloud/stormcloud.step

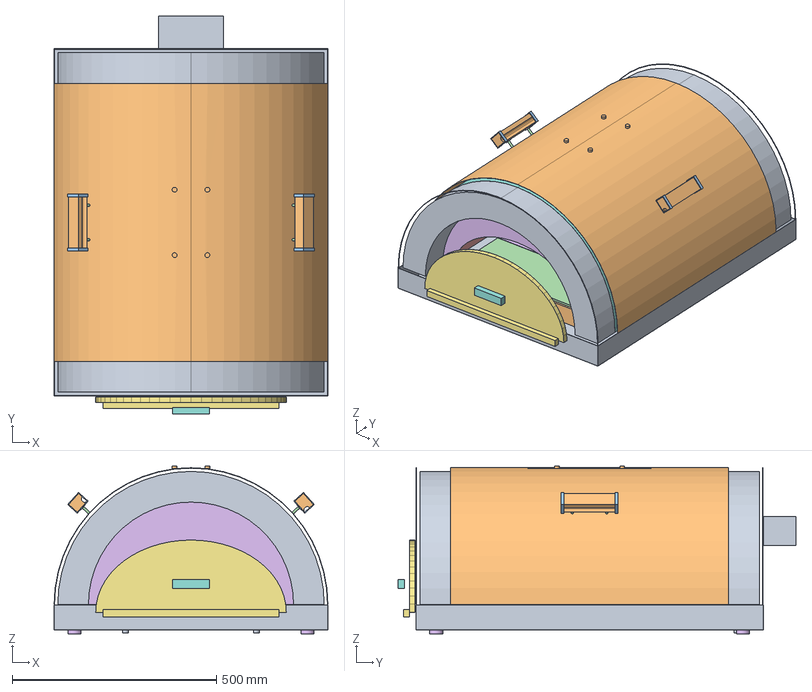
[picture p55: CAD file, 2026-10-18]
design/stream-1/stormcloud/stormcloud.step
669.6 x 973.2 x 410.1 mm
