adxb-pxthxn/pizza-oven/design/stream-1/tessarion/tessarion.step

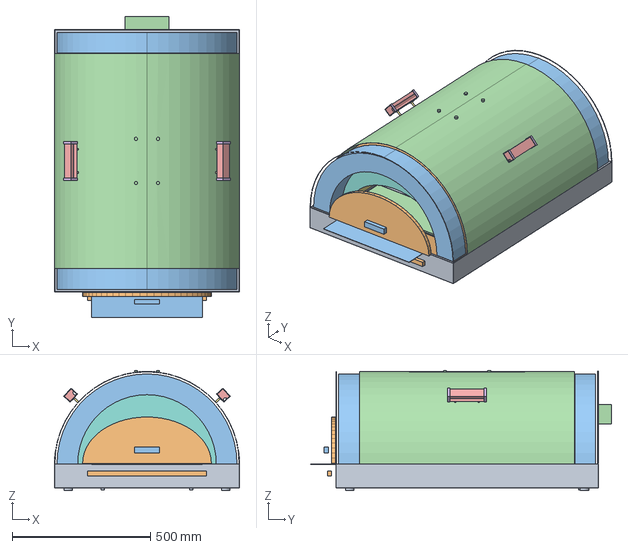
[picture p56: CAD file, 2026-10-18]
design/stream-1/tessarion/tessarion.step
669.6 x 1089.6 x 435.1 mm
