adxb-pxthxn/pizza-oven/design/stream-1/tyraxes/tyraxes.step

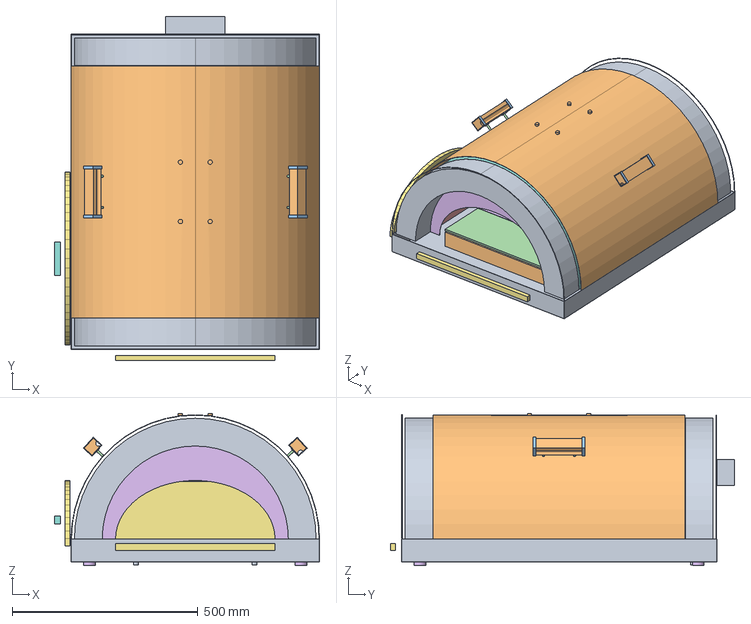
[picture p57: CAD file, 2026-10-18]
design/stream-1/tyraxes/tyraxes.step
714.2 x 927.6 x 410.1 mm
