adxb-pxthxn/pizza-oven/design/stream-1/vermax/vermax.step

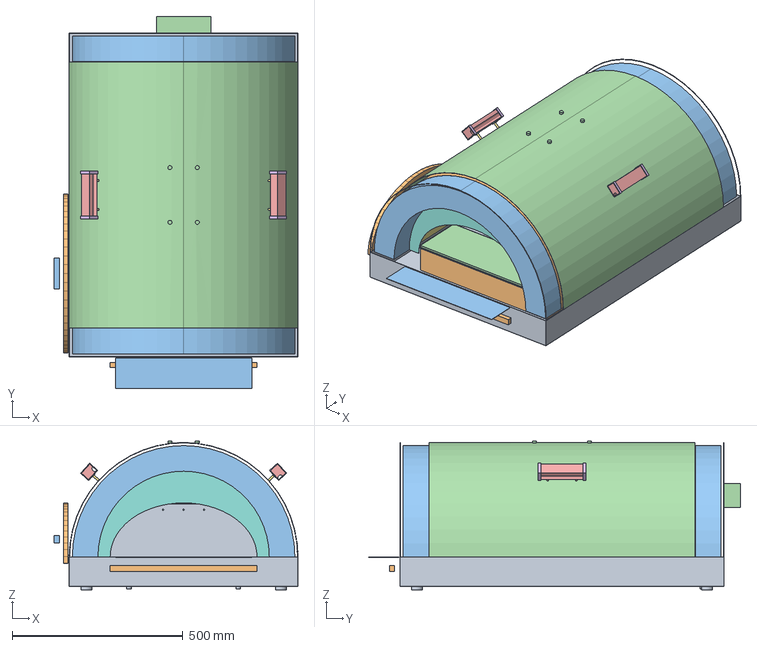
[picture p58: CAD file, 2026-10-18]
design/stream-1/vermax/vermax.step
714.2 x 1089.6 x 435.1 mm
