adxb-pxthxn/pizza-oven/design/stream-2/balerion/balerion.step

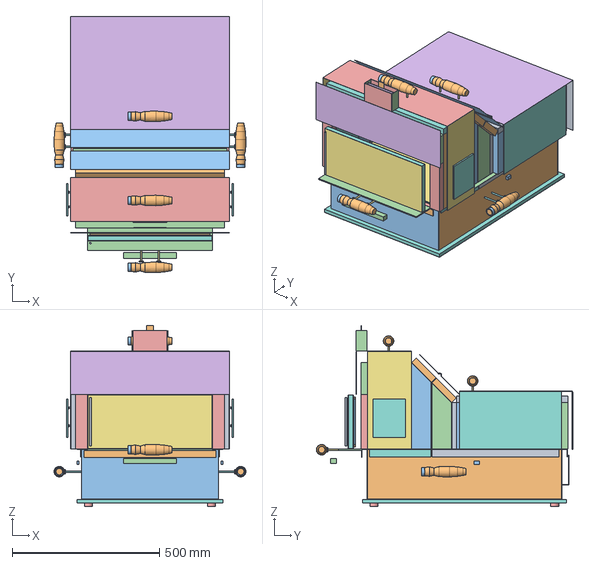
[picture p59: CAD file, 2026-10-18]
design/stream-2/balerion/balerion.step
652.8 x 871.4 x 617.0 mm
