adxb-pxthxn/pizza-oven/design/stream-2/cannibal/cannibal-pit.step

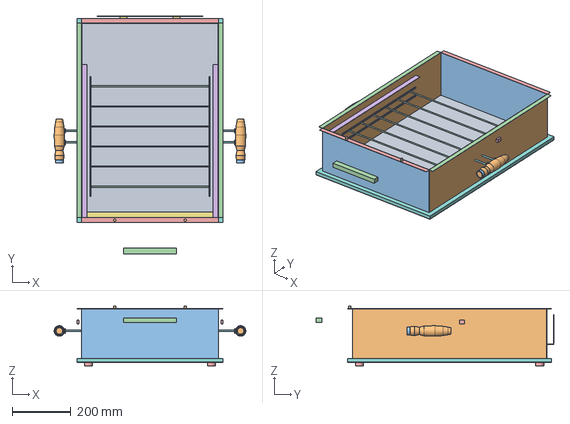
[picture p60: CAD file, 2026-10-18]
design/stream-2/cannibal/cannibal-pit.step
652.8 x 810.2 x 204.2 mm
