adxb-pxthxn/pizza-oven/design/stream-2/morghul/morghul-pit.step

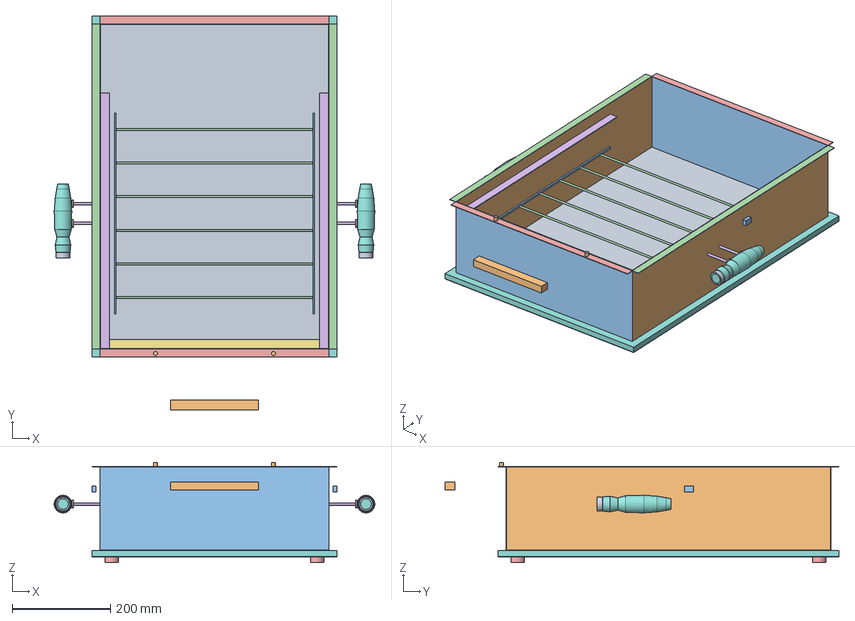
[picture p61: CAD file, 2026-10-18]
design/stream-2/morghul/morghul-pit.step
652.8 x 802.0 x 204.2 mm
