adxb-pxthxn/pizza-oven/design/stream-2/quicksilver/quicksilver-pit.step

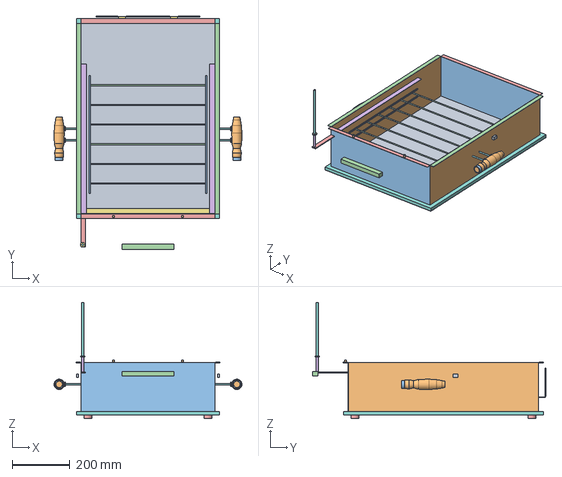
[picture p62: CAD file, 2026-10-18]
design/stream-2/quicksilver/quicksilver-pit.step
652.8 x 810.2 x 404.1 mm
