adxb-pxthxn/pizza-oven/design/stream-2/shrykos/shrykos.step

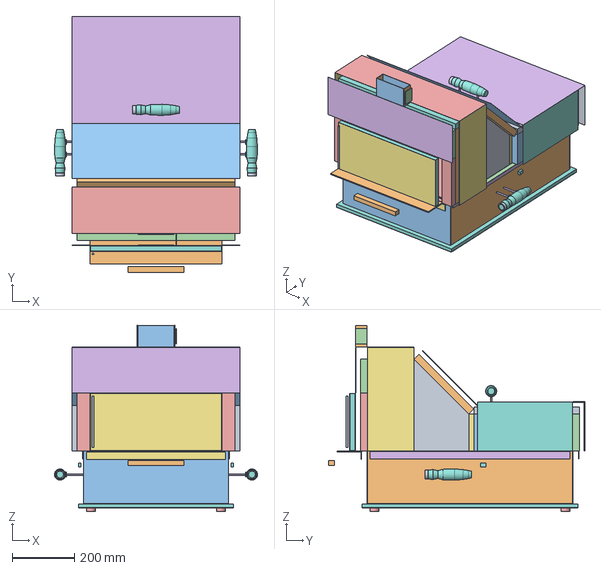
[picture p63: CAD file, 2026-10-18]
design/stream-2/shrykos/shrykos.step
652.8 x 823.0 x 599.0 mm
