adxb-pxthxn/pizza-oven/design/stream-2/vermax/vermax.step

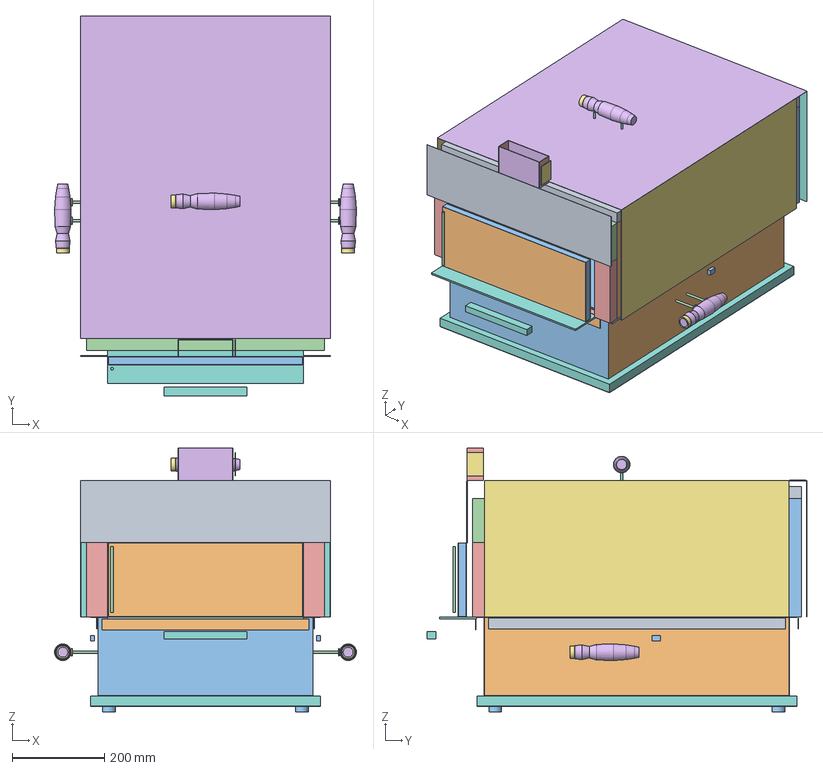
[picture p64: CAD file, 2026-10-18]
design/stream-2/vermax/vermax.step
654.8 x 823.8 x 571.8 mm
