adxb-pxthxn/pizza-oven/design/tailgate/models/angas-430-tripod.step

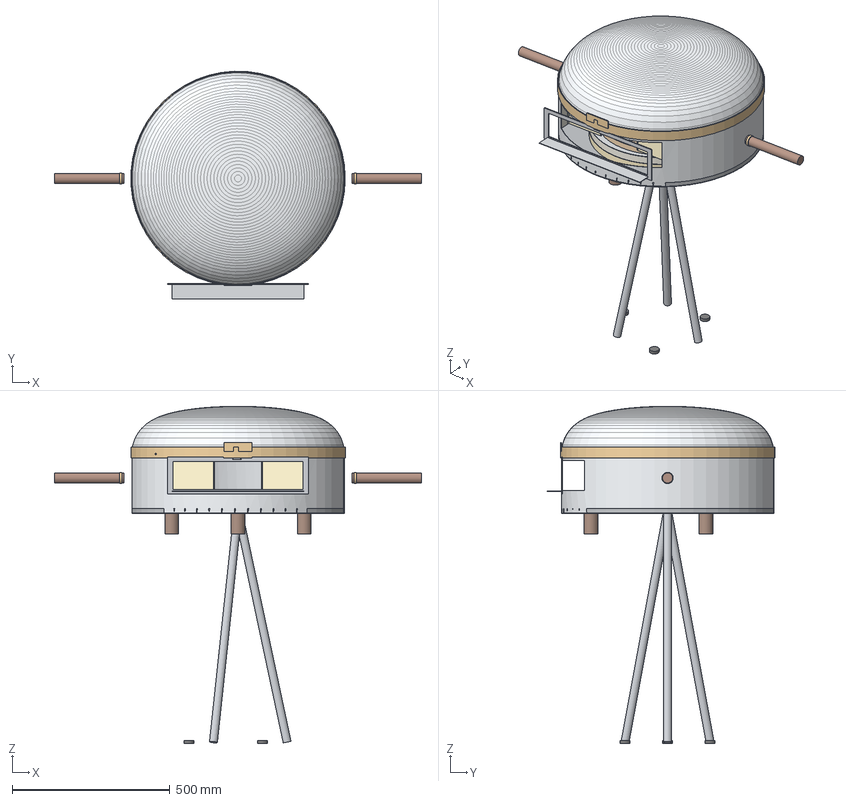
[picture p65: CAD file, 2026-10-18]
design/tailgate/models/angas-430-tripod.step
1164.8 x 722.1 x 1070.7 mm
base-pan
base-lip
floor-aes
floor-casi
stone-pan
floor-cordierite
liner-skirt
wall-aes
wall-casi
shell-skirt
shell-joggle
cinch-band
dowel-a
dowel-b
handle-port
handle-port-ferrule
handle-starboard
handle-starboard-ferrule
burner-certified
mouth-frame
peel-landing
stub-foot x 3
liner-dome
crown-aes
shell-crown
badge
leg x 3
leg-foot x 3
