adxb-pxthxn/pizza-oven/design/variants/moondancer/moondancer.step

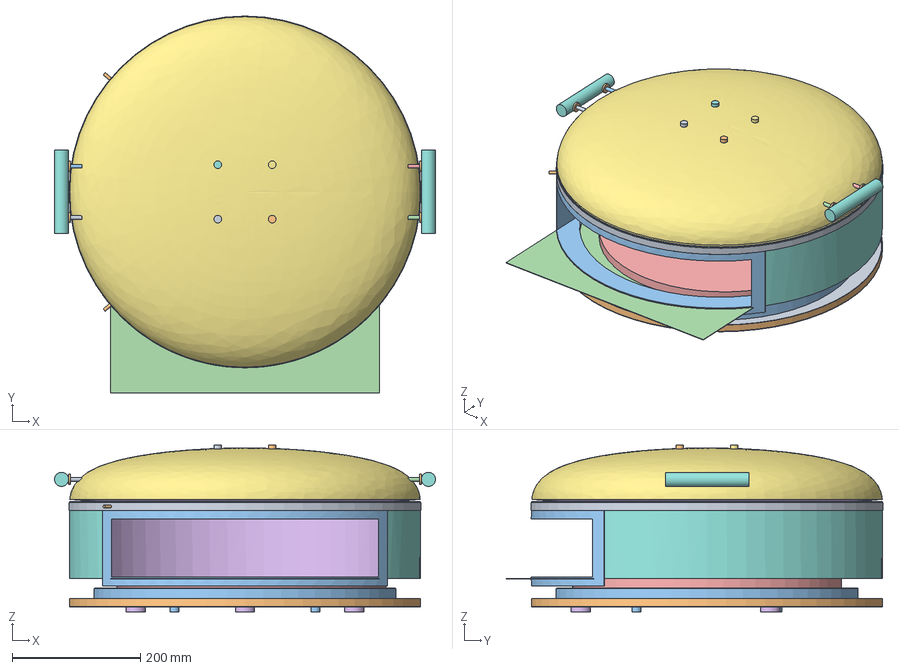
[picture p66: CAD file, 2026-10-18]
design/variants/moondancer/moondancer.step
594.0 x 587.6 x 260.3 mm
