adxb-pxthxn/pizza-oven/design/variants/morning/morning.step

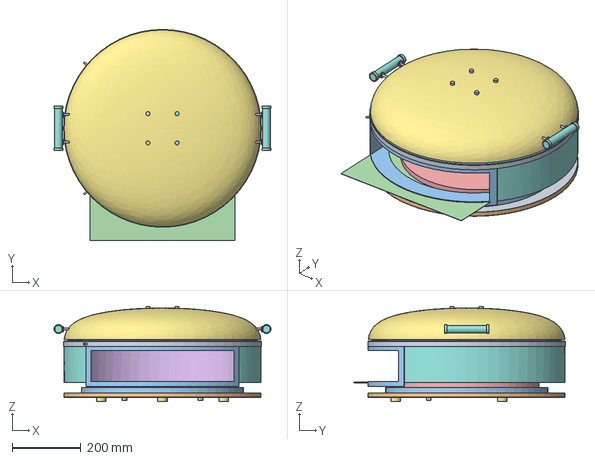
[picture p67: CAD file, 2026-10-18]
design/variants/morning/morning.step
630.1 x 613.0 x 276.7 mm
