adxb-pxthxn/pizza-oven/design/stream-1/caraxes/skin.dxf

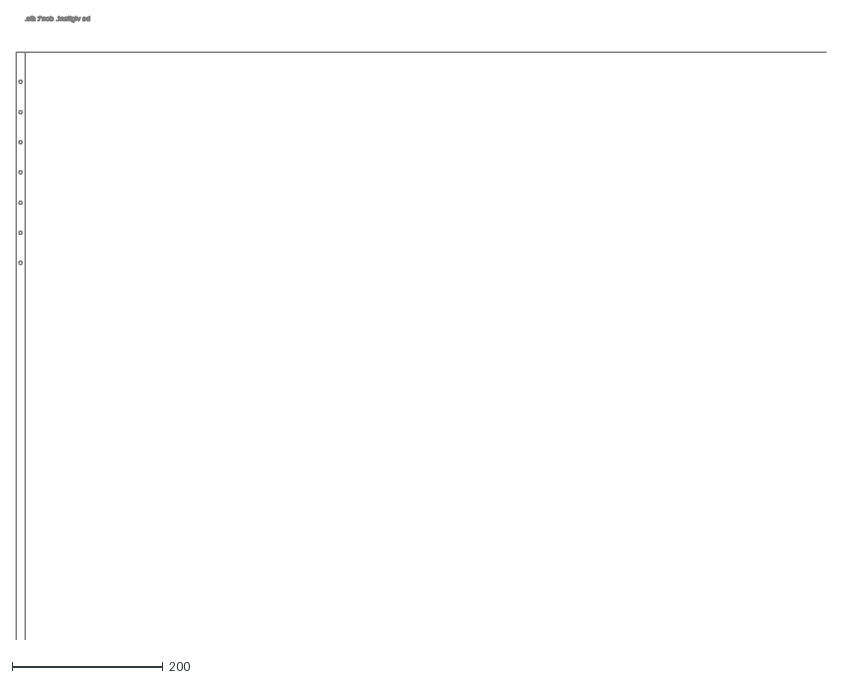
[picture p68: CAD file, 2026-10-18]
design/stream-1/caraxes/skin.dxf
1074.2 x 827.4
