adxb-pxthxn/pizza-oven/design/stream-2/meleys/meleys.step

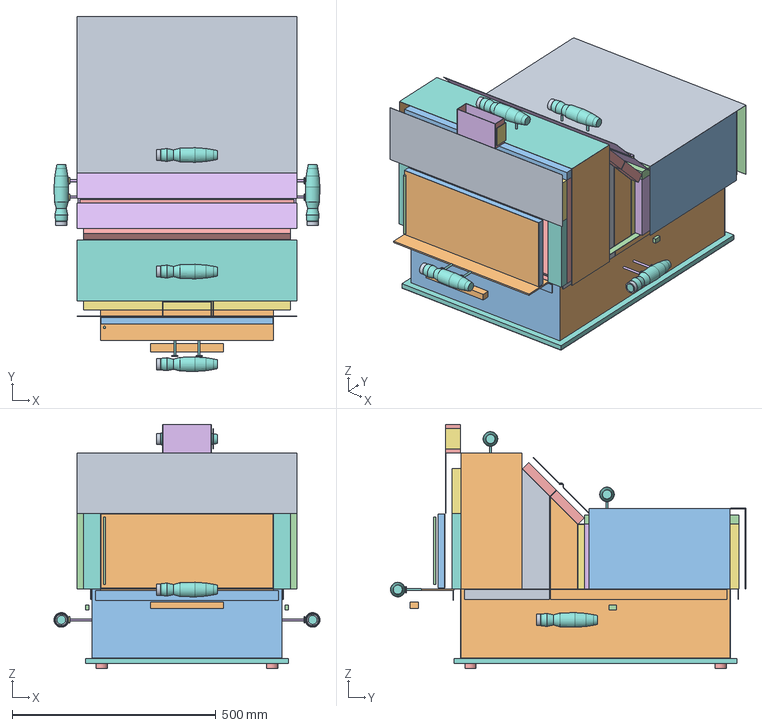
[picture p69: CAD file, 2026-10-18]
design/stream-2/meleys/meleys.step
652.8 x 871.4 x 599.0 mm
