adxb-pxthxn/pizza-oven/design/stream-2/vermax/vermax-pit.step

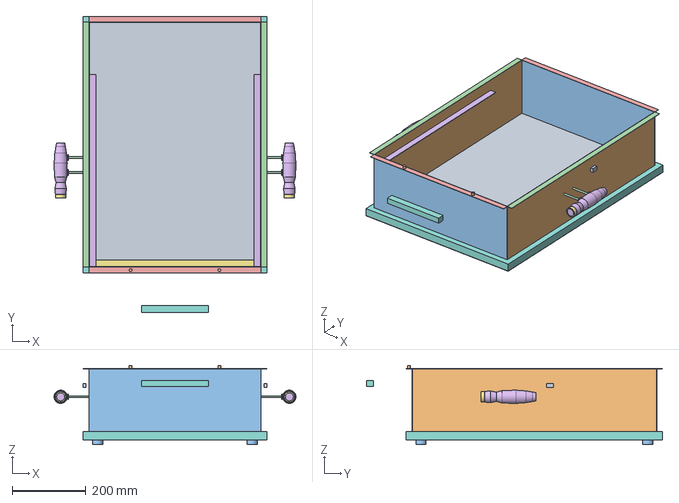
[picture p70: CAD file, 2026-10-18]
design/stream-2/vermax/vermax-pit.step
654.8 x 802.0 x 214.2 mm
