adxb-pxthxn/pizza-oven/design/variants/moondancer/moondancer-exploded.step

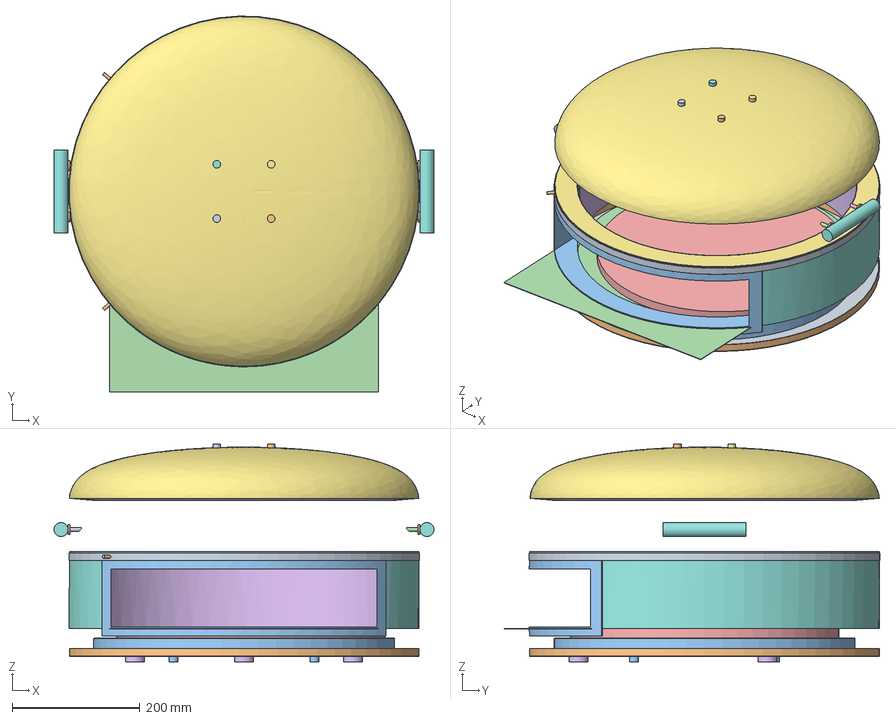
[picture p72: CAD file, 2026-10-18]
design/variants/moondancer/moondancer-exploded.step
594.0 x 587.5 x 340.3 mm
