adxb-pxthxn/pizza-oven/design/variants/morning/morning-exploded.step

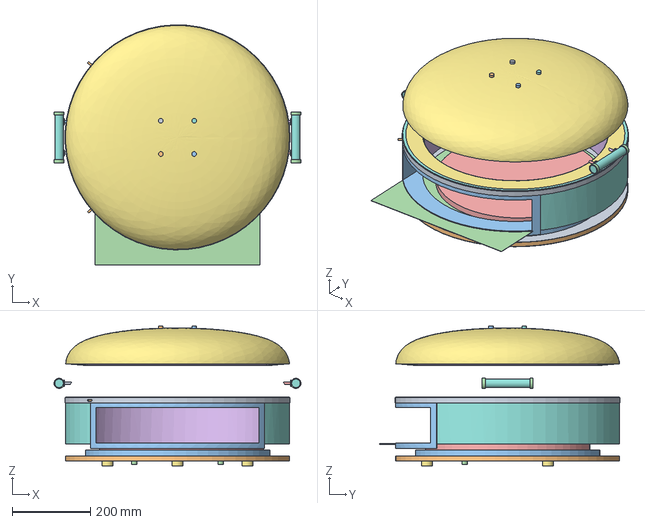
[picture p73: CAD file, 2026-10-18]
design/variants/morning/morning-exploded.step
630.1 x 612.9 x 356.7 mm
