adxb-pxthxn/pizza-oven/design/tailgate/models/angas-430-stowed.step

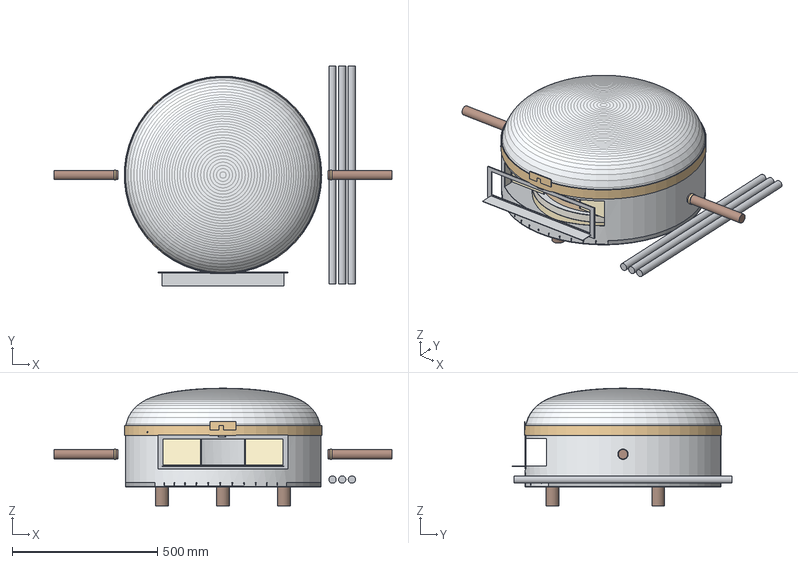
[picture p74: CAD file, 2026-10-18]
design/tailgate/models/angas-430-stowed.step
1164.8 x 756.9 x 405.1 mm
base-pan
base-lip
floor-aes
floor-casi
stone-pan
floor-cordierite
liner-skirt
wall-aes
wall-casi
shell-skirt
shell-joggle
cinch-band
dowel-a
dowel-b
handle-port
handle-port-ferrule
handle-starboard
handle-starboard-ferrule
burner-certified
mouth-frame
peel-landing
stub-foot x 3
liner-dome
crown-aes
shell-crown
badge
leg-stowed-a
leg-stowed-b
leg-stowed-c
