adxb-pxthxn/pizza-oven/design/tailgate/models/angas-430.step

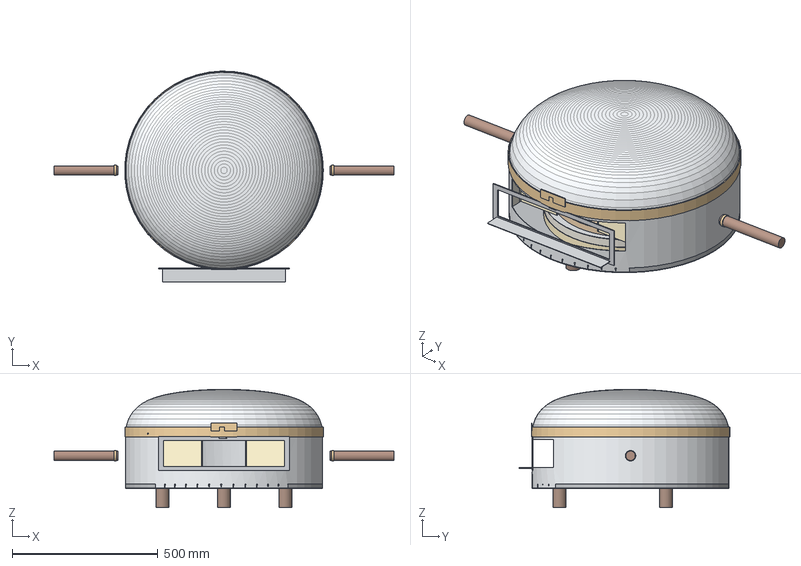
[picture p76: CAD file, 2026-10-18]
design/tailgate/models/angas-430.step
1164.8 x 722.1 x 405.1 mm
base-pan
base-lip
floor-aes
floor-casi
stone-pan
floor-cordierite
liner-skirt
wall-aes
wall-casi
shell-skirt
shell-joggle
cinch-band
dowel-a
dowel-b
handle-port
handle-port-ferrule
handle-starboard
handle-starboard-ferrule
burner-certified
mouth-frame
peel-landing
stub-foot x 3
liner-dome
crown-aes
shell-crown
badge
