adxb-pxthxn/pizza-oven/(list of files, cad)

Other CAD files:
design/stream-1/grey-ghost/grey-ghost.step
design/stream-1/silverwing/silverwing.step
design/stream-1/vermithor/vermithor.step
design/stream-2/dreamfyre/dreamfyre-pit.step
design/stream-2/meleys/meleys-pit.step
design/stream-2/meraxes/meraxes.step
design/stream-2/sheepstealer/sheepstealer-pit.step
design/stream-2/silverwing/silverwing.step
design/stream-2/syrax/syrax-pit.step
design/stream-2/terrax/terrax.step
design/stream-2/urrax/urrax.step
design/stream-2/vermithor/vermithor-pit.step
design/stream-2/vhagar/vhagar-pit.step
design/stream-2/arrax/arrax-pit.step
design/stream-2/balerion/balerion-pit.step
design/stream-2/cannibal/cannibal.step
design/stream-2/caraxes/caraxes-pit.step
design/stream-2/dreamfyre/dreamfyre.step
design/stream-2/meraxes/meraxes-pit.step
design/stream-2/morghul/morghul.step
design/stream-2/quicksilver/quicksilver.step
design/stream-2/sheepstealer/sheepstealer.step
design/stream-2/shrykos/shrykos-pit.step
design/stream-2/silverwing/silverwing-pit.step
design/stream-2/syrax/syrax.step
design/stream-2/terrax/terrax-pit.step
design/stream-2/urrax/urrax-pit.step
design/stream-2/vermithor/vermithor.step
design/stream-2/vhagar/vhagar.step
design/stream-1/arrax/arrax.FCStd
design/stream-1/caraxes/caraxes.FCStd
design/stream-1/grey-ghost/grey-ghost.FCStd
design/stream-1/seasmoke/seasmoke.FCStd
design/stream-1/sheepstealer/sheepstealer.FCStd
design/stream-1/silverwing/silverwing.FCStd
design/stream-1/stormcloud/stormcloud.FCStd
design/stream-1/tessarion/tessarion.FCStd
design/stream-1/tyraxes/tyraxes.FCStd
design/stream-1/vermax/vermax.FCStd
design/stream-1/vermithor/vermithor.FCStd
design/stream-2/arrax/arrax.FCStd
design/stream-2/arrax/arrax.step
design/stream-2/balerion/balerion.FCStd
design/stream-2/cannibal/cannibal.FCStd
design/stream-2/caraxes/caraxes.FCStd
design/stream-2/caraxes/caraxes.step
design/stream-2/dreamfyre/dreamfyre.FCStd
design/stream-2/meleys/meleys.FCStd
design/stream-2/meraxes/meraxes.FCStd
design/stream-2/morghul/morghul.FCStd
design/stream-2/quicksilver/quicksilver.FCStd
design/stream-2/seasmoke/seasmoke.FCStd
design/stream-2/sheepstealer/sheepstealer.FCStd
design/stream-2/shrykos/shrykos.FCStd
design/stream-2/silverwing/silverwing.FCStd
design/stream-2/syrax/syrax.FCStd
design/stream-2/terrax/terrax.FCStd
design/stream-2/urrax/urrax.FCStd
design/stream-2/vermax/vermax.FCStd
design/stream-2/vermithor/vermithor.FCStd
design/stream-2/vhagar/vhagar.FCStd
design/tailgate/models/angas-430-cutaway.stl
design/tailgate/models/angas-430-exploded.stl
design/tailgate/models/angas-430-stowed.stl
design/tailgate/models/angas-430-tripod.stl
design/tailgate/models/angas-430.stl
design/variants/moondancer/moondancer.FCStd
design/variants/moondancer/moondancer.stl
design/variants/morning/morning.FCStd
design/variants/morning/morning.stl
