adxb-pxthxn/pizza-oven/docs/assembly-guide.md

# Pizza Oven Assembly Guide

Step-by-step assembly instructions, torque specifications, tool lists, and safety precautions will be documented here once the physical architecture and manufacturing methods are decided.

## Structure Template

1. **Safety Warnings & PPE**
2. **Required Tools & Fasteners**
3. **Exploded Assembly Overview**
4. **Step-by-Step Build Instructions**
5. **Initial Commissioning, Curing & Test Procedures**
