adxb-pxthxn/pizza-oven/design/stream-1/CHANGELOG.md

# Changelog

- Stormcloud: rolled half-barrel, sky plate, free 6 mm steel floor, arched mouth, 34.2 kg, floor 309°C, open cool-down 0.67× the Tread, 23 min heat-up.
- Tyraxes: door parked on the port cheek, cowl 48 mm, gas 360°C, 34.1 kg, floor 301°C, scorch 130 s, shut heat-up 14 min.
- Arrax: 480 mm plate, 4 mm stops, 90 mm launch sill, 35.4 kg, floor 301°C, 49 mm beside the pizza, cool-down still 0.66× the Tread.
- Vermax: barrel 780 mm, sky plate slid back, 240 mm broil bay with five rods in the mouth, 37.3 kg, pizza floor still 301°C with the plate forward, cool-down 0.66× the Tread.
- Tessarion: bread pose, door shut 3 mm clear of the sill, plate forward, 37.2 kg, bread floor 214°C, same cool-down.
- Sunfyre: shut-door leak is 3% of the open mouth. Gas 230°C holds the bread floor at 211°C. Gas 260°C would hold 240°C. Same solid as Tessarion.
- Rails: every solid carries the full slide, 590 mm on the 680 mm barrel and 690 mm on the 780 mm barrel. Tessarion matches Vermax at 37.3 kg.
- Grate: the five rods stay in the 240 mm bay on Tessarion as well. The plate clears them by about 15 mm when it slides forward.
- Vermithor: 75 mm under the whole floor. Bare bay underside 56°C. Pizza floor 305°C, 38.0 kg, cool-down 0.67× the Tread. Bread gas 230°C holds 216°C.
- Seasmoke: 20 mm module scribed on the sill, cheek straps carry the handles, steel tray in the bay 44 mm under the grate, 38.9 kg. No timber on the skin.
- Sheepstealer: skin is a laser blank, half-ring ends 2 mm clear of the liner, 4 mm gland in the mouth frame, 38.5 kg. No tilt. The line is under the base.
- Silverwing: the door is the mouth arch on two straps, pin outboard of the skin, parks along the port side, 38.7 kg. Shut, it clears the sill by 3 mm.
- Grey Ghost: the hinge post laps the floor, weld 2173 mm³ instead of a 90 mm³ tack. Same door, 38.7 kg.
- Caraxes: 11 mm finger hollow in the middle of the grip, 3 mm arris, ends left square, 38.7 kg. The gate records volume, centre of mass, and closed shells.
- Caraxes shop sheet: `design/stream-1/caraxes/BUILD.md`, machine, sequence, jigs, and fits for Makerspace Adelaide.
- Inspiration re-read: five Wright lessons. The 20 mm sill grid and the flat skin stay. Veneer, a flush crane niche, side flues, and levelling screws stay off Caraxes.
