adxb-pxthxn/pizza-oven/design/stream-2/CHANGELOG.md

# Stream 2 changelog

- Vermax: three-module tunnel, floating 4 mm steel deck, rear gutter and soffit, door. Ready 36.1 kg, hood 15.9 kg. Skin 54.1°C. Heat-up 13 min. Bread window 63 min. Pack cool-down 27 min door open. FreeCAD gates passed (34.3 kg solid, press fits only).
- Arrax: the crown follows the soffit. Tall brow only for a 260 mm launch, mouth 424 × 185, body ceiling 110 mm. Grate stays in the pit. Ready 32.2 kg (pit 10.4, hearth 9.0, hood 12.8). Skin 55.0°C. Heat-up 10 min. Bread window 59 min. Pack cool-down 27 min door open.
- Shrykos: the Arrax step becomes a 45° brake fold. Mouth still 424 × 185. Ready 30.6 kg, hood 11.2 kg. Skin 55.0°C. Heat-up 10 min. Bread window 60 min. Pack cool-down 27 min door open.
- Morghul: the fold is the joint. Brow 5.1 kg, tunnel 6.1 kg, hearth 9.0 kg, pit 10.4 kg. Ready 30.6 kg. Mouth 424 × 185. Skin 55.0°C. Heat-up 10 min. Bread window 60 min. Pack cool-down 27 min door open.
- Seasmoke: the brow foot butts the skin corner and sits 0.6 mm above a tunnel shelf. The brow has its own jarrah grip. Grate rods move up 32 mm. Ready 31.0 kg (pit 10.5, hearth 9.0, brow 5.3, tunnel 6.2). Mouth 424 × 185. Skin 55.0°C. Heat-up 10 min. Bread window 60 min. Pack cool-down 27 min door open.
- Caraxes: the roof over the pizza rises to 150 mm. A plate at 100 mm hangs behind the pie for the steak, rack 50 mm under it. Ready 32.4 kg (pit 10.5, hearth 9.0, brow 5.1, tunnel 7.8). Mouth 424 × 185. Skin 55.0°C. Heat-up 11 min. Bread window 61 min. Pack cool-down 27 min door open.
- Meleys: a jarrah bail on the sill, 36 mm off the steel. The hearth is 9.1 kg and lifts by wood. Ready 32.5 kg. Mouth 424 × 185. Skin 55.0°C. Heat-up 11 min. Bread window 61 min. Pack cool-down 27 min door open. The grip is 39.5°C on a 300°C root.
- Syrax: the damper shuts across the flue, with a tang out the top. Bread pose. Ready 32.6 kg (pit 10.5, hearth 9.1, brow 5.2, tunnel 7.8). Mouth 424 × 185. Skin 55.0°C. Heat-up 11 min. Bread window 61 min. Pack cool-down 27 min door open.
- Sheepstealer: ceramic rope in the door gap, four strips, clear of the skin. Ready 32.6 kg (pit 10.5, hearth 9.1, brow 5.2, tunnel 7.8). Mouth 424 × 185. Skin 55.0°C. Heat-up 11 min. Bread window 61 min. Pack cool-down 27 min door open.
- Vermithor: the broiler plate slides forward over the steak, Y 180 to 350 at Z 100. Park it aft for the pizza. Ready 33.8 kg (pit 10.5, hearth 9.1, brow 5.2, tunnel 9.0). Mouth 424 × 185. Skin 55.0°C. Heat-up 11 min. Bread window 61 min. Pack cool-down 27 min door open. Flux stays 13.8 kW/m².
- Silverwing: the same slide on 8 mm rods. The flats were more steel than the span needs. Ready 33.0 kg (pit 10.5, hearth 9.1, brow 5.2, tunnel 8.2). Mouth 424 × 185. Skin 55.0°C. Heat-up 11 min. Bread window 61 min. Pack cool-down 27 min door open. Flux stays 13.8 kW/m².
- Vhagar: a mild wind-back stored under the rear overhang, for the pit when the hood is off. Ready 33.4 kg (pit 10.8, hearth 9.1, brow 5.2, tunnel 8.2). Mouth 424 × 185. Skin 55.0°C. Heat-up 11 min. Bread window 61 min. Pack cool-down 27 min door open. Flux stays 13.8 kW/m².
- Balerion: jarrah panels stood 8 mm off the brow skin. The panel face is 21°C on a 55°C skin. Ready 33.5 kg (pit 10.8, hearth 9.1, brow 5.3, tunnel 8.2). Mouth 424 × 185. Skin 55.0°C. Heat-up 11 min. Bread window 61 min. Pack cool-down 27 min door open. Flux stays 13.8 kW/m².
- Meraxes: 24 mm of air in the door, so the outer face is 53.7°C, and a jarrah grip on it at 23°C. Ready 33.6 kg (pit 10.8, hearth 9.1, brow 5.5, tunnel 8.2). Mouth 424 × 185. Hood skin 55.0°C. Heat-up 11 min. Bread window 61 min. Pack cool-down 27 min door open. Flux stays 13.8 kW/m².
- Dreamfyre: a port pintle, 0.6 mm radial clearance, so the door turns clear of the mouth and stops on the arms. The leaf bolts to the aluminium skin. Ready 34.0 kg (pit 10.8, hearth 9.1, brow 5.8, tunnel 8.2). Mouth 424 × 185. Hood skin 55.0°C. Heat-up 11 min. Bread window 61 min. Pack cool-down 27 min door open. Flux stays 13.8 kW/m².
- Cannibal: four spacers tie the inner plate to the skin, so the pintle carries the whole door. The board steps in 8 mm and clears them by 3.2 mm. Ready 34.0 kg (pit 10.8, hearth 9.1, brow 5.8, tunnel 8.2). Mouth 424 × 185. Hood skin 55.0°C. Heat-up 11 min. Bread window 61 min. Pack cool-down 27 min door open. Flux stays 13.8 kW/m².
- Quicksilver: the hinge arms leave the door's height. The lower arm welds to the pit. The upper barrel is on the brow and lifts off the pin. Ready 34.0 kg (pit 11.0, hearth 9.1, brow 5.7, tunnel 8.2). Mouth 424 × 185. Hood skin 55.0°C. Heat-up 11 min. Bread window 61 min. Pack cool-down 27 min door open. Wood stays 3.4 mm off hot steel. Flux stays 13.8 kW/m².
- Urrax: the hood grip stands on a mild pad. Two 1.5 mm plates sandwich the tunnel skin. The posts clear the skin by 1.5 mm. Ready 34.0 kg (pit 11.0, hearth 9.1, brow 5.7, tunnel 8.3). Mouth 424 × 185. Hood skin 55.0°C. Heat-up 11 min. Bread window 61 min. Pack cool-down 27 min door open. Flux stays 13.8 kW/m².
- Terrax: the brow grip stands on the same pad. Posts clear the skin by 1.5 mm. Ready 34.1 kg (pit 11.0, hearth 9.1, brow 5.8, tunnel 8.3). Mouth 424 × 185. Hood skin 55.0°C. Heat-up 11 min. Bread window 61 min. Pack cool-down 27 min door open. Flux stays 13.8 kW/m². Shop sequence in `terrax/BUILD.md`.
- Terrax: the door grip stands on the same pad. Two 1.5 mm plates sandwich the 0.8 mm door skin. Posts clear that skin by 1.5 mm. Ready 34.1 kg (pit 11.0, hearth 9.1, brow 5.8, tunnel 8.3). Mouth 424 × 185. Hood skin 55.0°C. Heat-up 11 min. Bread window 61 min. Pack cool-down 27 min door open. Flux stays 13.8 kW/m².
- Terrax: the sheet module is 20 mm, for the pads, the wind-back, and a 100 mm rivet pitch. The mouth and the deck stay on the pizza. Aluminium is flat blanks. The cowl is two plates at 45° with a gap at the module joint. The bail lifts the hearth. The tailgate is the stand.
