adxb-pxthxn/pizza-oven/(commit log)

2026-10-18 feat: initial open-source physical engineering setup for pizza-oven
    - Install Ryan's Anatomy skill (.agents/skills/anatomy)
    - Add mechanical-engineering skill with bend allowance and thermal expansion tools
    - Add code-cad skill with parametric model generator and DFM validator
    - Add oshwa-hardware skill with open-source hardware compliance auditor
    - Add oven-thermodynamics skill with 500°C chamber and insulation model
    - Generate 12-inch and 16-inch parametric CAD exports (DXF, SVG, OpenSCAD, STL, OBJ)
    - Add OSHWA.md, CERN-OHL-P v2 & CC-BY-4.0 licenses, and comprehensive BOM
    - Add assembly guide, thermal calculations, and engineering specifications
    [base_floor_12in.dxf, base_floor_16in.dxf, bom.csv, folding_leg_12in.dxf, folding_leg_16in.dxf, inner_dome_12in.dxf, inner_dome_16in.dxf, outer_shroud_12in.dxf]
2026-10-18 feat: add cross-agent (Antigrav & Cursor) and material sourcing skills
    - Add cross-agent-coordination skill with Handover protocol and state machine
    - Add cursor-sync skill with .cursor/rules/*.mdc, .cursorrules, and symlinks
    - Add multi-agent-review skill with automated Maker/Critic review harness
    - Add material-sourcing skill & automation for local vendors, Gumtree, FB Marketplace, and scrap
    - Generate docs/HANDOVER.md and docs/sourcing-report.md [agent:antigrav]
2026-10-18 refactor: cleanse all premature design assumptions and hardcoded specs
    - Remove assumed 12-inch and 16-inch CAD models, DXFs, STLs, and generator scripts
    - Cleanse bom.csv into a clean, un-opinionated OSHWA-compliant template
    - Remove assumed engineering specs, assembly guides, and thermal calculation docs
    - Cleanse AGENTS.md, GEMINI.md, README.md, OSHWA.md, and .cursor/rules/*.mdc
    - Reset task board and handover state to wait for explicit user design requirements [agent:antigrav]
    [base_floor_12in.dxf, base_floor_16in.dxf, bom.csv, folding_leg_12in.dxf, folding_leg_16in.dxf, inner_dome_12in.dxf, inner_dome_16in.dxf, outer_shroud_12in.dxf]
2026-10-18 feat(design): add Angas 430 design baseline [agent:cursor] (#5)
    Copy the tailgate design tree, its parametric rebuild package, and the Angas BOM from design/tailgate-oven without merging that branch or the research tree.
    [angas-430-cutaway.step, angas-430-cutaway.stl, angas-430-exploded.step, angas-430-exploded.stl, angas-430-stowed.step, angas-430-stowed.stl, angas-430-tripod.step, angas-430-tripod.stl]
2026-10-18 feat(variants): add Morning and Moondancer prototypes [agent:cursor] (#7)
    Bring the PR #6 delta from cursor/angas-dragon-variants-d981 onto main.
    Research, REPORT, and bom-study files stay out. No extra tailgate-oven
    files were required for these modules to import.
    [bom.csv, moondancer-exploded.step, moondancer.FCStd, moondancer.step, moondancer.stl, morning-exploded.step, morning.FCStd, morning.step]
2026-10-18 Add a budgeted Claude Opus 5.5 harness for CAD tasks (#10)
    * feat(opus): add a budgeted Claude Opus 5.5 harness [agent:cursor]
    Resolve the model from GET /v1/models, cache the system prompt and tool
    list, and ledger input, output, and cache tokens against a $21 cap.
    declare_done stays separate from check(), which measures mass, renders,
    and build docs instead of trusting the model's report.
    * docs(handover): record the Opus harness session [agent:cursor]
    ---------
2026-10-18 Stream 2: Terrax flats on a 20 mm sheet module (#9)
    * feat(stream-2): size Stormcloud as a modular stack [agent:cursor]
    Three modules, a floating mild-steel deck, and a rear-gutter soffit. Mass, bow, sag, skin, heat-up, and cool-down are in the shared parameter model.
    * refactor(stream-2): name the first module stack Vermax [agent:cursor]
    Stream 1 already used Stormcloud. Vermax is the next young dragon. The sized geometry is unchanged.
    * feat(stream-2): model Vermax in FreeCAD [agent:cursor]
    The managed agent returned the builder as Stormcloud. Renamed to Vermax
    and cut the por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
    [arrax-pit.step, arrax.FCStd, arrax.step, balerion-pit.step, balerion.FCStd, balerion.step, bom.csv, cannibal-pit.step]
2026-10-18 Stream 1: long-vault prototypes after Morning (#8)
    * feat(stream): size Stormcloud long-vault heat and mass [agent:cursor]
    Free 6 mm steel floor, sky plate, and 75 mm fibre. Shop stack is 34.5 kg,
    pizza floor 302 C, open cool-down 0.66 times the Tread.
    * feat(stream): add Stormcloud barrel solid [agent:cursor]
    Half-barrel with an arched mouth, free steel deck, and sky plate.
    Pairwise interference is zero apart from the four gidgee ferrule press fits.
    Argon sandbox did not update after create, so this solid was built and checked locally.
    * feat(stream): park Tyraxes door and short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
    [arrax.FCStd, arrax.step, bom.csv, caraxes.FCStd, caraxes.step, grey-ghost.FCStd, grey-ghost.step, seasmoke.FCStd]
2026-10-19 feat(bench-lathe): draw the day-one bench spindle [agent:cursor]
    One shaft on two pillow blocks, geared 2:1 from the treadmill motor.
    The figure turns, drills, sands, and takes a light milling cut.
2026-10-19 docs(bench-lathe): add the morning shop sheet and BOM [agent:cursor]
    The bed can be cut whether or not the treadmill is in the room.
    SN-100 through SN-220 keep the oven part numbers alone.
    [bom.csv]
